hatchna/INDX/README.md

This is my personal fork for the INDX configuration files and macros. These may or may not be compatible with your printer. YMMV.

Much credit for some of these customizations goes to charliemayall and 3DPrintDemon who provided some of the macro adjustments and ideas that are implemented here.

https://github.com/charliemayall/INDX/

https://github.com/3DPrintDemon/DEMON_INDX

Other modifications are my own.

# INDX Wiki

> The community knowledge base for the Bondtech INDX, an induction-based automatic tool changer for open-platform XY-head 3D printers.

---

## Table of Contents

**Part 1: What is INDX?**

1. [What is INDX?](#what-is-indx)
2. [How It Works](#how-it-works)
3. [Kits & What's in the Box](#kits--whats-in-the-box)
4. [Supported Printers](#supported-printers)
5. [Technical Specifications](#technical-specifications)
   - [Part Cooling](#part-cooling)

**Part 2: Getting Started**

6. [Requirements & Preparation](#requirements--preparation)
7. [Installation](#installation)
   - [Hardware Installation](#hardware-installation)
   - [Firmware Configuration](#firmware-configuration)
     - [Klipper / Kalico](#klipper)
       - [INDX macro files](#indx-macro-files)
       - [Required Klipper sections](#required-klipper-sections)
       - [Load cell probe](#load-cell-probe)
       - [Automated dock X measurement](#automated-dock-x-measurement-built-in)
       - [Homing override](#homing-order-important)
         - [Seat check](#seat-check)
     - [RRF (RepRapFirmware)](#rrf-reprapfirmware)
   - [Initial Startup](#initial-startup)

**Part 3: Configuration**

8. [Configuration](#configuration)
   - [Dock Position Calibration](#dock-position-calibration)
     - [Finding dock_y](#finding-dock_y-y-fully-seated-position)
     - [Finding dock_x](#finding-dock_x-x-tool-centre)
   - [Tool Offsets](#tool-offsets)
     - [Method 1: Print and adjust](#method-1-print-and-adjust-free-no-extra-hardware)
     - [Method 2: Nudge](#method-2-nudge-automatic-requires-small-hardware)
     - [Method 3: Nozzle camera + CAL_ONE/TWO/THREE](#method-3-nozzle-camera-most-precise-xy-higher-cost)
     - [Z offset: CAL_Z](#z-offset-calibration)
   - [Temperature & Induction Settings](#temperature--induction-settings)
   - [Speed & Acceleration](#speed--acceleration)

**Part 4: Day-to-day Use**

9. [Using INDX](#using-indx)
   - [Loading Filament into Tools](#loading-filament-into-tools)
   - [Performing Tool Changes](#performing-tool-changes)
   - [Slicer Setup](#slicer-setup)

**Part 5: Designing for INDX**

10. [Designing for INDX](#designing-for-indx)
    - [Dock Design](#dock-design)
    - [Part Cooling (custom)](#part-cooling-1)
    - [CAD Files & Templates](#cad-files--templates)

**Part 6: Maintenance, Support & Community**

11. [Maintenance](#maintenance)
    - [Nozzle clog: cold pull procedure](#nozzle-clog-cold-pull-procedure)
12. [Troubleshooting](#troubleshooting)
13. [FAQ](#faq)
14. [Community & Contributing](#community--contributing)

---

**Part 1: What is INDX?**

---

## What is INDX?

INDX (INduction Dynamic eXtruder) is Bondtech's automatic tool-changer system for FDM 3D printers. It enables printing with multiple materials, colors, or nozzle sizes in a single print, with near-zero purge waste and tool changes in around 14 seconds. Run two tools or ten; scale your setup as far as your build space allows.

Unlike filament-switcher systems, INDX is a true tool changer: each tool carries its own filament directly. There is no shared filament path and no purge block required.

Unlike traditional mechanical tool changers, INDX uses wireless induction heating, so the passive tools contain **no wires, no heaters, no thermistors, and no electronics**. This makes each tool dramatically cheaper and mechanically simpler.

INDX is sold by Bondtech as a **Development Kit** for open CoreXY printers. Prusa Research has built an official first-party integration for the **CORE One** and **CORE One L**, sold directly through Prusa.

| | INDX Development Kit | Prusa CORE One / CORE One L |
|---|---|---|
| **Sold by** | Bondtech ([bondtech.se](https://www.bondtech.se)) | Prusa Research ([prusa3d.com](https://www.prusa3d.com)) |
| **For** | Most CoreXY printers with open firmware | Prusa CORE One / CORE One L |
| **Setup** | Self-managed (community-supported) | Plug-and-play |
| **Smart Head** | See [bondtech.se](https://www.bondtech.se) | See [prusa3d.com](https://www.prusa3d.com/applications/prusa-3d-printers-with-bondtech-indx_243519/) |
| **Passive Tools** | See [bondtech.se](https://www.bondtech.se) | See [prusa3d.com](https://www.prusa3d.com/applications/prusa-3d-printers-with-bondtech-indx_243519/) |

This wiki focuses on the **INDX Development Kit** and community integrations. For the Prusa integration, refer to [Prusa's documentation](https://www.prusa3d.com/applications/prusa-3d-printers-with-bondtech-indx_243519/).

---

## How It Works

INDX is built around two components: a single active **Smart Head** that stays on the gantry, and a set of interchangeable **Thin Passive Tools** parked in a dock.

### Smart Head

The single active unit that travels on the gantry. Contains all expensive and active components:

- **Induction coil (IN)**: wirelessly heats the nozzle of whichever passive tool is currently mounted on the Smart Head.
- **IR thermopile sensor**: reads nozzle temperature without physical contact. Also reports ambient temperature and nozzle surround temperature for monitoring.
- **Dynamic eXtruder (DX)**: self-adjusting dual-drive extruder with automatic tension mechanism.
- **Load cell**: used for sensing tool/nozzle touch.
- All wiring, electronics, and motion stays here; nothing transfers to the passive tools

### Thin Passive Tools

Interchangeable tools parked in a dock within reach of the gantry. Each tool contains a filament path and a specially designed nozzle, and nothing else. No wires, no heaters, no thermistors, no electronics. Heat is delivered wirelessly by the Smart Head's induction coil when the tool is picked up; the tool cools passively when deposited back in the dock.

Two variants are available, both built from steel:

- **CHT (Core Heating Technology)**: splits filament into three strands internally for faster melting and higher flow rates. The standard choice for most materials except abrasive materials. Available in common sizes.
- **Standard (non-CHT)**: straight-through melt zone with lower back-pressure, optimized for soft flexible filaments (TPU, TPE).

Tools are held in the Smart Head by a high-precision **Maxwell coupling** (a 3-point kinematic coupling that self-aligns the tool to the exact same position every time it is picked up), ensuring micron-level repeatability on every tool change. In practice this means you calibrate your tool offsets once, and they stay correct across thousands of tool changes.

### Tool Change Sequence

1. Smart Head moves to the dock and deposits the current tool
2. Smart Head picks up the next tool
3. Induction coil heats the new nozzle to printing temperature (~4-10 seconds)
4. Printing resumes

**Total tool change time: ~14 seconds**, depending on temperature delta, priming, and travel distance.

Because every material runs in its own dedicated nozzle, there is no cross-contamination between materials; purging is not required. The only material used after a tool change is a small **prime** at the start of printing: when a nozzle heats up, the filament in the melt zone re-melts and pressure needs to be rebuilt before extrusion is consistent. Priming pushes a small amount of filament through to establish that pressure, ensuring the first line of print is correctly extruded. Because each tool also cools passively when separated from the Smart Head, oozing is minimal.

---

## Kits & What's in the Box

### Development Kit

The INDX Development Kit comes as a **base kit** (the core hardware you need to get started) plus **tools** and **accessories** you choose to match your printer and setup.

#### What's in the box

Every Development Kit includes:

| Component | Description |
| --- | --- |
| **Bondtech INDX Smart Head** | The active unit: induction coil, contactless IR temperature sensor, DX extruder, and all electronics. One per printer. **Does not include a Thin Passive Tool**; tools are ordered separately. |
| **Bondtech INDX Link Board** | USB/CAN bridge between your host computer and the Smart Head. Includes 330 mm AWG18 power cables with horseshoe connectors for PSU screw terminals. A USB cable from the Link Board to your host is not included; see [Link Board](#link-board) for requirements. |
| **Crimp & connector kit** | Crimps and connectors for terminating accessories to the Bondtech INDX PCB: part cooling fan, LED, endstop, and USB devices. |

#### Tools

Thin Passive Tools are the interchangeable tool heads that do the actual printing. Choose quantity, nozzle type, and nozzle size when ordering. You need at least one tool to print, and one per material or color you want to run simultaneously.

| Option | Nozzle sizes | Best for |
| --- | --- | --- |
| **CHT (Core Heating Technology)** | 0.4 / 0.5 / 0.6 / 0.8 / 1.0mm | Most materials: PLA, PETG, ABS, ASA, TPU, TPE, PVA, BVOH, HIPS, PC, Nylon, PP, PBT, unfilled PC blends, and other non-abrasive filaments |
| **Standard (non-CHT)** | 0.25 / 0.4mm | Flexible filaments (TPU, TPE) and sensitive composites |

See [Thin Passive Tools](#thin-passive-tools) in the Technical Specifications for full details on each variant.

#### Accessories

Select the accessories that match your printer when ordering:

| Accessory | Options | Notes |
| --- | --- | ----- |
| **Bondtech INDX Link Cable** | Choose length | XT30 2+2 cable (24V, GND, CAN+, CAN−) with a shield connected to GND on the Link Board, from the Link Board to the Smart Head. Red/black wires carry power, yellow/white carry CAN H/L. Choose the length that fits your wiring run. See note below. |
| **Tool Dock** | Pre-made SLS hardware or STL/STEP files | Bondtech's ready-made docks are designed for MakerBeam XL 15×15. Or download the files and print your own; the standard 1515 body suits both profiles. |
| **X-Carriage adapter** | MGN12H option for 6mm belts, or download files | Required to mount the Smart Head to your carriage. Available for common CoreXY standards; check the shop or download from GitHub. |

> **What is CAN bus?** CAN bus is a communication standard that lets multiple devices share a single cable. You don't need to understand the protocol in depth; the Link Board handles it for you. In practice it means the Smart Head connects to the Link Board via just one 4-wire cable (carrying both power and data) instead of the bundle of wires a conventional toolhead needs. CAN is currently only supported on RRF; USB is used for Klipper/Kalico.
>
> **Choosing cable length:** Measure the wiring run from your Link Board mounting location to the Smart Head along the actual path the cable will travel (over the gantry, not straight-line). Add some slack. When in doubt, order longer. A cable that is too short cannot be extended, and excess length can be coiled and managed.

> **Integration note:** The Development Kit does not include a pre-configured printer profile or plug-and-play setup. You are responsible for integrating INDX with your printer's firmware and mechanics. The community provides configs and guides for common platforms; see [Supported Printers](#supported-printers) and [Community & Contributing](#community--contributing).

---

## Supported Printers

### First-party integrations

Prusa Research has built an official first-party integration for their CoreXY printers. These are sold and supported directly by Prusa, not through the INDX Development Kit.

| Printer | Status | Notes |
| --- | --- | ----- |
| Prusa CORE One | Available | Sold by Prusa Research. Plug-and-play. Supports up to 8 tools. See [prusa3d.com](https://www.prusa3d.com/applications/prusa-3d-printers-with-bondtech-indx_243519/) for details. |
| Prusa CORE One L | Coming later | First-party Prusa integration, availability timeline TBD. Supports up to 8 tools. |

### Officially recognized integrations

Beyond the first-party Prusa integration, a few community-built integrations are solid enough that Bondtech points people at them by name. Each comes with ready-to-print parts and the installation files needed to mount INDX on that machine.

They are not Bondtech products. They are hosted externally and maintained by their designers, so questions about the parts themselves belong with them rather than in this repository. Recognized here means we rate the work, not that we support it.

| Printer | Designer | Files |
| --- | --- | ----- |
| Sovol SV08 OG & SV08 Max | 3DPrintDemon | [Printables](https://www.printables.com/model/1771164-official-indx-sovol-sv08-og-sv08-max-integrations) |
| Voron Trident R2 | Steve — Voron team, designer of the Trident | [Printables](https://www.printables.com/model/1761163-trident-r2-bondtech-indx-mods) |

### Unverified community builds

INDX runs on a wide range of CoreXY printers, far more than Bondtech could ever test and support directly. What makes that possible is community members who've done the integration work on their own printer and shared what they learned. The printers below are known to work; what varies is whether anyone has published parts for them yet.

> ⚠️ **Nothing in this table has been checked by Bondtech.** We have not printed these parts, measured them, or run them on a machine here. Listing a build is not an endorsement and says nothing about whether the geometry is right. Read them the way you would read any stranger's remix: check a dock against [Dock Design](#dock-design) before printing it, since dock geometry that misses those constraints gives unreliable tool changes rather than an obvious failure. Questions about these parts belong with whoever made them, not with Bondtech.

| Printer | Build | Source |
| --- | ----- | --- |
| Voron 2.4 | Full conversion parts set: X-carriage, tool holder, XY joint, front idlers, Z bearing block with Y endstop, Z chain mount | [karasgit/INDX-for-Voron-2.4](https://github.com/karasgit/INDX-for-Voron-2.4), with a [walkthrough video](https://www.youtube.com/watch?v=topIOL-b3Gw) by Emplikac 000 |
| RatRig V-Core | None published yet | — |
| Custom CoreXY | None, and none expected: mounting is specific to your machine | Any CoreXY with open firmware works; see [Requirements](#requirements--preparation) |

The [Bondtech Discord](https://discord.gg/XDX9jDXN6e) has channels for specific printers, which is the best place to find someone running the same platform and ask how far along they got.

**Your printer isn't listed?** If you've got INDX running on it, that integration belongs here. Submit a pull request on [github.com/BondtechAB/INDX](https://github.com/BondtechAB/INDX) and you'll save the next person hours of work. See [Contributing a printer integration](#contributing-a-printer-integration) for what to include.

---

## Technical Specifications

*Specifications are preliminary and subject to change.*

### Smart Head

| Specification | Value |
| --- | ----- |
| Maximum operating voltage | 24V |
| Maximum nozzle temperature | 300°C |
| Maximum ambient operating temperature | 60°C |
| Flow rate | 40mm³/s *(measured at 220°C with 25°C ambient; lower rates achievable depending on nozzle size)* |
| Nozzle heat-up time | ~4-8 seconds |
| Tool change time | ~14 seconds *(highly dependent on temperature, priming, and travel distance)* |
| Power consumption | ~60W |
| Tool change mechanism | Maxwell coupling (3-point kinematic) |
| Heater type | Induction coil |
| Temperature sensor | Wireless & contactless IR thermopile |
| Nozzle sensor | Load cell (bi-directional) |
| Extrusion system | Direct Drive |
| Filament pre-tension | Self-adjusting (DX extruder, dual-drive with automatic tensioning) |
| Extruder chassis material | Aluminium |
| Cowling material | SLS-printed PA12 |
| Minimum tool center-to-center distance | 34mm bare; **41mm** with Bondtech part cooling solutions |
| Weight | 345g *(including one tool)* |
| Dimensions | See [reference geometry](#cad-files--templates) |

### Part Cooling

INDX uses a modular part cooling system. Cooling solutions snap onto the outside of the Smart Head cowlings, making it easy to swap between setups without tools. Three options are supported:

| Option | Description |
| --- | --- |
| **Dual 40×10 fans** | Two radial blower fans mounted symmetrically for balanced airflow around the nozzle |
| **CPAP** | High-flow airflow from a remote CPAP blower unit, routed via a flexible tube to the Smart Head, keeping weight off the gantry |

The right choice depends on your materials and print speed requirements. The dual 40×10 connect to the part cooling fan output on the Bondtech INDX PCB. The CPAP blower is a remote unit mounted elsewhere on the printer and connects to your main board instead; only the airflow tube routes to the Smart Head.

Printable ducts for both options are available in [CAD Files & Templates](#cad-files--templates).

### Bondtech INDX PCB

The Bondtech INDX PCB is mounted inside the Smart Head and is the central electronics board for the system.

**Electronics**

| Specification | Value |
| --- | ----- |
| Stepper driver | TMC2240 |
| Stepper run current | 0.6A |
| Extruder rotation distance | 5.7mm |
| Built-in accelerometer | LIS2DW |
| Built-in rotary encoder | AS5047D (magnetic) |
| Built-in load cell | *(specifications to be confirmed)* |

**Connectors**

| Connector | Pins | Notes |
| --- | ---- | ----- |
| Motor | Coil A+, Coil A−, Coil B+, Coil B− | DX extruder stepper motor |
| Fan | TACHO, FAN+, GND | Supports tachometer feedback |
| LED | 5V (VBUS), NP OUT, GND | NeoPixel compatible |
| Endstop | 3V3, SIGNAL, GND | 3.3V logic level |
| USB | VBUS, DP+, DP−, GND, GND | Supports accessories such as camera or Beacon probe scanner. **The DP+/DP− silkscreen is swapped — see [USB data pins](#usb-data-pins-are-swapped)** |
| CAN termination jumper | — | Enable/disable CAN bus termination |
| CAN Reset jumper | — | Puts the board into DFU mode for firmware flashing; remove after flashing |
| Communication switch | CAN / USB | Selects between CAN-FD and USB communication modes; must match the switch position on the Link Board |

**Status LEDs**

| Label | Colour | Meaning |
| ----- | --- | --- |
| VIN | Blue | 24V power present |
| 3V3 | Green | 3.3V onboard regulator active |
| ACTIVITY | Green | CAN-FD bus activity (other than regular time-sync messages) |
| STATUS | Red | Flashes at ~1Hz in sync with the main board = CAN time sync OK; rapid continuous flashing = no CAN sync; startup error codes (see table below) |

On first boot or after a failed flash, the STATUS LED may flash a startup error code rather than the normal 1Hz pattern. The pattern is: slow blinks (group 1) pause, then fast blinks (group 2). If this happens, reflash the firmware.

**Startup error codes**

| Error | Slow blinks | Fast blinks | Description |
| ----- | --- | --- | --- |
| ErrorTempMin | 1 | 1 | Measured temperature too low |
| ErrorTempMax | 1 | 2 | Measured temperature too high |
| ErrorTempAmbientMin | 1 | 3 | Ambient temperature too low |
| ErrorTempAmbientMax | 1 | 4 | Ambient temperature too high |
| ErrorTempDiff | 1 | 5 | Requested temperature differs significantly from measured temperature |
| ErrorHeatMax | 2 | 1 | Heater on at max power for too long |
| ErrorHeatInput | 2 | 2 | Heater enable request active for too long |
| ErrorInternalTemp | 5 | 3 | IR sensor self-test failed at boot |
| ErrorInternalUart | 5 | 4 | Internal UART fault |
| ErrorInternalEnable | 5 | 5 | Internal enable fault |

**Front INDX LED states**

The Smart Head uses a NeoPixel-compatible LED array on the front face to communicate its current state during normal operation. These are the same LEDs that display startup error codes.

| State | Colour | Pattern |
| ----- | --- | --- |
| Heating | Amber (RGB 255, 191, 0) | Breathing at 0.5 Hz (sine); brightness starts at 0 and increases as temperature approaches target |
| Cold / at ambient | Green | Solid |
| At target temperature | Amber | Solid |
| Cooling down from hot | Blue | Solid |
| DFU (firmware update) mode | Blue | Blinking |
| Load cell transient (filament gripped) | Purple | Single fast flash (~200 ms), then returns to previous state; effect is suppressed while the stepper motor is energised |

**FFC cable warning**

The Smart Head contains two PCBs (INDX VF PCB and INDX MCU PCB) connected by 20-way FFC (Flexible Flat Cable) connectors. If you ever need to disconnect and reconnect them during servicing:

- Insert the cable straight; inserting at an angle is easy to do and will short pins. Powering up with a shorted FFC will likely damage the board.
- The latch direction on the INDX MCU PCB FFCs is counter-intuitive: the latch is **unlocked when up**. After inserting the cable, push the latch **down toward the PCB** to lock it.

### Link Board

Bondtech INDX Link Board

The Link Board is a required component of every INDX Development Kit setup. It sits between your host computer and the Smart Head, acting as the USB/CAN bridge and providing several protection features that make the connection stable and safe.

**Why the Link Board is required**

The Link Board caps USB communication speed to **12 Mbps (Full Speed)**. While this is lower than the theoretical USB 2.0 maximum, it is intentional: Full Speed USB is dramatically more stable in electrically noisy printer environments than High Speed (480 Mbps). In practice this means fewer dropouts and disconnects, and a much more reliable connection to the Smart Head.

**Protection features**

| Feature | What it does |
| --- | --- |
| **USB isolator** | Electrically isolates the Smart Head from your host computer. Any electrical fault or noise on the printer side cannot travel back through the USB cable to your Raspberry Pi or PC. |
| **Reverse polarity protection** | Prevents damage if the 24V power input is connected with reversed polarity. |
| **4A fuse** | Protects the power input. If something goes wrong on the 24V side, the fuse blows before damage can propagate further. |

**Communication switch**

The Link Board has a switch to select between **USB** and **CAN** communication modes. This must match the switch position on the INDX MCU PCB inside the Smart Head — both boards must be set to the same mode, or the connection will not work. See [Switch configuration](#3-wiring) for reference images showing the correct switch positions on the Smart Head side.

**USB cable (not included)**

A USB cable from the Link Board to your host computer is not included and must be sourced separately. Requirements:

- **Data cable, not a charge-only cable.** Charge-only cables omit the data lines entirely and will not work. Verify the cable is rated for data transfer before using it.
- **Correct impedance.** The cable must meet USB signal integrity requirements. Cheap or poorly made cables can cause dropouts even at Full Speed. Use a cable from a reputable brand.
- **Total USB run ≤ 2 meters.** The combined length of your USB cable (host to Link Board) and your INDX Link cable (Link Board to Smart Head) must not exceed 2 meters. Plan your cable routing and Link cable length selection with this in mind.

**Specifications**

| Specification | Value |
| --- | ----- |
| Host connection | USB-C |
| Printer-side connection | Link cable to Bondtech INDX PCB |
| Input power | 24V + GND from PSU |
| Included power cables | AWG18, 330mm, horseshoe connectors for PSU screw terminals |
| USB speed | 12 Mbps (Full Speed) |
| Fuse rating | 4A |
| Max total USB run | 2 meters (USB cable + Link cable combined) |

### Thin Passive Tools

All Thin Passive Tools are built from steel, contain no electronics or wiring, and use induction heating via the Smart Head. Two variants are available:

**CHT (Core Heating Technology): Standard choice for most materials**

Uses Bondtech's patented CHT internal geometry, which splits filament into three thinner strands for faster melting and higher flow rates. Recommended for PLA, PETG, ABS, ASA, TPU, TPE, PVA, BVOH, HIPS, PC, Nylon, PP, PBT, unfilled PC blends, and other non-abrasive filaments.
Not recommended for soft flexible filaments.

| Specification | Value |
| --- | ----- |
| Available nozzle sizes | 0.4 / 0.5 / 0.6 / 0.8 / 1.0mm |
| Material | Steel |
| Compatible filament diameter | 1.75mm |
| Maximum nozzle temperature | 300°C |
| Electronics | None |
| Weight | 25g |

**Standard (non-CHT): For flexible and sensitive materials**

Uses a straight-through melt zone with minimal back-pressure, specifically optimized for soft flexible filaments (TPU, TPE) and sensitive composites. Built to the same steel standard.

| Specification | Value |
| --- | ----- |
| Available nozzle sizes | 0.25 / 0.4mm |
| Material | Steel |
| Compatible filament diameter | 1.75mm |
| Maximum nozzle temperature | 300°C |
| Electronics | None |
| Weight | 25g |

---

**Part 2: Getting Started**

---

## Requirements & Preparation

If you've built a Voron or a similar CoreXY printer from scratch, you have the skills needed to install INDX. The process involves editing Klipper config files, SSH access to your host computer, and careful mechanical alignment. Nothing beyond what a first-time Voron builder will have already done.

### Printer Requirements

For the Development Kit, your printer must meet these minimum requirements:

- **Motion system:** CoreXY, H-bot, Markforged, Cartesian XY-head, or similar. Supported: any motion system where the toolhead moves in XY and Z is handled by the bed or gantry — i.e. CoreXY (not cross-gantry), H-bot, Markforged, and independent-axis Cartesian (XY-head, e.g. Ender 5). Not supported: bed-slinger Cartesian (XZ-head), where the bed moves in Y, or Positron-style machines.
- **Firmware:** Kalico (recommended — native INDX support built in), Klipper, or RepRap Firmware (RRF)
- **Gantry clearance:** 50mm X, 44mm Y. Total toolhead height is ~152mm including strain relief. Additional clearance is required for umbilical and filament management.
- **Dock mounting area:** Each dock is ~70mm tall, 28.5mm wide (X), and 25mm deep (Y). Minimum tool center-to-center spacing is 34mm bare, or 41mm when using the Bondtech part cooling solutions.
- **Wiring:** 24V from the PSU to the Link Board (AWG18 horseshoe-connector cables included). Host computer to Link Board via USB-C or CAN. Link Board to Smart Head via INDX Link Cable (XT30 2+2, carries 24V, GND, CAN+/−, and shield).
- **Print volume impact:** Depends on printer geometry. Printers with sufficient Y overtravel may lose nothing. With a well-designed integration the worst case is 28.5mm of Y travel; avoid designs that exceed this.

### Electrical Requirements

INDX uses two boards: the **Bondtech INDX PCB** (inside the Smart Head) and the **INDX Link Board**.

**Bondtech INDX PCB**

The Bondtech INDX PCB is the central electronics board inside the Smart Head. It consists of two parts connected internally:

- **INDX VF PCB**: handles induction heating, contactless IR temperature sensing, and the heatsink fan
- **INDX MCU PCB**: handles all processing and communication: extruder motor control, accelerometer, load cell, CAN-FD communication, and the external connectors

All electronics are pre-installed inside the Smart Head; no internal wiring required. The Smart Head connects to the Link Board via a single INDX Link Cable (24V, GND, CAN H/DP+, CAN L/DN−, shield to GND) and exposes the following connectors:

- **Motor**: 4-pin, drives the DX extruder (TMC2240 driver). Pin 1 Coil A+, Pin 2 Coil A−, Pin 3 Coil B+, Pin 4 Coil B−
- **Endstop**: 3-pin, 3.3V logic level. Pin 1 3V3, Pin 2 SIGNAL, Pin 3 GND
- **Fan**: 3-pin, supports tachometer feedback. Pin 1 TACHO, Pin 2 FAN+ (PWM 24V), Pin 3 GND
- **LED**: 3-pin NeoPixel. Pin 1 5V (VBUS), Pin 2 NP OUT, Pin 3 GND
- **USB**: 5-pin, supports accessories such as a camera or Beacon probe scanner. Pin 1 VBUS (5V), Pin 2 DP+, Pin 3 DP−, Pin 4 GND, Pin 5 GND. **The DP+ and DP− labels are swapped relative to the actual signals — see [USB data pins](#usb-data-pins-are-swapped) before wiring anything to this connector**
- **Built-in accelerometer**: for resonance measurement and automatic input shaper calibration in Klipper
- **CAN termination jumper**: fitting the jumper enables the 120 Ω end-of-line termination resistor. Fit only on boards at the physical ends of the CAN bus.
- **CAN reset jumper**: Klipper: short the jumper to enter DFU mode for flashing. RRF: fit the jumper for CAN reset (also resets the CAN address). See the [Duet INDX Toolboard documentation](https://docs.duet3d.com/en/Duet3D_hardware/Duet_3_family/INDX_Toolboard).
- **Status LEDs**: 3V3, VIN, STATUS, ACTIVITY

Induction heating and contactless IR temperature sensing are handled internally by the INDX VF PCB; no additional wiring or configuration needed.

Bondtech INDX PCB pinout

##### USB data pins are swapped

> ⚠️ **The DP+ and DP− labels on the USB connector are wrong.** The pin marked **DP+ is electrically DP−**, and the pin marked **DP− is electrically DP+**. This applies to the silkscreen, the pinout image above, and the pin tables in this document. Wire by function, not by label.

So a USB accessory connects like this:

| INDX pin | Marked | Actually is | Connect to |
| --- | --- | --- | --- |
| 1 | VBUS | VBUS (5V) | 5V |
| 2 | DP+ | **DP−** | DATA − |
| 3 | DP− | **DP+** | DATA + |
| 4 | GND | GND | Ground |
| 5 | GND | GND | — |

For a Cartographer V4, whose own wiring guide lists black = Ground, green = DATA +, white = DATA −, that means green goes to the pin marked DP− and white goes to the pin marked DP+. Two users independently found that wiring by the printed labels fails to enumerate and that swapping the pair works.

If a USB accessory isn't detected at all, this is the first thing to check.

**Klipper pin → port mapping** (not exposed in RRF)

| Function | Port(s) |
| --- | --- |
| Motor | STEP `PB12` · DIR `PB23` · ENN `PB4` · CS `PA10` · SPI1 SCLK `PA5` / MOSI `PA4` / MISO `PA7` |
| Endstop | `PA9` |
| Part cooling fan | FAN `PA1` · TACHO `PA0` |
| Heatsink fan | FAN0 `PA21` · TACHO `PA20` |
| Neopixel | `PA8` |
| Eddy scanner | ldc_int `PB10` · ldc_clk `PB11` · temp_ldc `PB9` |

**Link Board**

The Link Board is required and bridges your host computer to the Smart Head. For full details on protection features, the communication switch, and USB cable requirements, see [Link Board](#link-board) in the Technical Specifications.

For wiring purposes:

- Requires **24V and GND** from your printer's power supply; connect using the included power cables (AWG18, 330 mm, pre-terminated with horseshoe connectors for screw terminal PSUs)
- Connects to the Smart Head via the INDX Link Cable
- Connects to your host computer via USB (cable not included — see [Link Board](#link-board) for requirements)
- The communication switch on the Link Board must match the switch on the INDX MCU PCB; both must be set to the same mode

**Power**

- The system runs on **24V**
- The Link Board is powered by a direct 24V/GND connection from your PSU
- Power is then passed through the Link cable (24V, GND, CAN+/D+, CAN−/D-) from the Link Board to the Smart Head; no additional PSU connection needed at the Smart Head

**Mainboard compatibility**

- Works with any printer running a Raspberry Pi, similar host computer or Duet board
- The Link Board connects to the host via CAN/USB; the host handles CAN/USB communication to the Bondtech INDX PCB

### Software Requirements

- **Kalico (recommended):** native INDX support is built in — nothing to install on the host, and the MCU firmware ships with Kalico. See [Firmware Configuration](#klipper).
- **Klipper (mainline):** add the [`indx_klipper`](https://github.com/BondtechAB/indx_klipper) module (installed with its `install.sh`), which brings the same INDX support to a stock Klipper install. See [Firmware Configuration](#klipper).
- RRF: RepRapFirmware **3.7.0-alpha (2026-02-10) or later**, required on both the main board and the Bondtech INDX PCB.
- Slicer: Any slicer with multi-filament or multi-color support

### Tools Required

| Tool | Use |
| ---- | --- |
| Hex keys | Smart Head, X-carriage adapter, and dock mounting |
| Crimping tool | Optional; only needed if connecting accessories (fan, LED, endstop, or USB devices) to the Bondtech INDX PCB |

### Skills Assumed

- Editing Klipper config files (`.cfg` syntax, adding sections, restarting Klipper)
- SSH access to your host computer (the [Connect via SSH](#connect-to-your-printer-via-ssh) section covers this if you need a refresher)
- Crimping JST and similar connectors

### What to Have Ready Before Starting

- A working printer, homed, printing, and confirmed stable before you begin
- Kalico (or Klipper / RRF) installed and running on your host computer
- SSH access to your host computer confirmed
- Spool holders and filament routing planned for the number of tools you intend to run

---

## Installation

> **Note:** These are general installation guidelines using the Bondtech-sold hardware as an example. Because INDX works across many different CoreXY printers, exact details (screw sizes, adapter geometry, carriage type, dock placement) will vary by printer. For printer-specific integration guides, check the [github.com/BondtechAB/INDX](https://github.com/BondtechAB/INDX) repository and the community resources in [Community & Contributing](#community--contributing).

### Hardware Installation

#### 1. Install the Smart Head

The Smart Head replaces your printer's existing toolhead entirely. It mounts to the X-axis carriage using a two-part system:

1. **X-carriage adapter**: bolts onto your carriage
2. **Smart Head**: attaches to the X-carriage adapter with 4 bolts

**X-carriage adapters** are available in two ways:

| Source | Material | Notes |
| --- | --- | --- |
| Bondtech (shop) | SLS-printed Nylon 12 GF | Common MGN12 carriage options available to purchase |
| GitHub / community | User-printed | Printable MGN12H adapter (6mm belts) in the repo; use the reference STEP to adapt one for other carriages |

If your carriage configuration isn't covered by Bondtech's sold options, the repository has a printable MGN12H adapter for 6mm belts in [CAD Files & Templates](#cad-files--templates). For anything else, the reference STEP in the same section carries the mounting geometry to design against, and the [officially recognized integrations](#officially-recognized-integrations) above cover some specific printers. Community-made X-carriage designs that meet quality standards are welcome in the repo via pull request.

> **Before you start:** Remove your existing hotend, part cooling fan, and any toolhead PCB or wiring mounted on the carriage. The Smart Head replaces all of this.

**Step 1: Mount the X-carriage adapter to the carriage**

Route and attach the belts behind the X-carriage, then attach the X-carriage adapter to your carriage block using the screws specified for your adapter. Tighten firmly but do not overtighten.

INDX MGN12H adapter mounting to rail, exploded view

INDX MGN12H adapter mounted on rail

**Step 2: Place the Smart Head onto the adapter**

Slide the Smart Head onto the X-carriage adapter so the mounting faces are flush.

Smart Head placed on X-carriage adapter

**Step 3: Secure the Smart Head**

Fasten the Smart Head to the adapter using 4 screws as specified for your adapter. Tighten firmly but do not overtighten.

Smart Head secured, rear view

Smart Head fully installed, front view

The Smart Head is now installed on the carriage.

**Attach part cooling**

Part cooling solutions snap onto the outside of the Smart Head cowlings. Attach your chosen cooling solution now before mounting the dock.

**Installing the fan shroud clip**

The clip is the interface between a fan shroud and the Front Cover, and there is a left and a right one: [`INDX_Part_Cooling_Interface_left.stl`](CAD/STL/INDX_Part_Cooling_Interface_left.stl) and [`INDX_Part_Cooling_Interface_right.stl`](CAD/STL/INDX_Part_Cooling_Interface_right.stl). Print both before starting, and repeat these steps for each side.

1. Loosen the screw that holds the INDX Front Cover.

   Loosen front cover screw

2. Use an M3×8 screw to secure the INDX Front Cover together with the fan shroud clip.

   Fan shroud clip installed

3. With the clip installed, attach the fan shroud to the Front Cover. The shroud has an upper tab that locates into a slot at the top of the Front Cover (highlighted in blue). Align the tab with the slot, then rotate the bottom of the shroud inward until it seats in position.

   Fan shroud mounted

#### 2. Mount the Dock

The dock can be positioned anywhere within the gantry's travel range, but the Smart Head must be able to face the docked tools directly to pick them up. The right location depends on your printer's layout.

**Frame requirement**

The dock must be mounted to a rigid bar or frame element; the dock hardware alone cannot be free-standing. Most CoreXY printers have an extrusion or crossbar that works for this. If your printer does not have a suitable mounting point, you will need to add one before proceeding.

The dock hardware Bondtech sells is designed for **MakerBeam XL 15×15**.

> 💡 **A note on fasteners.** MakerBeam XL has an indexing track running down the slot, so despite both profiles being 15×15 the two do not take a fastener quite the same way. The MakerBeam XL body still mounts fine on standard 1515 extrusion, so a ready-made dock or an already-printed MakerBeam XL body is not wasted if that is your frame. Standard T-nuts are the fiddly part: expect to shave a little material off one to clear the track. A printed M3 nut carrier for 1515 is the easier route if you have that body already.

If you are printing your own, the repository has two dock bodies. The **standard 1515** one suits both profiles, which makes it the easier all-round choice. See [CAD Files & Templates](#cad-files--templates). For any other frame, design your mounting to suit it.

> ⚠️ **Critical:** The dock has strict positioning requirements that must be met for reliable tool changes. Incorrect placement will cause failed pickups. See the critical requirements below before mounting.

**Dock options:**

| Source | Type | Mounting |
| --- | --- | --- |
| Bondtech (shop) | SLS-printed Nylon 12 GF | Designed for MakerBeam XL 15×15 |
| GitHub | Reference design + community designs | Print yourself, or adapt for your frame |

Community-contributed dock designs live in [`community/`](community/) in the repository. There is a [2020 extrusion dock](community/1_printer_agnostic/2020-dock/) there already if your frame is 2020 rather than 15×15, along with a [magnet jig](community/1_printer_agnostic/magnet-jig/) that makes dock assembly considerably less painful. If you design a dock for an unlisted printer or frame, consider submitting it. See [Dock Design](#dock-design) for geometry constraints and design requirements before you start.

**Critical dock positioning requirements**

**Height**

The dock must be positioned so that a parked tool sits **2mm higher** than it does when held in the Smart Head. This offset is what allows the Smart Head to pick up and deposit tools cleanly.

Dock height reference: 2mm offset between docked and picked-up tool position

**Alignment method**

Use the printable alignment jig ([`INDX_Dock_calibration_tool.stl`](CAD/STL/INDX_Dock_calibration_tool.stl)) placed over the nozzle tool in the toolhead to set the correct height. The printer does not need to be powered on for this step; you are setting the physical dock height manually.
_Pro tip: you can also use the alignment jig to get exact X alignment of the docks, by moving your printhead to the desired X value before doing the steps below._

1. Place the printed alignment jig over the tool magnets while the tool is in the smart head.

   Alignment jig fitted over the tool magnets on the Smart Head

2. Loosen the bar holding screws in order to let it be adjusted up and down, then slide the smart head toward the tool dock and make sure the alignment jig enters the magnet holes smoothly without the smart head nodding from mechanical strain.

   Alignment jig entering the tool holder magnet holes in the dock

3. Secure the dock bar at that height

#### 3. Wiring

Wiring up the Smart Head is unusually simple for a toolhead. On a conventional setup, you're running individual wires for the heater cartridge, thermistor, hotend fan, stepper motor, and any probes or sensors, each terminated, routed, and managed separately. With INDX, all of that is internal: the induction coil, IR temperature sensor, and heatsink fan are all handled inside the Smart Head with no external connections required. The only cable you run to the Smart Head is a single INDX Link Cable, four wires carrying 24V power and data.

The included **Link Board** acts as the bridge between your host computer and the Smart Head. Your host computer connects to the Link Board via USB (cable not included — see [Link Board](#link-board) for requirements), the Link Board connects to the Smart Head via the INDX Link Cable, and the Link Board receives 24V power from the PSU via the included AWG18 cables. That's the entire wiring run.

**Overview of connections:**

```
24V PSU ──────────────────────────────────────────────┐
                                                       │ 24V + GND
Raspberry Pi / host computer                           ▼
    │                                             Link Board
    └── USB ──────────────────────────────────────────►│
                                                       │
                                                       └── Link cable (24V, GND, CAN H/DP+, CAN L/DN−) ──► Bondtech INDX PCB (inside Smart Head)
                                                                                                           │
                                                                                                           ├── Motor (Coil A+, Coil A−, Coil B+, Coil B−)
                                                                                                           ├── Fan (TACHO, FAN+, GND)
                                                                                                           ├── LED (5V, NP OUT, GND)
                                                                                                           ├── Endstop (3V3, SIGNAL, GND)
                                                                                                           └── USB (VBUS, DP+, DP−, GND, GND)
```

**Switch configuration**

Before connecting the Link cable, set the communication mode switches on **both boards** to match: the switch on the INDX MCU PCB inside the Smart Head, and the switch on the Link Board. Both must be set to the same mode or the connection will not work.

Set both switches to **CAN** if you are using RRF. Set both to **USB** if you are using Klipper or Kalico.

INDX MCU PCB switch set to CAN mode
*Switch set to CAN mode*

INDX MCU PCB switch set to USB mode
*Switch set to USB mode*

#### 4. Flash the Bondtech INDX PCB

The Bondtech INDX PCB needs to be flashed with the correct firmware before the Smart Head can communicate with your printer. The flashing process differs depending on your firmware; follow the section for your setup.

##### Klipper / Kalico

Flashing is done over SSH from your computer into the Raspberry Pi (or other host computer) running Kalico or Klipper.

**What you need**

- **PuTTY**: a free SSH client for Windows. Download it from [its official site at chiark.greenend.org.uk](https://www.chiark.greenend.org.uk/~sgtatham/putty/latest.html), Simon Tatham's own page. `putty.org` is not affiliated with the project.
- Your printer's **IP address**: find this in your router's device list, or check the display on your host if it shows one. You can also use the hostname (e.g. `mainsailos.local` or `fluidd.local`) if your network supports it.

###### Connect to your printer via SSH

1. Open PuTTY
2. Enter your printer's IP address (or hostname) in the **Host Name** field
3. Make sure **Port** is set to `22` and **Connection type** is `SSH`
4. Click **Open**
5. Log in with your printer host credentials; the default username for most Klipper distributions is `pi` (Mainsail OS / FluiddPI) with the password you set during setup

You should now have a terminal prompt on your printer's host computer.

**Enter the bootloader**

Flashing happens while the Bondtech INDX PCB is in bootloader mode. If the board already has firmware, put it into the bootloader by fitting the **CAN RESET jumper** on the INDX MCU PCB while powering the board up. In bootloader mode the board enumerates on the host as a Microchip USB device (vendor `04d8`, product `e483`), identified as **"INDX Toolboard Bootloader"** by Bondtech AB. Confirm it is present with:

```bash
lsusb | grep 04d8:e483
```

**Kalico (recommended)**

Kalico ships with native INDX support built in — both the host module and the MCU firmware are part of the Kalico source tree, so there is nothing extra to install. Build and flash from your Kalico directory (usually `~/klipper`):

```bash
cd ~/klipper
KCONFIG_CONFIG=board_configs/bondtech_indx_usb.config make
KCONFIG_CONFIG=board_configs/bondtech_indx_usb.config make flash FLASH_DEVICE=04d8:e483
```

The `board_configs/bondtech_indx_usb.config` build config is included with Kalico. It preselects the SAME51 MCU, USB communication, and the INDX heater feature, so you don't need to run `make menuconfig`.

**Klipper (mainline)**

Mainline Klipper does not include INDX support. Add it with the `indx_klipper` module, then build and flash:

```bash
git clone https://github.com/BondtechAB/indx_klipper.git
cd indx_klipper
./install.sh /home/pi/klipper        # adjust the path to your Klipper install
make
make flash FLASH_DEVICE=04d8:e483
```

Once flashing is complete, remove the CAN RESET jumper (if you fitted one), power-cycle the Smart Head, and proceed to firmware configuration.

##### RRF (RepRapFirmware)

For RRF, flash and configure the Bondtech INDX PCB following the [Duet INDX Toolboard documentation](https://docs.duet3d.com/en/Duet3D_hardware/Duet_3_family/INDX_Toolboard).

#### 5. Load Passive Tools into the Dock

**Verify the Tool Dock Activator**

Before loading tools, check that the Tool Dock Activator is correctly installed. It is a small bracket mounted upright on the 15×15 mm aluminium extrusion using an M3×10 screw and an M3 nut. It must be perfectly vertical; this is the component that triggers the INDX latch mechanism during pickup.

Tool Dock Activator mounted on extrusion

Check that it is perpendicular to the extrusion:

Tool Dock Activator vertical alignment

**Load tools into the dock**

One passive tool fits in one dock position. Tools are retained by 3×8 mm bar magnets embedded in both the tool and the dock. The magnets naturally guide the tool into the correct orientation as you bring it close; follow the magnetic pull to seat it.

Passive tool loaded in dock

> **Note:** You will set the exact dock position coordinates (`dock_y` and `t*_x`) during the calibration steps later. For now, just seat the tools; the INDX macros handle the rest once configured.

---

### Firmware Configuration

#### Klipper

INDX's host-side support provides everything your printer needs to talk to the Smart Head: the `indx` temperature sensor, induction-heater control, extruder and accessory pin mapping, and the calibration commands. How you add it depends on your firmware:

- **Kalico (recommended):** support is **built in**. There is nothing to install on the host — the `[indx]` object and the `indx` sensor type are part of Kalico, and the MCU firmware ships with it too. Once you've flashed the Bondtech INDX PCB from the Kalico tree (see [Flash the Bondtech INDX PCB](#4-flash-the-bondtech-indx-pcb)), go straight to configuring your printer.
- **Klipper (mainline):** install the [`indx_klipper`](https://github.com/BondtechAB/indx_klipper) module, which adds the same host-side support to a stock Klipper install. Clone it and run its `install.sh` (see [Flash the Bondtech INDX PCB](#4-flash-the-bondtech-indx-pcb) for the commands).

The tool-change and calibration **macros** (`T0`/`T1`…, `PARK_TOOL`, the `CAL_*` helpers) are provided by the INDX macro package — see [INDX macro files](#indx-macro-files).

**Configure your printer**

After installing the plugin, add your INDX configuration to `printer.cfg`:

Add the following to your `printer.cfg`. The `serial` path under `[mcu indxmcu]` will be unique to your board; see the note below on how to find it.

```ini
[mcu indxmcu]
# Replace the serial path below with the one from your board — see "Finding your serial path" below
serial: /dev/serial/by-id/usb-Bondtech_INDX_<your-serial-here>

[indx]
mcu: indxmcu

# These are control parameters for the induction heater — leave them at these values
pid_kp: 1.0
pid_ti: 0.0
pid_td: 0.0
pid_b: 1.0

[extruder]
sensor_type: indx  # Custom sensor type provided by the INDX plugin — reads temperature via the IR sensor on the induction board
min_temp: 0
max_temp: 350
smooth_time: 0.3  # Reduce display and wait-condition lag during rapid induction heat-up

heater_pin: indx:heater
# Induction heating uses watermark (on/off bang-bang) control, not PID.
# This works well for induction because of its very fast response time. Do not change to pid.
control: watermark
nozzle_diameter: 0.4     # Change to match your passive tool nozzle size (0.4 / 0.6 / 0.8 / 1.0)
filament_diameter: 1.75

step_pin: indxmcu:motor_step
dir_pin: indxmcu:motor_dir  # If filament feeds backwards, change to: !indxmcu:motor_dir
enable_pin: !indxmcu:motor_enable
microsteps: 32
rotation_distance: 5.7  # Pre-calibrated for the DX extruder — do not change

[tmc2240 extruder]
cs_pin: indxmcu:motor_cs
spi_software_sclk_pin: indxmcu:motor_sclk
spi_software_mosi_pin: indxmcu:motor_mosi
spi_software_miso_pin: indxmcu:motor_miso
rref: 24000  # Reference resistor value for the TMC2240 on the INDX PCB — do not change
run_current: 0.6

[fan]
pin: indxmcu:part_cooling
tachometer_pin: indxmcu:part_cooling_tacho

[neopixel indx]
pin: indxmcu:led
chain_count: 16  # Fixed for the Smart Head LED array — do not change

[gcode_button endstop]
pin: ^indxmcu:endstop
press_gcode: {action_respond_info("press")}
release_gcode: {action_respond_info("release")}

[lis2dw]
# Built-in accelerometer on the INDX PCB — used for input shaper calibration
i2c_mcu: indxmcu
i2c_bus: sercom3

[angle indx]
# Magnetic encoder that reads extruder rotation — used for precise extrusion monitoring
sensor_type: as5047d
stepper: extruder
cs_pin: indxmcu:encoder_cs
spi_bus: sercom1
```

The INDX MCU reports nozzle temperature every 0.1 seconds. Klipper's default
one-second heater smoothing can nevertheless lag substantially behind the
measured temperature during the very fast induction heat-up, delaying the
displayed temperature and temperature-wait completion. Keep `smooth_time: 0.3`
in the extruder configuration to reduce that lag while retaining smoothing
across multiple reports.

> ⚠️ **Do not change `rotation_distance`**
>
> The `rotation_distance: 5.7` value is pre-calibrated for the DX extruder and is used by the INDX tool-change macros to calculate precise filament moves during tool changes. Changing it, even slightly, will cause incorrect filament positioning and failed tool changes. Do not treat it as a value to tune. If your extrusion multiplier needs adjusting, do it in the slicer, not here.

**Finding your serial path**

The `serial` value under `[mcu indxmcu]` is unique to your board. To find it, SSH into your printer (see [Connect to your printer via SSH](#connect-to-your-printer-via-ssh)) and run:

```bash
ls /dev/serial/by-id/
```

Copy the path that starts with `usb-Bondtech_INDX` and paste it into your config.

**Configuring multiple tools**

The `[extruder]` block above is always required and represents the Smart Head's single DX extruder. INDX passive tools are **not** separate Klipper extruders — there is only ever one `[extruder]`. Additional tools (T1, T2, …) are defined in `indx.cfg`: set `variable_tool_count` and add a `variable_t{n}_x` / `variable_t{n}_dock_y` pair per tool in the `[gcode_macro TOOL_POSITIONS]` section (see [INDX macro files](#indx-macro-files)). Per-tool XY/Z offsets come from [Tool Offsets](#tool-offsets) calibration, and per-tool nozzle sizes and temperatures are set in your slicer.

**Tools that do not print.** A dock position does not have to hold a hotend. If you are carrying a pen, a cutter, a camera or anything else with nothing to heat, list its tool number in `variable_no_heat_tools` in `indx.cfg`, for example `variable_no_heat_tools: [3]`. The pickup, latch and park moves already run cold, so the only thing that changes is that the induction coil is never switched on for that tool. Setting it here rather than in the slicer matters: your change filament G-code is a single template shared by every tool, so it will pass a temperature for the pen along with everything else, and this makes the printer ignore it. The tool still needs a dock position and still counts toward `variable_tool_count`.

##### INDX macro files

The INDX firmware plugin provides a set of `.cfg` files you include from `printer.cfg`. Each file has a specific role:

| File | Role |
| ---- | ---- |
| `indx.cfg` | User configuration: tool positions and related settings. **The only file you need to edit.** |
| `indx-tc-macros.cfg` | Tool change logic: `CHANGE_TOOL`, `PARK_TOOL`, boot detection. Do not edit. |
| `indx-cal.cfg` | Calibration macros: dock position, XY/Z offset calibration. |
| `homing.cfg` | `[homing_override]`: Y then X, load-cell seat check, then Z. Do not edit. |

Include them from your `printer.cfg`:

```ini
[include indx/indx.cfg]
[include indx/indx-tc-macros.cfg]
[include indx/indx-cal.cfg]
[include indx/homing.cfg]
```

Klipper allows only one `[homing_override]`. If your printer already has one (sensorless current, bed raiser, etc.), merge the INDX sequence into yours instead of including `homing.cfg` as-is.

##### Required Klipper sections

The INDX macros depend on a few stock Klipper modules. If any of these are missing from your `printer.cfg`, the macros will fail at runtime rather than at startup, which makes the cause hard to spot. Add all of them:

```ini
[save_variables]
filename: ~/printer_data/config/indx_vars.cfg

[respond]
```

`save_variables` stores the state INDX has to survive a restart: the active tool, latch state, per-tool XY/Z offsets, the toolchange counter, and the current speed mode. Without it every macro that reads `printer.save_variables.variables` errors out, and the printer forgets which tool is mounted across reboots. Point `filename` at any writable path in your config directory; the file is created for you.

`respond` provides the `RESPOND` command that every INDX macro uses for console output and prompts.

##### Load cell probe

The Smart Head's load cell is the printer's Z probe, so a `[load_cell_probe]` section is required too. The ADS131M02 that reads the load cell sits on the INDX toolboard, so its pins are addressed through the `indxmcu` MCU:

```ini
[load_cell_probe]
sensor_type: ads131m02
cs_pin: indxmcu:loadcell_cs
spi_bus: sercom1
data_ready_pin: indxmcu:loadcell_drdy
channels: 0
sample_rate: 500
z_offset: -0.15
force_safety_limit: 3200
trigger_force: 150
speed: 2
retry_speed: 1.0
lift_speed: 15
pullback_distance: 0.35
pullback_speed: 0.3
samples: 3
samples_result: median
sample_retract_dist: 0.35
samples_tolerance: 0.05
samples_tolerance_retries: 3
```

The pins are named aliases rather than raw MCU pins, so this config stays valid across INDX PCB revisions.

`trigger_force` is the contact force in grams that counts as a touch.

> ⚠️ **`z_offset` is a per-machine value, not a constant.** The nozzle is the probe, so there is no probe-to-nozzle distance to correct for, but the tool and Smart Head still deflect slightly under the trigger force before contact is registered. `z_offset` takes that out. The value above came from a working machine and is a reasonable starting point; treat it as something to tune for yours rather than a number to copy. Too little and your first layer sits high, too much and the nozzle digs in.

`pullback_distance` and `pullback_speed` control what happens immediately after contact: the toolhead retracts a short distance at a slow speed while the load cell keeps sampling, and the tap analysis uses that force curve to work out the exact moment the nozzle touched. Slower and shorter gives a cleaner curve; too slow and every probe costs noticeable time.

`samples: 3` with `samples_result: median` takes three probes and keeps the middle one, which throws out a single bad reading rather than averaging it in. That matters most for `G28 Z`, where one probe decides your Z origin. `CAL_Z` runs its own convergence and median sampling across many probes on top of this (see [Z Offset Calibration](#z-offset-calibration)), so the two are not redundant; the probe-level median cleans up each individual reading that the higher-level sampling then works from.

`speed: 2` and `retry_speed: 1.0` are slow on purpose. A faster approach overshoots the trigger point before the load cell reacts, which both marks the bed and reads high.

Two values are missing from the block above on purpose: `counts_per_gram` and `reference_tare_counts`. Those come out of [load cell calibration](#load-cell-calibration) and are written to the `SAVE_CONFIG` block at the bottom of your `printer.cfg` automatically. Don't set them by hand — run the calibration and let it fill them in.

> ⚠️ **This section is Kalico-specific.** Mainline Klipper also has a `[load_cell_probe]`, but it is a different implementation and does **not** accept `pullback_distance`, `pullback_speed`, `disable_pullback_move` or `drift_safety_limit`. On mainline Klipper, drop the two pullback lines; everything else above is common to both. Note also that mainline clamps `force_safety_limit` to a minimum of 100 where Kalico allows lower values, so a config written for one is not guaranteed to load on the other.

**Running a Beacon or Cartographer as well?**

The load cell registers itself as the printer's probe, so a scanning probe on the same machine has to be told not to. For Beacon, add both of these to your `[beacon]` section:

```ini
register_as_probe: false
prefixed_probe_commands: true
```

For Cartographer, add only the first line to `[cartographer]` — it will reject `prefixed_probe_commands`.

##### Eddy current scanner (optional)

The INDX toolboard has the LDC1612 sensor chip on board. With the INDX Eddy Current Scanner coil connected (a separate product), it scans bed meshes; Z homing stays on the load cell, and the scanner only supplies the shape of the bed, never its height.

It needs Kalico from 2026-10-08 or later: if you have not updated Kalico since then, update it first (Mainsail or Fluidd, Update Manager). Mainline Klipper does not support it yet.

```ini
[probe_eddy_current scanner]
sensor_type: ldc1612
i2c_mcu: indxmcu
i2c_bus: sercom3
intb_pin: indxmcu:ldc_int
# The toolboard clocks the LDC1612 from its 25 MHz crystal
frequency: 25000000
# Scanner position relative to the nozzle (Smart Head CAD)
x_offset: 0
y_offset: 34.472
z_offset: 1.0
# The load cell stays the default probe; the scanner is selected with PROBE=scanner
register_as_probe: False
# The INDX coil trips the LDC1612 amplitude-low error in normal use
amplitude_errors: high

# Scanner coil temperature, for monitoring
[temperature_sensor scanner_coil]
sensor_type: indx
indx_sensor: ldc_coil
```

Calibrate it once, with T0 on the head, the nozzles cold and the printer homed (`G28`):

1. `LDC_CALIBRATE_DRIVE_CURRENT CHIP=scanner`, then `SAVE_CONFIG`.
2. `G28` again, then `PROBE_EDDY_CURRENT_CALIBRATE CHIP=scanner`. Bring the nozzle down until it just touches the bed (the manual probe prompt), accept, and `SAVE_CONFIG`.

Redo both after moving or replacing the scanner or the Smart Head mount.

Scan a mesh with:

```
BED_MESH_CALIBRATE PROBE=scanner METHOD=rapid_scan
```

Without `PROBE=` the mesh is probed with the load cell, one touch per point. Without `METHOD=rapid_scan` the scanner stops at every point, which takes much longer. `ADAPTIVE=1` scans only the area of the print, and `SCAN_SPEED=` sets the scan speed (default the `[bed_mesh]` `speed`).

In `[bed_mesh]`:

- `horizontal_move_z` must be above the scanner `z_offset` (for example 2), or every scanner probe starts already triggered.
- Mesh coordinates are scanner positions, and the nozzle is 34.5 mm further toward the front. Pick `mesh_min` Y so the nozzle stays at or behind `clearance_y` (with `clearance_y: 0`, `mesh_min` Y 35 or more). The strip in front of that is extrapolated from the front row.
- Set `zero_reference_position` to the G28 Z probe point (`probe_x`, `probe_y` in `indx.cfg`, or the bed centre). The mesh is then zeroed where the load cell set Z0, so the scanner only supplies the bed shape and its overall height drift cancels out.
- The coil is about 17.6 mm across. A mesh spacing near that size already resolves what the scanner can see.

Good practice:

- **Mesh with the nozzles cold.** The induction heater disturbs the scanner, and a nozzle that has just primed warms the coil and shifts its reading. In your print start, mesh before heating the nozzles.
- **Level with the load cell, not the scanner.** Use the default probe for `QUAD_GANTRY_LEVEL` and `Z_TILT_ADJUST`; the scanner sits 34.5 mm behind the nozzle and reads gantry tilt slightly differently.
- If a wrapper macro (KAMP or your own `PRINT_START`) calls `BED_MESH_CALIBRATE`, make it pass `PROBE=scanner METHOD=rapid_scan`. A wrapper that drops them can be bypassed by calling `_BED_MESH_CALIBRATE`, the built-in command it renamed.
- To check the result, tap a few spots with the load cell (`PROBE`) and compare with the mesh.

Clearance: the scanner PCB sits 2.56 mm above the nozzle tip, but its mounting screw heads are only about 0.89 mm above it, about 51 mm behind the nozzle. They catch anything more than about 0.9 mm above the current layer: curled overhangs, warped corners, blobs.

| What you see | What to do |
|---|---|
| Klipper will not start: more than one probe registers itself | `register_as_probe: False` in `[probe_eddy_current scanner]` |
| "Sensor readout error" during a scan | `amplitude_errors: high` |
| "horizontal_move_z can't be less than probe's z_offset" | raise `horizontal_move_z` in `[bed_mesh]` |
| "Sample rate is not high enough for the requested speed" | lower `SCAN_SPEED=` to the speed the message names, or below |
| "METHOD=rapid_scan not supported ... using automatic" | update Kalico, or check that `PROBE=` names the scanner |
| The mesh is probed by touching the bed | `PROBE=scanner` did not reach `BED_MESH_CALIBRATE`: check your print start or wrapper |

##### Automated dock X measurement (built in)

Automated dock X measurement is **built into the INDX plugin** — there is no separate Python extra to install. The plugin registers `INDX_DOCK_MEASURE`, which energises the XY motors, homes Y then X from the dock, and derives the absolute dock position from the raw stepper counts (so it works for each tool in turn without a prior `G28`).

The `indx-cal.cfg` macros wrap this into the calibration commands you actually run:

| Command | Description |
| --- | --- |
| `CALIBRATE_DOCK_X TOOL=N` | Measures dock X for tool N via `INDX_DOCK_MEASURE` and reports the value to paste into `indx.cfg`; see [Dock Position Calibration](#dock-position-calibration) |
| `READ_DOCK_POSITION TOOL=N` | Reports the current (already-homed) X as dock X for tool N |

---

##### Homing order (important)

With a dock mounted on your printer, the default homing sequence can cause crashes. The Smart Head must move away from the dock before X is homed, and Z homing needs a seated tool (the load cell is the nozzle probe).

The INDX macro package includes a ready-to-use `[homing_override]` in `homing.cfg` that handles all of this. Its sequence, in full:

1. Raise to `probe_z_clearance` (set in `indx.cfg`). If Z is unknown, hop that height then un-home Z so the later probe is a real home.
2. Home Y. `G28 X` with Y unknown homes Y first.
3. Home X at a Y that clears the docks. Homing X crosses every dock position. If the head's Y (the Y endstop after a fresh Y home, or the current Y if Y was already homed) is on the dock side of `clearance_y`, it moves to `clearance_y` first; if it is already on the far side, for example a Y endstop opposite the docks, X homes where it stands. An unknown Y always moves. `dock_dir` in `indx.cfg` decides which side the docks are on.
4. Make T0 the tool on the head. `G28 Z` always homes on T0, because the per-tool Z offsets are stored as differences from T0. With T0 locked there is no dock trip; another tool is parked and T0 fetched; an empty head fetches T0, also when Z has never been homed (step 1 already lifted the gantry clear of the bed). Until the docks are measured (`docks_calibrated: False`), G28 refuses that trip: seat T0 by hand with `MANUAL_TOOL_SEAT TOOL=0` first. `home_check_seat` in `indx.cfg` decides how INDX knows what is on the head: `False` (default) trusts `active_tool`, `True` also requires the load cell to agree. See [Seat check](#seat-check) for what turning it on buys and costs.
5. Move to the probe XY (`probe_x` / `probe_y`, or bed centre), home Z, then lift back to `probe_z_clearance`. `G28 Z` ends at the trigger point a fraction of a millimetre off the bed, so the lift leaves the head at a height any following move can start from.

`CAL_Z` stores per-tool Z offsets relative to T0, which is why Z always homes on T0.

#### Seat check

Z homing probes with the nozzle, so it needs a tool on the head. The load cell can be asked to confirm one is there before every `G28 Z`, by setting `home_check_seat: True` in `indx.cfg`. It is off by default, and that default is deliberate.

The load cell is a dependable contact detector and an undependable scale. Probing only asks it *when* force changed, which it answers well. The seat check asks it *how many grams are on the head right now*, and that number moves with the tare. A head tared with a tool already in it reads near zero with that tool still seated, and the check then refuses a homing that would have been perfectly safe.

With the check off, `active_tool` answers instead. That is the same value every tool change already trusts, so the seat check is not the weak link if it is wrong. What you give up is the one place that could have caught it being wrong.

With the check on, the cell and `active_tool` must agree. Either can be wrong on its own, so a disagreement in either direction stops the machine and asks rather than picking a winner: a cell that reads empty while `active_tool` names a tool would otherwise send a loaded head into another dock. T0 is fetched only when both say the head is empty. Tune the threshold with `home_min_force_g` (default 800 g), and note that a missing or uncalibrated `[load_cell_probe]` becomes a homing error rather than just a probing one.

`INDX STATUS` prints the live reading on its `SEAT FORCE` line whichever way this is set, so you can see what the cell thinks without having it gate anything. If it reads near zero with a tool seated, the tare has drifted: run `CALIBRATE_LOAD_CELL` with an empty head.

If you use sensorless XY homing, wrap the `G28 Y` / `G28 X` steps in your usual TMC current reduce/restore (merge into the override if you already have one).

**Review your `PRINT_START` macro**

If you are migrating from a single-toolhead printer, your existing `PRINT_START` macro almost certainly heats the hotend before printing starts, something like `M104 S{first_layer_temperature}` or `M109 S{first_layer_temperature}`. With INDX, this will cause problems: there is no hotend to heat until a tool has been picked up by the Smart Head.

> ⚠️ Any hotend heating commands in your `PRINT_START` macro must come **after** the first tool pick-up. Sending a heat command before a tool is picked up will result in an error, and depending on your macro structure, may cause a crash or leave the printer in a bad state.

Review your `PRINT_START` macro and move all `M104`/`M109` (and any temperature wait commands) to after the first tool pick (`Tn` / `CHANGE_TOOL`). If you are writing a fresh macro, pick up a tool first, then heat.

INDX's own `M104` and `M109` (in `indx-tc-macros.cfg`) enforce this: with no tool on the head they don't heat and say so in the console, a tool listed in `no_heat_tools` is never heated, and `M104 T<n>` / `M109 T<n>` for a tool that is not on the head is ignored instead of stopping the print (slicers send these for parked tools). If your config defines its own `M104` or `M109`, only the last one loaded is used, so merge these rules into yours.

**Display alerts**

Warnings that are dangerous to ignore (`! ...`, for example a failed homing or `clearance_y` too close to a dock) and moments when you need to act (`> ...`, for example docks not calibrated yet) are also shown with `M117` on the printer display. The console keeps the full message. An INDX alert clears itself after the next successful `G28`, and never clears your own `M117` text.

#### Pickup and park checks

INDX checks every pickup and every park with the load cell. This is on by default (`seat_check_enabled: True` in `indx.cfg`) and is separate from the homing [seat check](#seat-check) above. Each check compares two readings taken standing still a few seconds apart, so the tare and the load cell's drift with temperature do not affect it.

- **Pickup.** The head reads the load cell at the trigger line with the head empty, picks up the tool, and reads it again. A seated tool adds its latch spring preload, so the two readings must differ by at least `seat_min_force_g` (default 680 g). If they don't and the difference is below `seat_empty_max_g` (default 230 g), the head is empty: the console says so, X and Y are homed again, and the tool is parked and picked up once more. In sport mode INDX first switches to normal tool change speed, says so on the console and the display, and stays in normal (also after a restart) until you run `MODE_SPORT` again. If the second try fails too, the heater is turned off and no tool is recorded. A difference between `seat_empty_max_g` and `seat_min_force_g` means the tool may be half seated on the head. INDX never assumes the head is empty, so there is no retry: the heater is turned off, the tool stays recorded as on the head, the latch is left as it is, and the display shows `T<n> may be on the head`. Until the head has been checked, `G28` (when it homes Z), `CHANGE_TOOL` and `PARK_TOOL` refuse to run, also after a restart. Check the head by hand, then run `MANUAL_TOOL_REMOVE` (take the tool off and put it in its dock) or `MANUAL_TOOL_SEAT TOOL=<n>` (it is fully on). Either one, or `MANUAL_TOOLHEAD_RESET`, clears the refusal. Either way, during a print the print pauses, with nothing moved or retracted: get the tool back in its dock with the head empty, run the `CHANGE_TOOL` command the console gives you, then `RESUME`. Outside a print, and during the T0 fetch of a `G28`, INDX stops with an error.
- **Park.** The head reads the load cell with the tool still seated, parks it, and reads it again after leaving the dock. The readings must differ by at least `park_min_change_g` (default 425 g). If they don't, the tool is probably still on the head: INDX stops with an error before driving anywhere else, turns the heater off, and keeps the tool recorded as on the head. Check the head. If the heater also reported a model divergence, a blob from a detached print may be stuck on the nozzle.

Successful pickups print the reading in the console, for example `T1 seated: load cell -1650 g against the empty head`, which is useful when tuning `seat_min_force_g`. A failed check also shows a short alert on the printer display.

Without a calibrated load cell the checks are skipped, with one line in the console after each restart. To turn them off, set `variable_seat_check_enabled: False` in `indx.cfg`. Tool changes then work as they did before the checks existed. If you keep your own `indx.cfg`, the checks are on with the defaults above until you add these settings.

#### RRF (RepRapFirmware)

Configure the Bondtech INDX PCB in RRF following the [Duet INDX Toolboard documentation](https://docs.duet3d.com/en/Duet3D_hardware/Duet_3_family/INDX_Toolboard).

The RRF tool-change and calibration macros are in [`macros/RRF/`](macros/RRF/) in this repository. They are the RRF counterpart to the Klipper `.cfg` files described above, covering tool changes (`tpreN.g`, `tpostN.g`, `tfreeN.g` for each tool, calling `INDX_TC_PRE.g`, `INDX_TC_POST.g`, `INDX_TC_FREE.g`, with `INDX_UNLOCK_DANCE.g` releasing a docked tool and `INDX_TC_REPORT.g` logging each check), the latch (`INDX_OPEN.g`, `INDX_CLOSE.g`, `INDX_CLOSE_CAL.g`, `INDX_LATCH_ENGAGE.g`, `INDX_LATCH_MOVE.g`), load-cell calibration, taring and readings (`INDX_LC_CALIBRATE.g`, `INDX_LC_CAL.g`, `INDX_LC_RETARE.g`, `INDX_TARE.g`, `INDX_LC_RAW.g`, `INDX_LC_SPEED_SWEEP.g`), the check that a tool is on before the nozzle probes (`INDX_TOOL_CHECK.g`), state persistence (`INDX_WRITE_STATE.g`), Z homing, bed levelling and meshing against the load cell (`homez.g`, `bed.g`, `mesh.g`), and pause, stop and power-loss resume (`pause.g`, `stop.g`, `resurrect-prologue.g`). `INDX_TC_TEST.g` is a test macro that cycles every tool and checks each drop-off and pickup; it goes in `0:/macros`.

Settings live in [`INDX_variables.g`](macros/RRF/INDX_variables.g), which is the RRF equivalent of `indx.cfg` and the file to edit. Call it from `config.g` with `M98 P"INDX_variables.g"` **after** the hardware configuration, including after the `M558`/`G31` that create the load-cell probe.

### Initial Startup

Before calibrating the dock or running any tool changes, verify that the Smart Head is communicating correctly and all connected components are working. Work through these checks in order before moving anything near the dock.

### 1. Verify MCU connection

Power on your printer and open Klipper (Mainsail or Fluidd). Check the MCU status in the interface; `indxmcu` should appear as connected.

If Klipper reports a timeout or cannot connect to `indxmcu`, the most common causes are:

- **Firmware not flashed**: the most likely cause on a first startup. If you haven't flashed the Bondtech INDX PCB yet, or the flash didn't complete successfully, go back to [Flash the Bondtech INDX PCB](#4-flash-the-bondtech-indx-pcb) before continuing
- **Incorrect `serial` path**: re-run `ls /dev/serial/by-id/` via SSH and confirm the path matches what's in `[mcu indxmcu]` in your config
- **Communication mode switch** not set correctly: confirm the switch on the INDX MCU PCB is set to CAN or USB to match your wiring. See [Switch configuration](#3-wiring) for reference images
- **INDX Link Cable** not fully seated at either end

Once `indxmcu` shows as connected, proceed.

### 2. Check extruder motor direction

With no filament loaded, issue a small extrude command from the Klipper console:

```gcode
G91           ; relative mode
G1 E10 F300   ; extrude 10mm
G90           ; back to absolute
```

> **Note:** If Klipper throws a "Cannot extrude — minimum extrude temperature" error, either heat the nozzle first (`M104 S200` and wait for it to reach temperature), or — on Kalico — allow cold extrusion at runtime with `M302 P1`. Run `M302 P0` to re-enable the protection once you've confirmed motor direction. No config change or restart is needed.

The extruder gear should turn in the direction that feeds filament through the tool. If it moves the wrong way, add `!` to the `dir_pin` in your `[extruder]` config and restart Klipper.

### 3. Check part cooling fan

If you have a part cooling fan connected to the Bondtech INDX PCB, trigger it from the console and confirm it spins:

```gcode
M106 S255   ; fan full speed
M107        ; fan off
```

Skip this step if you haven't connected a fan yet.

### 4. Verify accelerometer

The Bondtech INDX PCB has a built-in accelerometer; no external ADXL345 or similar sensor needed. Confirm it is responding:

```gcode
ACCELEROMETER_QUERY
```

You should see a stream of X/Y/Z acceleration values returned in the console. If you get an error, check the `[lis2dw]` section in your config for correct `i2c_mcu` and `i2c_bus` values.

### 4a. Run input shaper calibration (optional but recommended)

With the built-in accelerometer confirmed working, you can run Klipper's resonance testing to calibrate input shaper, with no external ADXL345 needed.

**Install the required Python dependencies**

These are not installed by default on most Klipper hosts. Run this once on your Pi:

```bash
sudo apt install python3-numpy python3-matplotlib libatlas-base-dev libopenblas-dev -y
~/klippy-env/bin/pip install numpy matplotlib --upgrade
```

Then restart Klipper:

```bash
sudo systemctl restart klipper
```

**Add the resonance tester config**

Make sure your config includes a `[resonance_tester]` section referencing the built-in accelerometer and a probe point near the centre of your bed:

```ini
[resonance_tester]
accel_chip: lis2dw
probe_points:
    <X_CENTER>, <Y_CENTER>, 20    # replace with your bed centre coordinates
```

> ⚠️ The built-in accelerometer on the INDX PCB is a **LIS2DW**, not an ADXL345. Use `accel_chip: lis2dw`, not `adxl345`.

**Run the tests**

Home the printer, then run one axis at a time from the Klipper console:

```gcode
TEST_RESONANCES AXIS=X
TEST_RESONANCES AXIS=Y
```

Klipper will move the toolhead through a frequency sweep and generate resonance data. Once both axes are done, run:

```gcode
SHAPER_CALIBRATE
```

This analyses the data and recommends input shaper settings. Apply the suggested values to your `[input_shaper]` section in your config, then save and restart Klipper.

> 💡 If `TEST_RESONANCES` returns an error about missing modules, the Python dependencies above were not installed correctly. Re-run the `apt install` and `pip install` commands and restart Klipper again.

### 5. First heat-up & heater calibration

The induction heater itself is controlled by a simple **on/off (watermark) loop**, which suits induction's very fast thermal response. Separately, the INDX board builds a **thermal model** of the nozzle and tool that it uses purely for **safety monitoring** — detecting a nozzle that isn't heating as expected, a tool pulled mid-heat, or a thermal runaway (these surface as the `ErrorTempDiff` / `ErrorHeatMax` conditions). The thermal model does not drive heating; it only supervises it. Before first use this model has to be calibrated. It is a one-time procedure per tool/cooling setup; the results are written to your config with `SAVE_CONFIG`.

> ⚠️ The nozzle gets hot during calibration. Pick up a tool first (`T0`) so a nozzle is present in the coil, and keep flammable material away from the Smart Head.

Run the commands in order from the Kalico/Klipper console:

| Command | What it does |
| --- | --- |
| `INDX_CALIBRATE` | Heats the nozzle through a controlled ramp and fits the thermal-model parameters (`max_power`, `thermal_capacity`, `to_ambient_r`) |
| `INDX_FAN_CALIBRATE` | Steps the part cooling fan through several speeds and models its cooling effect on the nozzle |
| `INDX_LOAD_FILAMENT` | Loads filament and measures its heat capacity so the model accounts for the energy the filament carries away (see below) |
| `SAVE_CONFIG` | Writes the calibrated values into your `[indx]` config section and restarts |

`INDX_CALIBRATE` and `INDX_FAN_CALIBRATE` characterise the nozzle/tool and the part cooling fan — run them once per tool type and cooling setup. Because these values feed the safety model rather than the control loop, don't hand-edit them afterwards; re-run the routine if the tool type or part cooling setup changes.

##### Calibrating a CPAP or other high-flow part cooling

CPAP blowers need more care than the dual 40×10 fans, and getting this wrong is the most common cause of a printer that runs fine until part cooling kicks in and then shuts down a minute later. That shutdown is the safety model working correctly: the fan is removing more heat than the model predicts, the divergence exceeds `max_model_error`, and the printer stops.

**Your fan must respond across the whole commanded range.** `INDX_FAN_CALIBRATE` fits a power law with a negative exponent:

```
part_cooling_fan_a × fan_speed ^ (−part_cooling_fan_k)
```

which means the fit is most sensitive at *low* fan speeds. If your fan config uses `off_below`, every commanded speed under that threshold sets the fan to zero, so the calibration records "5% commanded, no cooling measured" exactly where it matters most and the fitted curve is wrong across the entire range.

Use `min_power` rather than `off_below` for a blower. `min_power` rescales the commanded range onto the range the blower can actually turn in, so commanded speed keeps tracking real airflow all the way down:

```ini
[fan]
pin: ...
min_power: 0.14       # not off_below — set to your blower's real minimum
kick_start_time: 0.1
cycle_time: 0.0003
```

**Then calibrate in this order**, with the hose attached and the duct in its final configuration:

1. `INDX_CALIBRATE` with the part cooling fan **off**, to fit the base thermal model
2. `INDX_FAN_CALIBRATE BREAKS=50 MIN_SPEED=0.01 HOLD_TIME=20`, with the nozzle at print height (around 0.2 mm) over a clean build plate
3. `SAVE_CONFIG`

Both details in step 2 matter. Calibrating without the hose, or with the nozzle up in free air, measures airflow that doesn't match what the nozzle sees while printing — and the model is only as good as the conditions it was fitted in.

**Watch the fan through the sweep.** It should visibly change speed at every step. If it doesn't, the fan config is still truncating the low end and the fit will be wrong again no matter how many times you re-run it.

> ⚠️ **Don't raise `max_model_error` to stop the shutdowns.** A passive tool has no thermistor, so model divergence is the main thing standing between a misbehaving coil and a fire. Raising the limit hides the symptom and removes the protection. If the model keeps diverging, the fan calibration is wrong — fix that instead.

**Filament heat capacity.** Different filaments carry heat away from the nozzle at different rates, so the safety model also needs to know which filament is loaded. You set this when you load filament into a tool, not during the one-time calibration above:

- **Measure it** — `INDX_LOAD_FILAMENT` feeds and primes filament while measuring the actual heat capacity, then (with `APPLY=1`) writes it to your config. Most accurate; run `SAVE_CONFIG` to keep it.
- **Set it by type** — `INDX_SET_MODEL_PARAMS FILAMENT_DENSITY=… FILAMENT_HEAT_CAPACITY=…` applies known values for a material without measuring.

The `LOAD_FILAMENT` macro wraps both of these together with tool selection — see [Loading Filament into Tools](#loading-filament-into-tools).

**The model only uses the product.** Density and heat capacity are always multiplied together, never used separately, so how the value is split between the two doesn't matter — only that `density × heat_capacity` is right for the material. This is why a measured run reports `model_filament_density = 1.0000`: the measurement can only recover the product, so it pins density to 1 and folds everything into heat capacity. That isn't a failed measurement.

**Values are remembered per tool.** `LOAD_FILAMENT TOOL=n TYPE=…` records the filament against that tool, and every subsequent pickup of it restores those values before the tool heats. Without that, the model would keep whichever material was loaded last on any tool, which on a multi-material print is the wrong filament for most of the job. You can set it directly for a tool at any time:

```gcode
SET_TOOL_FILAMENT TOOL=1 DENSITY=1.21 HEAT_CAPACITY=1.80
```

Tools that have never been loaded through `LOAD_FILAMENT` or `SET_TOOL_FILAMENT` simply leave the model untouched on pickup.

> ⚠️ A measured run (`MEASURE=1`) applies its result globally rather than to the tool it measured, because the measurement is written by the firmware rather than the macro. After `SAVE_CONFIG` and a restart, record it against the tool with `SET_TOOL_FILAMENT TOOL=n DENSITY=1.0 HEAT_CAPACITY=<the measured value>` so it survives toolchanges.

---

**Part 3: Configuration**

---

## Configuration

### Load cell calibration

The Smart Head's load cell senses tool/nozzle touch and is the printer's **Z probe**, so it must be calibrated before the printer can home Z.

> ⚠️ **Do this before your first Z homing.** Z homing probes the bed with the load cell, so the load cell must be calibrated before a full `G28` — and therefore before dock and [Z-offset](#z-offset-calibration) calibration. It's a first-boot, by-hand step: **X and Y are homed first** (they don't use the load cell), but the tool is seated by hand because the dock can't be reached until Z is homed.

Start with **no tool on the Smart Head** and run:

```gcode
CALIBRATE_LOAD_CELL
```

This homes X and Y, opens the latch (and records soft-state Open), and tares the empty head. X and Y are not homed again if they already are, and an open latch is not opened again.

`CALIBRATE_LOAD_CELL` refuses to run when `active_tool` says a tool is on the head, or when an earlier calibration exists and the load cell reads a seated tool. Run `MANUAL_TOOL_REMOVE` and lift the tool off, or put it in its dock, then run it again. On a first calibration there is nothing to read against, so make sure the head is empty yourself.

Now **seat a passive tool on the Smart Head by hand** — the tool **must be empty** (no filament in the extruder gears) — then calibrate against the known locking force (default 1600 g). `CALIBRATE_LOAD_CELL_APPLY` locks, samples, then unlocks again so you can remove the tool by hand.

```gcode
CALIBRATE_LOAD_CELL_APPLY GRAMS=1600
SAVE_CONFIG
```

Prefer the console? Run `LOAD_CELL_CALIBRATE`, then `TARE` with no tool, seat an **empty** tool and lock the latch, then `CALIBRATE GRAMS=1600`, `ACCEPT`, unlock the latch, and `SAVE_CONFIG`.

Restart. Then put T0 on the head by hand and run `MANUAL_TOOL_SEAT TOOL=0` before you home with `G28`. Until the dock positions are calibrated (`docks_calibrated: False` in `indx.cfg`), G28 will not fetch T0 from its dock, because the dock positions in a new `indx.cfg` are placeholders. Z now probes with the load cell.

### Dock Position Calibration

Before any tool changes can happen, you need to find and save the exact dock position for each tool. Two coordinates are required per tool, both set in `indx.cfg`:

> 💡 **Dock calibration tool:** A printable jig ([`INDX_Dock_calibration_tool.stl`](CAD/STL/INDX_Dock_calibration_tool.stl)) is available to help align the dock during this process. Print it before starting.

| Variable | Meaning |
| --- | --- |
| `variable_t{n}_x` | X coordinate of the tool holder centre (mm) |
| `variable_t{n}_dock_y` | Y coordinate where the tool is fully seated (mm) |
| `variable_dock_dir` | Y sign into the dock: `-1` front (min Y), `+1` rear (max Y). Default `-1`. |

The trigger line (`dock_y - dock_dir * trigger_offset`) is derived automatically; you only set `dock_y`.

For a rear dock, set `variable_dock_dir: 1` and put `clearance_y` on the bed side of the tools.

`clearance_y` must be at least 26 mm from the most protruding dock, on the side away from the docks (a tool on the head needs 25 mm, plus 1 mm margin). With front docks that means the highest `t{n}_dock_y` + 26 or more; the default 0.0 fits the default docks at -26. G28, `CHANGE_TOOL` and `PARK_TOOL` refuse to run otherwise and name the dock. Check it again after re-measuring a dock.

> ⚠️ **Take this slow.** Moving the Smart Head into the dock area without verified coordinates is one of the most crash-prone steps in the entire INDX setup. A misaligned approach at speed can damage the Smart Head, the passive tools, or the dock itself.
>
> - **Always use the smallest jog increments available** (0.1 mm or less) when approaching a tool
> - **Never jog in Y toward the dock** until you are confident the X position is correct
> - **Keep your hand near the emergency stop** (or have it open in your browser) throughout this process
> - If anything looks wrong, stop immediately and re-evaluate before continuing

---

#### Finding dock_y (Y: fully seated position)

Put the tool on the Smart Head by hand and run `MANUAL_TOOL_SEAT TOOL=n` (tool changes are refused until `docks_calibrated` is True). With the Smart Head holding the tool, carefully jog in Y in small increments until the tool is fully seated in the dock. When it feels fully engaged, run:

```gcode
CAL_SET_DOCK_Y
```

The console will report the correct `dock_y` value for that tool, calculated from your current Y position and the configured `trigger_offset`. Paste the reported value into `indx.cfg`:

```ini
variable_t0_dock_y: -26.0   # from CAL_SET_DOCK_Y output
```

Repeat for each tool and restart Klipper to apply.

---

#### Finding dock_x (X: tool centre)

Three options; choose one:

**Option A: `CALIBRATE_DOCK_X` (automated, built in)**

Measures the absolute X position without needing a prior home, using the plugin's native `INDX_DOCK_MEASURE` (which derives the dock position from the raw stepper counts across the Y+X homing sequence).

1. `M84` (disable motors)
2. Manually slide the toolhead to the T0 dock
3. Run:
   ```gcode
   CALIBRATE_DOCK_X TOOL=0
   ```
   The macro homes Y then X and reports the measured `dock_x` for that tool. Paste it into `indx.cfg`:
   ```ini
   variable_t0_x: 0.000   # from CALIBRATE_DOCK_X output
   ```
4. For each additional tool: `M84`, slide to the dock, run `CALIBRATE_DOCK_X TOOL=N`. No `FIRMWARE_RESTART` needed between tools.
5. Once all tools are recorded, `RESTART` to apply, then `G28` to restore normal machine coordinates. If `docks_calibrated` is still False, seat T0 by hand (`MANUAL_TOOL_SEAT TOOL=0`) before this `G28`, or set `docks_calibrated: True` first if every dock is now measured.

**Option B: `READ_DOCK_POSITION` (if already homed)**

If the printer is already homed, jog the Smart Head to the tool's dock X position in Mainsail or Fluidd and run:

```gcode
READ_DOCK_POSITION TOOL=0
```

Reports the current X as `dock_x` for that tool. Paste the value into `indx.cfg` (`variable_t{n}_x`) and `RESTART` to apply.

**Option C: manual**

Home the printer, jog the Smart Head to the dock X for each tool, and note the X coordinate shown in the interface. Enter it as `variable_t{n}_x` in `indx.cfg`.

> 💡 **Home regularly.** Stepper motors can lose steps if a crash or hard stop occurs, meaning the position shown in your interface may no longer match the actual toolhead position. Re-home your printer (`G28`) before recording any coordinates, and again after any crash or unexpected movement. If you suspect steps have been lost, discard any coordinates taken since the last home and start that tool's calibration over.

#### First tool change test

Once you have calibrated the dock position for at least one tool, do a controlled first pick-up to confirm it works before setting up the full multi-tool configuration.

First set `variable_docks_calibrated: True` in `indx.cfg` and `RESTART`. Until then INDX refuses tool changes and parking, so a dock position that was never measured can't be driven into.

> ⚠️ **Take this slow.** Use the smallest jog increments and keep your hand near the emergency stop throughout. If anything looks wrong, stop immediately.

1. Home the printer (`G28`)
2. Pick up the tool:
   ```gcode
   T0
   ```
3. Confirm the Smart Head locks onto the tool and the nozzle begins heating
4. Once at temperature, confirm the DX extruder can feed filament (optional: extrude a short amount manually)
5. Park the tool back in the dock:
   ```gcode
   PARK_TOOL
   ```
6. Confirm the tool deposits cleanly and the Smart Head returns to a safe position

If the pick-up or deposit fails, do not retry at speed. Go back to the dock position calibration steps above and recheck the coordinates for that tool.

---

### Tool Offsets

Each passive tool has a slightly different position relative to the Smart Head pickup point. Tool offsets must be calibrated so prints align correctly when switching tools. There are several ways to do this, ranging from free manual methods to precise hardware-assisted ones.

To start over, `RESET_TOOL_OFFSETS` zeroes the X/Y/Z offset of every tool. It prints the old values first, so you can copy them back from the console if needed. The global Z offset is left alone (`RESET_GLOBAL_Z` handles that).

---

### Method 1: Print and adjust (free, no extra hardware)

The simplest approach: print a multi-tool test pattern, measure any misalignment visually or with calipers, and adjust offsets in your config manually. Repeat until aligned.

This is the lowest-cost method but also the least precise and most time-consuming. It's a good starting point if you have no other hardware available. A well-regarded starting point is the [Offset XY Dual Extruder / IDEX Calibration print](https://www.printables.com/model/129617-offset-xy-dual-extruder-idex-calibration); print it with two tools, measure any X/Y misalignment with calipers, update the offsets in your config, and reprint until they align.

Because the test print uses two tools at a time, always use T0 as your reference tool and calibrate each additional tool against it separately: first print T0 + T1, then T0 + T2, then T0 + T3, and so on. Do not try to calibrate T1 against T2 directly; everything should be referenced back to T0.

**Precision:** Low–medium | **Cost:** Free

---

### Method 2: Nudge (automatic, requires small hardware)

[Nudge](https://github.com/zruncho3d/nudge) is a low-cost contact probe that automates X/Y/Z nozzle alignment. The nozzle physically touches the probe from multiple directions; software calculates exact offsets for each tool automatically.

Nudge is highly repeatable, typically below 0.003mm standard deviation over 10 samples, and can be permanently mounted inside a heated chamber. It's a popular choice in the tool changer community.

**Precision:** High | **Cost:** Low (probe hardware + printed parts)

---

### Method 3: Nozzle camera (most precise XY, higher cost)

A nozzle-mounted or fixed camera system (e.g. [Axiscope](https://github.com/nic335/Axiscope)) lets you visually align tools with sub-micron precision. Offsets are derived from image analysis rather than physical contact.

The INDX macro package includes a built-in camera calibration workflow (`CAL_ONE` → `CAL_TWO` → `CAL_THREE`) that automates the offset calculation once a camera is set up.

**Workflow:**

1. Pick up T0 and jog the nozzle tip to the centre of your camera crosshair. Run:
   ```gcode
   CAL_ONE_SET_CAMERA_REF
   ```
   This saves the current position as the reference point.

2. For each additional tool, run:
   ```gcode
   CAL_TWO_PREP_TOOL_CAL TOOL=1
   ```
   The macro picks up the tool and moves it to the camera position. Re-centre the nozzle in the crosshair using the jog controls, then run:
   ```gcode
   CAL_THREE_SAVE_XY_OFFSET
   ```
   The offset is calculated and saved automatically. Repeat for every additional tool.

Offsets are saved as `t{n}_offset_x` / `t{n}_offset_y` and applied immediately on the next tool pick-up.

**Precision:** Very high | **Cost:** Medium–high (camera hardware)

---

### Z offset calibration

Regardless of which XY method you use, Z offsets are set automatically using the load cell.

#### Z auto-calibration: CAL_Z

`CAL_Z` probes every tool with the load cell and sets all Z offsets in one automated run. T0's probe result establishes the global Z offset.

```gcode
CAL_Z
```

By default, calibration is performed cold, preserving the existing behaviour. To
measure offsets with every nozzle at the same temperature, pass a nozzle target and
an optional soak time:

```gcode
CAL_Z NOZZLE_TEMP=150 SOAK=10
```

Each tool is heated only after pickup, held at the target for the requested soak,
then measured. The heater is switched off before that tool is parked. The bed heater
is not controlled by `CAL_Z`.

Prerequisites:
- Printer homed (homes automatically if not)
- **No filament available to the extruder gears in any tool** — if filament is loaded, latch engage moves during pickup can spike load-cell readings and cause calibration to fail.
- When using `NOZZLE_TEMP`, make sure the nozzle tips are clean. Any softened filament on a nozzle can affect the load-cell measurement.

Per tool, the macro:
1. Picks up the tool
2. Pre-probes 3× at a per-tool debris-clearing spot to clean the nozzle tip
3. Runs a convergence loop at a clean spot: probes repeatedly until the 4-sample rolling variance is below 0.005 mm, fuzzing to a new position if it stalls
4. Takes a median of 5 final samples as the result
5. Parks the tool

T0's median result sets the global Z reference. All other tools' offsets are saved as `t{n}_offset_z` relative to T0. Run `CAL_CHECK_OFFSETS` to inspect the results.

---

### Recommended approach

| Need | Recommended method |
| ---- | --- |
| Z offset only | `CAL_Z` |
| XY + Z, no extra hardware | Method 1 (print and adjust) or Method 2 (Nudge) for XY + `CAL_Z` for Z |
| Maximum XY precision | Method 3 (camera) for XY + `CAL_Z` for Z |

### Temperature & Induction Settings

Temperature is set in your slicer, the same way you would set it for any standard hotend: assign a target temperature to each filament or color in your project. INDX behaves like a normal hotend from the slicer's perspective.

The main difference from a traditional hotend is heat-up speed. A conventional heater block takes 30–60 seconds to reach printing temperature. With induction heating acting directly on the nozzle with very low thermal mass, INDX does it in around 4 seconds. That's what makes ~14-second tool changes possible.

**No induction-specific settings are required.** The induction board handles heating automatically. There are no power or frequency parameters to configure.

**Preheating is not supported and not possible.** Passive tools contain no electronics; there is nothing to preheat while a tool is parked in the dock. Do not configure standby or preheat temperatures for individual tools in your slicer; doing so may produce errors since the firmware has no way to act on them for a docked tool.

### Speed & Acceleration

Tool change motion speed and acceleration are controlled by three preset modes: **Stealth**, **Normal**, and **Sport**. Each mode sets a multiplier that is applied against the `max_velocity` and `max_accel` values defined in your `printer.cfg`. The macros read those limits at runtime, so the modes automatically scale to whatever printer they're running on, with no hardcoded numbers.

| Mode | G-code | Speed multiplier | Accel multiplier | XY stepper mode |
|---|---|---|---|---|
| **Stealth** | `MODE_STEALTH` | 20% | 20% | StealthChop (quiet) |
| **Normal** | `MODE_NORMAL` | 70% | 70% | SpreadCycle |
| **Sport** | `MODE_SPORT` | 100% | 100% | SpreadCycle |

**Stealth** runs the toolchange at 20% of your printer's configured limits. The XY steppers are switched to StealthChop, making the swap nearly silent. Useful for overnight printing or noise-sensitive environments. The trade-off is a longer toolchange duration and slightly higher stepper heat.

**Normal** is the default. It uses 70% of your printer's limits with SpreadCycle, a good balance of speed, noise, and reliability for most printers and materials.

**Sport** uses the full `max_velocity` and `max_accel` from your `printer.cfg`. This gives the fastest possible toolchange times for your specific printer. Make sure your configured limits are within what your printer can actually handle; if `max_velocity` or `max_accel` are set too high, Sport mode will expose that immediately. Input shaper should be tuned before running Sport; without it, high-acceleration toolchange moves can cause the steppers to lose steps.

Mode switching also sets StealthChop or SpreadCycle on every configured XY TMC driver (`tmc2208`, `tmc2209`, `tmc2130`, `tmc2240`, or `tmc5160`). On AWD setups, that includes `stepper_x1` and `stepper_y1` when present. Each driver is read from your `printer.cfg` individually, so mixed driver setups are handled correctly. If none of your XY steppers use a supported driver, the mode still changes speed and acceleration and INDX reports that the chopper mode was left untouched.

The active mode persists across reboots. To change it, run the macro from the console or add it to your start G-code:

```gcode
MODE_STEALTH   ; quiet/slow
MODE_NORMAL    ; default
MODE_SPORT     ; full speed
```

> **Note:** The speed limits are applied only during toolchange motion. As soon as the swap completes, the macros restore whatever velocity and acceleration limits the slicer set before the toolchange, and your print resumes at its normal print speeds.

---

**Part 4: Day-to-day Use**

---

## Using INDX

### Loading Filament into Tools

Filament can be loaded into a passive tool in three ways; try each and use what works best for your setup:

- **While the tool is in the dock**: convenient if the dock is easily accessible
- **While the tool is picked up by the Smart Head**: useful if the toolhead position is easier to reach
- **Before placing the tool in the dock**: load it on the bench, then dock it

There is no single correct method. Your printer geometry, spool placement, and personal preference will determine what works best.

**Guided loading with `LOAD_FILAMENT`**

The `LOAD_FILAMENT` macro handles the whole sequence for you: it picks up the tool, tells the safety thermal model which filament is loaded, heats to temperature, then feeds and primes.

```gcode
LOAD_FILAMENT TOOL=0 TYPE=PLA
```

- **`TOOL=<n>`** — which tool to load (it is picked up automatically).
- **`TYPE=<material>`** — applies a density + heat-capacity preset and a default load temperature. Built-in types: `PLA`, `PETG`, `ABS`, `ASA`, `PA`, `PC`, `TPU`. Edit the `filament_presets` table in `indx-cal.cfg` to add materials or tune values. Presets may also set an optional `speed` (mm/s) for the feed/prime step; `TPU` uses 2 mm/s so soft filament does not buckle during guided load.
- **`TEMP=<°C>`** *(optional)* — override the preset load temperature.
- **`MEASURE=1`** *(optional)* — measure this filament's actual heat capacity while loading instead of using the preset (most accurate). Run `SAVE_CONFIG` afterwards to keep it.

`LOAD_FILAMENT` needs a calibrated thermal model — run `INDX_CALIBRATE` first (see [First heat-up & heater calibration](#5-first-heat-up--heater-calibration)). The manual methods below work too; if you load by hand, set the filament's heat capacity separately so the safety model stays accurate.

**Filament path**

How filament is routed from the spool to the tool depends entirely on your printer. Common approaches include Bowden tubes from a spool holder to the dock, or direct-feeding from a nearby spool. There are no INDX-specific constraints on tube length for standard materials; route it in whatever way suits your printer.

**PTFE tube management**

With four or more tools, PTFE tube management becomes important. Loose, unrestrained tubes will move during printing and can knock into each other or into docked tools, potentially dislodging a tool from the dock mid-print, which can cause serious damage to the Smart Head, the tool, or the dock itself.

Two approaches work well:

- **Clip the tubes together**: bundle the PTFE tubes and clip them at intervals so they move as a single unit rather than independently
- **Mount the tubes rigidly along the top interior of the printer**: routing and securing the tubes along the frame keeps them stable and out of the motion path entirely. When doing this, make sure the tubes are long enough to reach all corners of the build area without pulling on the toolhead; a tube that is too short will create tension on the Smart Head as it moves, which can affect print quality or cause tool change failures

Either approach significantly reduces the risk of tubes interfering with docked tools. If you are running four or more tools, do not leave PTFE tubes unmanaged.

**Flexible filaments (TPU and similar)**

Keep the filament path as short as possible. Long Bowden paths cause flex filament to buckle rather than feed. Where possible, feed directly into the tool without a Bowden tube, or use a very short, straight tube. Avoid sharp bends in the path. `LOAD_FILAMENT TYPE=TPU` also feeds slower than other presets (2 mm/s); tune `speed` in `filament_presets` if needed.

### Performing Tool Changes

Tool changes happen automatically when triggered by your slicer's multi-material G-code. The Klipper plugin provides standard `T0`, `T1`, `T2` (etc.) macros for selecting any tool, the same commands your slicer will output.

You can also trigger a manual tool change directly from the Klipper console or a macro:

```gcode
T0  ; pick up tool 0
T1  ; pick up tool 1
T2  ; pick up tool 2
```

Mainsail and Fluidd show these macros as tool buttons and mark the tool INDX has on the head. If you have more tools than `T0` to `T3`, add `variable_active: False` to each extra `T<n>` macro in `indx.cfg`, like the four that ship with it. A `T<n>` macro without that line still changes tools but does not show as active.

> ⚠️ **Never remove a tool while the nozzle is heating.** If a tool is physically removed from the Smart Head while the induction coil is active, the firmware on the Bondtech INDX PCB will crash. You will need to run `FIRMWARE_RESTART` in the Klipper console before the printer can be used again.

**Priming before a print**

It is recommended to prime each nozzle before starting a print. Priming builds pressure in the nozzle and purges any filament that has been sitting idle and may have degraded or partially retracted. How you do this is up to you; common approaches include:

- A purge line in your slicer's print start G-code
- A prime routine in your `PRINT_START` macro
- A dedicated prime tower at the start of the print

The specifics depend on your slicer and macro setup. Check what other tool changer users in the community are doing for inspiration.

### Slicer Setup

Any slicer that supports **multiple filaments or colors** works with INDX; slicer compatibility is not INDX-specific. If your slicer can output multi-tool G-code (`T0`, `T1`, `T2`…), INDX can execute it.

Common slicers used with INDX include PrusaSlicer, OrcaSlicer, SuperSlicer, and Cura. Refer to your slicer's documentation for how to configure multiple extruders/tools.

**INDX-specific slicer settings to be aware of:**

- **Wipe tower:** A wipe tower is recommended for best results but not strictly required. Because INDX produces near-zero ooze by design, the wipe tower can be kept small compared to filament-switcher systems. You can experiment with disabling it for single-material-per-layer prints, but use it when printing materials prone to stringing.
- **Tool change G-code:** A small custom G-code snippet is required in your slicer's tool change script. The snippet and where to add it differs per slicer:

  **OrcaSlicer**

  Add under Printer Settings → Machine G-code → Change filament G-code:
  ```gcode
  CHANGE_TOOL TOOL={next_extruder} TEMP={new_filament_temp}
  M400
  ```

  `TEMP=` tells the toolchange what the incoming tool should heat to. Without it the macro can only fall back to the outgoing tool's temperature, which is correct when both tools print at the same temperature and wrong when they don't: the new tool gets brought to the old filament's temperature and only corrected afterwards. Passing it heats each tool to its own temperature once, with no overshoot and no second wait.

  `new_filament_temp` is a plain value OrcaSlicer computes for the incoming filament rather than an array you index yourself, and it is first-layer aware: the first layer temperature on layer one, the other-layers temperature after that. Earlier versions of this README used `nozzle_temperature[next_extruder]`. Either form works for an ordinary toolchange, but the scalar is harder to get wrong.

  > ⚠️ **If your toolchanges heat to the filament's maximum temperature**, the snippet is not the cause and changing it will not help. Check **Enable tower interface features** in Print Settings. When it is on, OrcaSlicer deliberately overrides the incoming filament's temperature on prime tower interface layers, where two materials meet, to that filament's **Interface layer print temperature**. That setting defaults to `-1`, and OrcaSlicer's own tooltip for it reads "If set to -1, use max recommended nozzle temperature". So every interface-layer toolchange heats to the filament's max, by design.
  >
  > Fix it at the source: either give **Interface layer print temperature** a real value on each filament, or turn **Enable tower interface features** back off. It is off by default, so if you have not touched it this does not apply to you. The override is applied after the placeholder is filled in, so no change to the G-code above can avoid it.

  **PrusaSlicer / SuperSlicer**

  1. Under Printer Settings → General → Capabilities, set **Number of extruders** to match your tool count
  2. Make sure **Single Extruder Multimaterial Printer** is **unchecked**; this mode is for filament switchers (MMU/AMS) and must be off for a tool changer
  3. Under Printer Settings → Custom G-code → Tool change G-code, add:
  ```gcode
  T{next_extruder}
  {if (wipe_tower)}
  G0 Y{wipe_tower_y+2} X{wipe_tower_x+2} F{travel_speed*60}
  G0 Z{layer_z} F{travel_speed*60}
  {endif}
  M104 S{temperature[next_extruder]}
  TEMPERATURE_WAIT SENSOR=extruder MINIMUM={temperature[next_extruder]-5} MAXIMUM={temperature[next_extruder]+5}
  ```

  This selects the next tool, moves to the wipe tower (if one is enabled) so the new (initially cold) tool heats and purges there, then sets the new tool's temperature and waits for the induction coil to bring it up to temperature before printing resumes.

  This snippet works as written and needs no changes. If your tools print at different temperatures you can optionally replace the `T{next_extruder}` line with the form below, which heats the new tool straight to its own temperature instead of reaching the old tool's first and correcting afterwards:

  ```gcode
  CHANGE_TOOL TOOL={next_extruder} TEMP={temperature[next_extruder]}
  ```

  Keep the `M104` and `TEMPERATURE_WAIT` lines either way; they cost nothing once the temperature is already correct.

  **SuperSlicer** uses the same template engine and variable names as PrusaSlicer, so this snippet works unchanged in both. (PrusaSlicer's older `[...]` placeholder form also works in both if you prefer it, e.g. `M104 S[temperature[next_extruder]]`.)

  **Cura**

  > ⚠️ This configuration has not been fully verified. If you run into issues, ask on the [Bondtech Discord](https://discord.gg/XDX9jDXN6e).

  Cura handles tool changes differently from the PrusaSlicer family: it emits the `T{n}` command automatically and runs **per-extruder** start/end G-code, so there is no single "tool change G-code" field to edit. Configure it as follows:

  1. In **Settings → Printer → Manage Printers → Machine Settings**, set **Number of Extruders** to match your tool count. Cura then outputs `T0`, `T1`, … automatically at each tool change.
  2. Enable **Prime Tower** (search "prime tower" in the print settings). This is Cura's equivalent of the wipe tower; Cura moves to it and purges the freshly heated tool automatically, so you don't script the move yourself.
  3. In **Machine Settings**, open each extruder's tab and add to its **Extruder Start G-code** (this runs every time that tool becomes active):
  ```gcode
  M104 S{material_print_temperature}
  TEMPERATURE_WAIT SENSOR=extruder MINIMUM={material_print_temperature}
  ```

  > **Notes for Cura:**
  > - Cura's start/end G-code does **not** support arithmetic in placeholders (e.g. `{material_print_temperature - 5}` will not work), so use the bare target. Because an INDX tool is always cold when picked up, waiting on `MINIMUM` alone is sufficient; the nozzle only ever needs to heat *up* to temperature.
  > - Do **not** set per-extruder **Standby Temperature** values; passive tools cannot be preheated in the dock (see [Temperature & Induction Settings](#temperature--induction-settings)).
- **Slicer profiles:** Pre-made printer profiles for INDX are being developed and will be made available before release. They are not ready for general use yet.

---

**Part 5: Designing for INDX**

---

## Designing for INDX

This section is for users who want to design custom mounts, docks, or printer integrations for INDX.

### Dock Design

The dock holds passive tools in precise, repeatable positions so the Smart Head can pick them up reliably. There are strict geometry requirements; a dock that doesn't meet them will cause failed or inconsistent tool changes.

The reference dock design is available on [github.com/BondtechAB/INDX](https://github.com/BondtechAB/INDX). Use it as the starting point for any custom design.

**Key design constraints**

Each dock is approximately **70mm tall, 28.5mm wide (X), and 25mm deep (Y)**. Minimum tool center-to-center spacing is **34mm** bare, or **41mm** when using the Bondtech part cooling solutions. The design must achieve a pickup repeatability of **within 0.2mm**.

**Material recommendations**

Bondtech's sold docks use SLS-printed Nylon 12 GF. For self-printed docks, use a material that is dimensionally stable at elevated temperatures; the dock sits near the print area and will experience heat cycles. ASA or ABS are common choices. Avoid PLA.

**Community designs**

Community dock designs for specific printers and frames are collected in [`community/`](community/). The [2020 extrusion dock](community/1_printer_agnostic/2020-dock/) there is a good worked example of adapting the reference geometry: it keeps the same hardware and the same dimensions on every other axis, and only the body changed. If you design a dock for an unlisted setup, submit it via pull request.

### Part Cooling

INDX's modular part cooling system is designed to be extended by the community. The cooling solution snaps onto the outside of the Smart Head cowlings, and the interface geometry is published, so you have everything you need to design against it.

What a shroud actually attaches to is the fan shroud clip, [`INDX_Part_Cooling_Interface_left.stl`](CAD/STL/INDX_Part_Cooling_Interface_left.stl) and [`INDX_Part_Cooling_Interface_right.stl`](CAD/STL/INDX_Part_Cooling_Interface_right.stl). The cowlings those clip to are [`INDX_Front_cover_left.stl`](CAD/STL/INDX_Front_cover_left.stl) and [`INDX_Front_cover_right.stl`](CAD/STL/INDX_Front_cover_right.stl). All of it is in the reference STEP model as well, which is the better starting point for CAD work. See [CAD Files & Templates](#cad-files--templates).

Bondtech's own ducts are in the repository too and are worth reading as worked examples of the same interface: the dual 40×10 blower ducts and the CPAP ducts, including its top manifold.

Two constraints to design within. Minimum tool centre-to-centre spacing goes from 34 mm bare to **41 mm** with the Bondtech cooling solutions fitted, so anything wider than those eats into dock spacing. And the tools cool passively while docked, so a shroud that blocks airflow around a parked tool works against the system rather than with it.

If you design a custom part cooling solution, we'd love to see it. Community-contributed cooling designs are welcome in [`community/`](community/); submit yours via pull request.

### CAD Files & Templates

All official CAD files are hosted on **Bondtech's GitHub**: [github.com/BondtechAB/INDX](https://github.com/BondtechAB/INDX)

**Reference geometry (STEP)**

The STEP file is the master reference model; it contains the geometry of every printable part listed below, so use it as the starting point for designing custom mounts, adapters, or cooling solutions.

| File | Format | Description |
| ---- | --- | --- |
| [`INDX_simplified_1.19.step`](CAD/INDX_simplified_1.19.step) | STEP | Simplified reference model of the full INDX assembly. Includes the open nozzle front, so you can modify it and print your own |
| [`INDX_Link_simplified_1.0.step`](CAD/INDX_Link_simplified_1.0.step) | STEP | Simplified reference model of the Link Board, for designing a mount or enclosure for it |

**Printable parts (STL)**

These are print-ready STLs of the individual parts. They are all derived from the reference STEP above.

**Which Tool Dock body to print.** The dock body comes in two variants because the two 15×15 profiles do not take the same fastener: MakerBeam XL has an indexing track running down the slot that a standard 1515 T-nut will not clear.

Print the **standard extrusion** body unless you have a reason not to. It suits both standard 1515 and MakerBeam XL, so it is the easier all-round choice and it keeps the dock usable if you ever move it to a different frame. The **MakerBeam XL** body is the original, and it is the geometry Bondtech's ready-made docks use; it mounts on standard 1515 as well, given a fastener that suits. Print one or the other, not both. The spring lid and magnet holder are the same either way.

See [Mount the Dock](#2-mount-the-dock) for what the dock mounts to.

| File | Part | Description |
| ---- | ---- | --- |
| [`INDX_MGN12H_X-carriage.stl`](CAD/STL/INDX_MGN12H_X-carriage.stl) | X-carriage adapter | Mounts the Smart Head to MGN12H linear rails (6mm belts) |
| [`INDX_Front_cover_left.stl`](CAD/STL/INDX_Front_cover_left.stl) | Smart Head cover | Front cover, left half |
| [`INDX_Front_cover_right.stl`](CAD/STL/INDX_Front_cover_right.stl) | Smart Head cover | Front cover, right half |
| [`INDX_PCB_Cover.stl`](CAD/STL/INDX_PCB_Cover.stl) | PCB cover | Protective cover for the Bondtech INDX PCB |
| [`INDX_Part_Cooling_Interface_left.stl`](CAD/STL/INDX_Part_Cooling_Interface_left.stl) | Part cooling mount | Fan shroud clip, left. Attaches a fan shroud to the left Front Cover; see [Install the Smart Head](#1-install-the-smart-head) |
| [`INDX_Part_Cooling_Interface_right.stl`](CAD/STL/INDX_Part_Cooling_Interface_right.stl) | Part cooling mount | Fan shroud clip, right. Attaches a fan shroud to the right Front Cover |
| [`INDX_4010_Duct_Left.stl`](CAD/STL/INDX_4010_Duct_Left.stl) | Part cooling (4010) | Dual 40×10 blower duct, left half |
| [`INDX_4010_Duct_Right.stl`](CAD/STL/INDX_4010_Duct_Right.stl) | Part cooling (4010) | Dual 40×10 blower duct, right half |
| [`INDX_CPAP_Duct_Left.stl`](CAD/STL/INDX_CPAP_Duct_Left.stl) | Part cooling (CPAP) | CPAP duct, left half |
| [`INDX_CPAP_Duct_Right.stl`](CAD/STL/INDX_CPAP_Duct_Right.stl) | Part cooling (CPAP) | CPAP duct, right half |
| [`INDX_CPAP_Duct_Top.stl`](CAD/STL/INDX_CPAP_Duct_Top.stl) | Part cooling (CPAP) | CPAP duct, top manifold |
| [`INDX_Beacon_Cartographer_Mount.stl`](CAD/STL/INDX_Beacon_Cartographer_Mount.stl) | Probe mount | Mount for a Beacon / Cartographer scanning probe |
| [`INDX Tool Dock 1515 Standard extrusion.stl`](CAD/STL/INDX%20Tool%20Dock%201515%20Standard%20extrusion.stl) | Tool Dock body | Dock main body, one per dock. Suits standard 1515 **and** MakerBeam XL; print this one unless you have a reason not to |
| [`INDX Tool Dock 1515 MakerbeamXL.stl`](CAD/STL/INDX%20Tool%20Dock%201515%20MakerbeamXL.stl) | Tool Dock body | Dock main body, one per dock. Matches Bondtech's ready-made docks. Mounts on standard 1515 too; see the fastener note in [Mount the Dock](#2-mount-the-dock) |
| [`INDX Tool Dock 1515 Spring lid.stl`](CAD/STL/INDX%20Tool%20Dock%201515%20Spring%20lid.stl) | Tool Dock part | Spring lid, common to both dock bodies |
| [`INDX Tool Dock 1515 Magnet holder.STL`](CAD/STL/INDX%20Tool%20Dock%201515%20Magnet%20holder.STL) | Tool Dock part | Magnet holder slider, common to both dock bodies |
| [`INDX_Dock_calibration_tool.stl`](CAD/STL/INDX_Dock_calibration_tool.stl) | Dock calibration tool | Printed jig for calibrating dock position during initial setup; see [Dock Position Calibration](#dock-position-calibration) |

The repository is licensed under **GPL-3.0**.

More files (additional X-carriage adapters, tool body templates) will be added as the project develops. Community contributions are welcome via pull request.

---

**Part 6: Maintenance, Support & Community**

---

## Maintenance

The Smart Head's mechanism is designed to run for a long time with minimal upkeep, but a periodic inspection keeps tool changes reliable and prevents wear from going unnoticed.

**How often:** Perform this inspection every **500,000 tool cycles**. More frequent checks can be beneficial. If you don't change tools often, inspect roughly every **1,000 print hours** instead.

Work through the following checks:

- **Check for play in the opening mechanism and drive gear assembly.** There should be no slop anywhere. Feel the nozzle lever assembly pin to confirm there is no play in the opening mechanism or in the drive gear assembly.
- **Check the activator moves freely.** With the extruder fully closed, the activator should be able to be pushed slightly up and down easily, without sticking or catching.
- **Check the magnet activator assembly.** It should move completely friction-free, with no resistance.
- **Inspect the coil for nozzle contact.** Check that misaligned (crooked) nozzles have not struck the coil. The coil area should be free of any marks left by a nozzle.
- **Inspect the gears.** Check that the drive gear assembly is not damaged and that the gears are not worn.
- **Grease the gear teeth.** Apply fresh grease to the drive gear teeth and the motor gear teeth.

### Nozzle clog: cold pull procedure

A cold pull clears carbonized plastic, debris, and partial or full clogs from the nozzle. It is the most effective way to restore a blocked or under-performing tool.

**What you need:** Standard PLA filament. Use a light color so you can inspect the extracted debris.

**Steps:**

1. **Park the tool and disconnect the PTFE tube.** Park the target tool. With the Smart Head receiver open, remove the tool from the dock and disconnect the PTFE tube from the top of the tool. Check that no loose filament or debris remains in the upper guide channel.

2. **Seat the tool in the Smart Head.** Manually insert the tool into the Smart Head, keeping the receiver open throughout the entire procedure.

3. **High-temperature flush.** Set the nozzle temperature to **250–280°C**. Once at temperature, feed PLA manually down into the tool and push until ~30mm extrudes from the nozzle tip. This fills the melt zone and integrates any old residue into the new PLA plug.

4. **Cool and pack.** Drop the temperature setpoint to **120°C**. While the tool cools, maintain steady downward pressure on the filament. This counteracts shrinkage and ensures the PLA packs tightly into the nozzle geometry.

5. **Pull.** When the temperature reaches 120°C, press the tool body firmly down into the Smart Head with one hand to hold it in place. With the other hand, pull the filament slowly and steadily upward. Increase force gradually until the plug releases from the nozzle walls and slides out. Pulling too fast will snap the filament before the plug clears.

6. **Smooth withdrawal.** Once the plug releases, maintain a steady, continuous upward motion until the entire PLA strand is fully extracted from the tool.

**Verify the result.** Inspect the tip of the extracted plug. On a CHT tool, a successful pull shows **three separate thin strands** at the tip — the negative impression of the CHT internal geometry. A blunt or broken tip means the plug didn't release cleanly; repeat the cycle.

Repeat the full cycle **2–3 times** to ensure all carbonized material and debris are fully extracted.

---

## Troubleshooting

### Tool not picking up reliably

If the Smart Head consistently fails to pick up a tool, or picks up unreliably, work through these causes in order:

**Dock position miscalibrated**

This is the most common cause. Even a small X or Y offset is enough to cause failed or inconsistent pickups. Go back to [Dock Position Calibration](#dock-position-calibration) and redo the alignment for the affected tool. Re-home the printer first (`G28`) to make sure the coordinates are accurate before recording anything.

**Lost steps from a previous crash**

If the Smart Head has crashed into the dock or a tool, the stepper motors may have lost steps. This means the position shown in your interface no longer matches the actual toolhead position; coordinates you saved before the crash may now be wrong. Re-home the printer and redo dock position calibration for any tools affected.

**Dock not mounted rigidly**

If the dock has shifted or flexes during operation, the tool positions will no longer match the calibrated coordinates. Check that the dock is firmly secured to its mounting point; no movement should be possible when you push on it. Retighten any fasteners and redo dock position calibration after.

### Nozzle not reaching temperature / overheating

The induction coil is fast and powerful; it can heat the nozzle to dangerously high temperatures quickly. If you are seeing the nozzle under-read (temperature reported lower than actual) or unexpectedly overheating, the most likely cause is that the passive tool is not fully seated or is misaligned in the Smart Head.

When the nozzle is not correctly positioned inside the coil, the IR sensor reads the temperature from a suboptimal angle, resulting in a lower reading than the actual nozzle temperature. The firmware then continues heating to compensate, causing the nozzle to overheat beyond the intended target.

> ⚠️ Do not allow paper, wiring, or other flammable material near the induction coil area. Keep firmware up to date; incorrect firmware versions may not correctly limit heating.

**If the nozzle is not reaching temperature:**
- Verify the passive tool is fully picked up and seated correctly in the Smart Head; it should click into the Maxwell coupling and show no visible misalignment
- Check that the tool has not been bent or damaged in a way that affects its position inside the coil
- Confirm the firmware is up to date

**If the nozzle is overheating:**
- Immediately cancel any print or heating command
- Inspect the tool for misalignment or damage
- Do not continue using the tool until the cause is identified

### Filament jam in passive tool

Filament jams in a passive tool are resolved the same way as any standard FDM nozzle jam:

1. Heat the nozzle to printing temperature for the material that is stuck
2. Attempt a manual retraction to pull the filament back out; if it doesn't move, heat slightly higher and try again
3. If the filament has broken inside the tool, carefully remove the tool from the dock and clear the jam from the top of the filament path using a thin wire or fresh filament to push the remnant out
4. Inspect the PTFE tube inside the tool for damage or deformation; replace it if it has been heat-damaged
5. Check the nozzle for a partial or full clog and clean or replace as needed

For persistent clogs or partial blockages that survive the steps above, use the [cold pull procedure](#nozzle-clog-cold-pull-procedure).

### DX extruder not opening or closing correctly after a crash

If the Smart Head has crashed into the dock, a tool, or part of the printer frame, the DX extruder mechanism may have been physically damaged. Symptoms include:

- The extruder no longer grips filament properly
- The extruder arm does not open or close as expected when a tool is picked up or deposited
- Inconsistent extrusion or grinding sounds during extrusion

**What to do**

Visually inspect the Smart Head for any obvious physical damage: bent parts, broken clips, or anything that looks out of position. Do not attempt to force the mechanism open or closed if it is stuck.

If hardware damage is confirmed or suspected, contact Bondtech support at [bondtech.se/contact](https://www.bondtech.se/contact/) before continuing to use the system. Running with a damaged DX extruder can cause print failures and may cause further damage.

### INDX has the wrong idea of which tool is loaded

After a power cut mid-toolchange, a crash, or a tool that was pulled off by hand, the saved state can disagree with reality: INDX believes a tool is locked when the head is empty, or believes it is empty when a tool is still in. Symptoms are a tool change that refuses to run, a `G28 Z` that errors on the load-cell seat check, or `TOOL_STATUS` showing a tool you know is not there.

Two macros exist to get out of it. Both are deliberately blunt, so read what they do before running either.

```gcode
MANUAL_TOOL_REMOVE
```

Opens the latch so you can take the tool off by hand, then records the head as open and empty. **The tool is released the moment the latch opens**, so support it with your hand first or it will drop. Use this when a tool is physically in the head and you want it out.

```gcode
MANUAL_TOOLHEAD_RESET
```

Records the head as open and empty without touching the latch. Use this when the head is *already* empty and only the saved state is wrong. It changes what INDX believes, not what the hardware is doing, so running it while a tool is still locked in leaves the two further apart than before.

The opposite case, a tool on the head that INDX does not know about (you put it there by hand, or the saved state says empty):

```gcode
MANUAL_TOOL_SEAT TOOL=n
```

Locks the latch onto the tool and records it as tool `n`. Hold the tool in place on the Smart Head while it locks. This is also how the first tool gets on before the docks are measured, and how T0 gets on before the first `G28`.

After any of these, pick a tool up normally with `Tn` or `CHANGE_TOOL` and the state will be correct again from there. If the latch itself will not move, stop and see [DX extruder not opening or closing correctly after a crash](#dx-extruder-not-opening-or-closing-correctly-after-a-crash) rather than forcing it.

### `indxmcu` not connecting

If Klipper reports a timeout or cannot find `indxmcu` on startup, work through these causes:

- **Firmware not flashed**: the most likely cause on a first startup. If you haven't flashed the Bondtech INDX PCB, or the flash didn't complete successfully, the board will not appear. Go back to [Flash the Bondtech INDX PCB](#4-flash-the-bondtech-indx-pcb) and redo the process.
- **Wrong `serial` path**: the path in `[mcu indxmcu]` must match exactly. SSH into your printer and run `ls /dev/serial/by-id/` to get the correct path, then update your config and restart Klipper.
- **Communication mode switch not set correctly**: check the switch on the INDX MCU PCB matches your communication mode (CAN or USB). See [Wiring](#3-wiring) for reference images.
- **INDX Link Cable not fully seated**: check both ends of the cable at the Link Board and the Bondtech INDX PCB.

**Recovery: CAN_RESET jumper**

If the board has non-functioning firmware and cannot be reached normally, you can force a firmware re-fetch using the CAN_RESET jumper on the Bondtech INDX PCB:

1. Power down the printer
2. Install the CAN_RESET jumper on the PCB
3. Power up; the bootloader will reset the CAN address to the default (121) and fetch and install new firmware, even if firmware is already present
4. Once flashing is complete, power down, remove the CAN_RESET jumper, and power up again

### Link Board not detected on Raspberry Pi 3

If you are running a **Raspberry Pi 3** and the Link Board is not being detected as a USB device, even though the cable is connected and the board is powered, you may be hitting a known kernel bug affecting USB device enumeration on the Pi 3.

**Symptom:** `ls /dev/serial/by-id/` returns nothing, or the Link Board disappears after a reboot, despite the board being powered.

**Fix:**

1. SSH into your Raspberry Pi and open the boot config file:

   ```bash
   sudo nano /boot/firmware/config.txt
   ```

2. Use the arrow keys to scroll to the very end of the file. Add the following on its own line (make sure the entire entry is on a single line with no line breaks):

   ```
   dtoverlay=dwc2
   ```

3. Save the file: press **Ctrl+O**, then press **Enter** to confirm.

4. Exit nano: press **Ctrl+X**.

5. Verify the line was added correctly before rebooting:

   ```bash
   grep "dtoverlay=dwc2" /boot/firmware/config.txt
   ```

   You should see `dtoverlay=dwc2` printed back. If nothing is returned, open the file again and repeat from step 2.

6. Reboot your Raspberry Pi:

   ```bash
   sudo reboot
   ```

After rebooting, run `ls /dev/serial/by-id/` to confirm the Link Board is now visible, then continue with Klipper configuration.

> See the upstream kernel issue for background: [raspberrypi/linux#6100](https://github.com/raspberrypi/linux/issues/6100)

### Smart Head crashes into dock on homing

If the Smart Head slams into the dock or the docked tools when you run `G28`, the most likely cause is that the homing order has not been configured. By default, Klipper homes X before Y; if the Smart Head is near the dock when homing starts, a full-speed X move can send it directly into the dock.

Include `homing.cfg` (or merge its `[homing_override]` into yours) so Y homes before X. See [Homing order](#homing-order-important). After any crash, re-home the printer before moving on; the stepper motors may have lost steps, making the position shown in your interface unreliable.

### Extruder feeding filament in the wrong direction

If filament moves backward (out of the nozzle) when you issue an extrude command, the motor direction is inverted. Add `!` to the `dir_pin` line in your `[extruder]` config and restart Klipper:

```ini
dir_pin: !indxmcu:motor_dir
```

Re-run the extrude check from [Initial Startup](#2-check-extruder-motor-direction) to confirm the direction is now correct.

### "Cannot extrude — minimum extrude temperature" error

Klipper prevents extrusion below a minimum temperature to protect against cold extrusion. This commonly appears during initial startup when you try to verify motor direction before the nozzle is hot.

Either heat the nozzle to printing temperature first (`M104 S200` and wait), or — on Kalico — allow cold extrusion at runtime with `M302 P1` (no config change or restart needed). Run `M302 P0` to re-enable the protection once you've confirmed motor direction.

> **Note:** Tool changes themselves are not affected by this — the latch moves during a tool change run through `INDX_EXTRUDER_MOVE`, which operates the extruder cold without touching `min_extrude_temp`. This only comes up for manual extrude/direction checks.

### Heatsink fan runs continuously on startup

The heatsink fan defaults to running continuously when the Bondtech INDX PCB has no firmware installed, or while firmware is being updated. If the fan runs non-stop and the printer cannot connect to `indxmcu`, flash the firmware; see [Flash the Bondtech INDX PCB](#4-flash-the-bondtech-indx-pcb).

### Accelerometer not responding

If `ACCELEROMETER_QUERY` returns an error, check that the `[lis2dw]` section in your config has the correct `i2c_mcu` and `i2c_bus` values:

```ini
[lis2dw]
i2c_mcu: indxmcu
i2c_bus: sercom3
```

If the values are correct and the accelerometer still doesn't respond, check that `indxmcu` itself is connected; an MCU connection issue will prevent all sensor reads.

### PTFE tube knocks a tool out of the dock mid-print

If a docked tool is being displaced during a print, loose PTFE tubes are the most likely cause. With four or more tools, unrestrained tubes move freely during toolhead motion and can knock into docked tools hard enough to dislodge them.

Bundle and clip the PTFE tubes together so they move as one unit, or route and secure them along the top interior of the printer frame. If a tool has been knocked out of the dock, cancel the print, re-seat the tool, and add tube management before continuing.

### Slicer not triggering correct tool changes

If tools are not being swapped during a print, or the slicer is generating incorrect tool change G-code, check the following:

**PrusaSlicer / SuperSlicer:** Make sure **Single Extruder Multimaterial Printer** is **unchecked** under Printer Settings → General → Capabilities. This mode is for filament switchers (MMU, AMS) and generates the wrong G-code for a tool changer. With it enabled, the slicer will not output standard `T0`, `T1`… commands.

**All slicers:** Confirm you have added the required tool change G-code snippet for your slicer. Without it, the slicer may pause or error at tool changes rather than triggering the INDX macros. See [Slicer Setup](#slicer-setup) for the correct snippet for your slicer.

---

## FAQ

**How many tools can I run simultaneously?**

For the Development Kit, there is no fixed limit; you can run as many tools as your printer has physical space for in the dock. The Prusa CORE One / CORE One L kit supports up to 8 tools, as that is the maximum that fits in the Prusa enclosure.

**Does each tool need its own filament spool?**

Yes. Each passive tool has its own direct filament feed. There is no shared filament path.

**Do I need a wipe tower?**

A wipe tower is recommended but not required. INDX produces near-zero ooze by design, so the wipe tower can be kept much smaller than with filament-switcher systems. Whether you need one depends on the materials you're printing with.

**Will it work with my [printer model]?**

If your printer is CoreXY with open firmware, it's likely compatible. Community-contributed configs and integration guides live on [github.com/BondtechAB/INDX](https://github.com/BondtechAB/INDX). If your printer isn't listed, you can contribute an integration.

**Can I mix nozzle sizes?**

Hardware-wise, yes. There is no restriction on mixing nozzle sizes across tools. Each Thin Passive Tool carries its own nozzle independently, so a setup with e.g. two 0.4mm, one 0.6mm, and one 0.8mm tool is fully valid. Whether your slicer supports assigning different nozzle diameters per extruder is a slicer question, not an INDX limitation.

Note that the **Prusa CORE One / CORE One L kit** ships with either 4 or 8 tools, all 0.4mm CHT; this is fixed and cannot be customized at order time. You can however add extra tools in other sizes to your order separately.

**What happens if a tool change fails mid-print?**

If a tool change fails, the printer errors out with a thermal error and the print is not recoverable.

**Is the induction heating safe? Any RF interference concerns?**

Yes. INDX has been tested and approved in accordance with Swedish law and the guidelines set by **Elsäkerhetsverket** (the Swedish National Electrical Safety Board), which is the authority responsible for electrical safety and electromagnetic compatibility (EMC) in Sweden. Elsäkerhetsverket enforces the EU Low Voltage Directive (LVD, 2014/35/EU) and the EMC Directive (2014/30/EU), which together require that electrical products are safe to use and neither cause nor are susceptible to electromagnetic interference.

The induction coil in the Smart Head operates at close range and low power, producing a highly localized magnetic field at the nozzle. It is not a transmitter in any meaningful sense; it does not emit RF energy across the room. EMC testing confirmed no interference with 3D printers, Wi-Fi networks, or other common equipment in the same space.

**Can I add more tools after initial setup?**

Yes. Additional Thin Passive Tools can be purchased and added at any time, from both Bondtech and Prusa.

For the **Development Kit**, the limit is physical dock space. There is no firmware cap; run as many tools as your printer can fit.

For the **Prusa CORE One / CORE One L kit**, both printers are physically limited to 8 tools maximum. You can purchase additional tools beyond what came in your kit, but you cannot exceed 8 installed tools on the printer.

**Does INDX work with Marlin?**

No. INDX requires Klipper, Kalico, or RepRap Firmware (RRF). Marlin is not supported.

**Can I set standby or preheat temperatures for parked tools?**

No. Passive tools contain no electronics; there is no way to heat a tool while it is sitting in the dock. Do not configure standby temperatures for individual tools in your slicer; the firmware has no way to act on them and it will produce errors.

**Is RRF (RepRapFirmware) supported?**

Yes. See the [Duet INDX Toolboard documentation](https://docs.duet3d.com/en/Duet3D_hardware/Duet_3_family/INDX_Toolboard) for RRF flashing and configuration, plus the [Firmware Configuration: RRF](#rrf-reprapfirmware) section. Ask on the [Bondtech Discord](https://discord.gg/XDX9jDXN6e) if you need help.

---

## Community & Contributing

The INDX ecosystem is built by the people running it. Bondtech maintains the core hardware and firmware, but the printer integrations, dock designs, part cooling solutions, and real-world usage guides come from community members who've done the work and shared it. If you've got INDX running, you're in a position to save the next person significant time.

- **Chat & community help:** [Bondtech Discord](https://discord.gg/XDX9jDXN6e), the best place for quick questions, sharing builds, and getting community support
- **Official support:** For issues with your hardware or order, submit a ticket at [bondtech.se/contact](https://www.bondtech.se/contact/)
- **CAD files & community configs:** [github.com/BondtechAB/INDX](https://github.com/BondtechAB/INDX)

### Contributing a printer integration

If you've integrated INDX with a printer that isn't in the repo yet, or significantly improved an existing integration, we want to hear from you. Merged PRs carry Bondtech's name alongside yours, so the bar is real: complete documentation, a clear setup guide, and files that others can actually use.

**What a good PR includes:**

- **Setup guide**: a written walkthrough of the full integration: mounting the Smart Head, routing cables, configuring the dock, and getting through initial calibration. It should be complete enough that someone starting from scratch can follow it without needing to ask for help.
- **Printer config**: a clean, working `printer.cfg` (or RRF equivalent) with INDX-specific sections clearly identified.
- **Dock design**: if you designed a custom dock, include the source files (STEP or similar) and any printable STLs. Printable files must be **designed to print without supports**, with overhangs addressed in the geometry, not worked around in the slicer.
- **X-carriage adapter**: if you designed or adapted one, include it with the same requirements.
- **Photos or video**: not required, but high-quality build photos or a video walkthrough of the installation process make the integration significantly more approachable. A good build guide video that shows the tricky parts is worth more than any amount of written description.

**What we look at before merging:**

Before a PR is merged, Bondtech will test the integration. What we're evaluating:

- **Print volume**: INDX always costs 28.5mm of Y-travel due to tool clearance. The integration must not lose more than that compared to a reference INDX build. Dock placement, cable routing, and any printed parts should be designed so that 28.5mm is the total loss, not a starting point. Exceeding it requires a compelling justification.
- **Tool count**: the design should support as many tools as the printer's build space allows. Leaving capacity on the table without a clear reason is a red flag.
- **Closeness to stock**: the fewer deviations from a standard build of that printer, the better. An integration that requires minimal modifications to the printer itself is easier to install, easier to maintain, and easier to recommend. Elegance here is rewarded.
- **User experience**: installation should be straightforward and the day-to-day experience of running the integration should be solid. Rough edges that could have been designed out should be designed out.

**How to submit:**

1. Fork [github.com/BondtechAB/INDX](https://github.com/BondtechAB/INDX)
2. Add your files under the appropriate printer folder (create one if it doesn't exist), following the structure of existing integrations
3. Open a pull request with a short summary of what you're contributing and what printer it covers

Not sure if your integration is ready? Share it on Discord first; the community can help you fill gaps before you submit.

---

*This wiki is community-maintained. Found an error or want to contribute? Open an issue or PR on [github.com/BondtechAB/INDX](https://github.com/BondtechAB/INDX) or ask on [Discord](https://discord.gg/XDX9jDXN6e).*
