hatchna/INDX/CAD/INDX_simplified_1.19.step

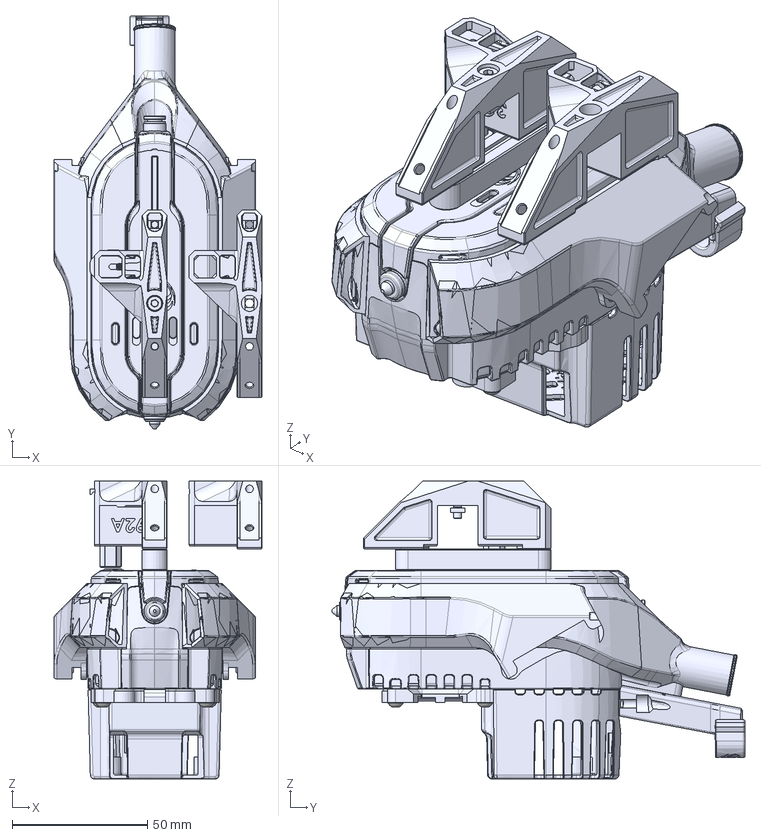
[picture p1: CAD file, 2026-11-01]
CAD/INDX_simplified_1.19.step
76.8 x 152.5 x 110.0 mm
INDX Strain relief clip
INDX Strain relief Mount 02PRT00389
Nozzle front (2)
Nozzle assembly (2)
01MCH00281 (1)
01MCH00280 (1)
CPK DIN 6325 härdad Cylindrisk Pinne_STIFT1x12m6 (1)
S-03-08-N (3) x 2
01PNM00279 (1)
light guide x 2
INDX CPAP adapter FDM
INDX 4010 adapter FDM
Heatset insert M3x4 (1) x 2
INDX PCB Cover 01PRT00344
INDX Tool Dock Universal 1515 Bar_Activator Magnet holder
S-03-08-N x 2
S-05-08-N
Lesjöfors 2296_Komprimerad
INDX Tool Dock Universal 1515 Bar_Spring lid
MC6S_M3X10OBEH
FKM Fyrkantsmutter
Dock calibration tool XY
Nozzle front
NOZZLE ASSEMBLY
01MCH00281
CPK DIN 6325 härdad Cylindrisk Pinne_STIFT1x12m6
01MCH00280
S-03-08-N_1 x 2
01PNM00279
