hatchna/INDX/community/1_printer_agnostic/2020-dock/[a]_spring_lid_1x.stl

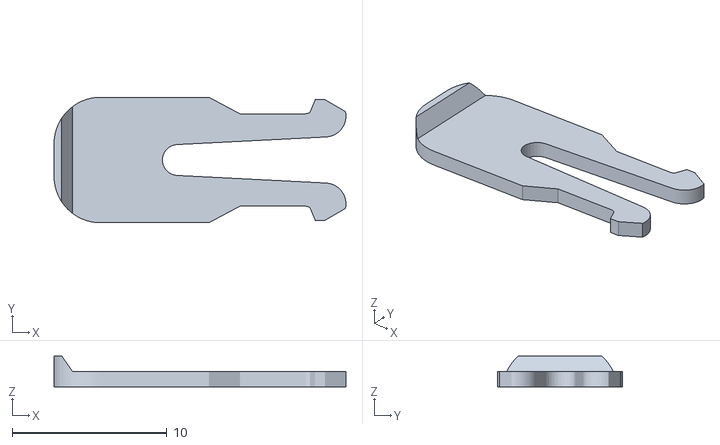
[picture p3: CAD file, 2026-11-01]
community/1_printer_agnostic/2020-dock/[a]_spring_lid_1x.stl
18.9 x 8.10 x 2.00
