hatchna/INDX/CAD/STL/INDX Tool Dock 1515 MakerbeamXL.stl

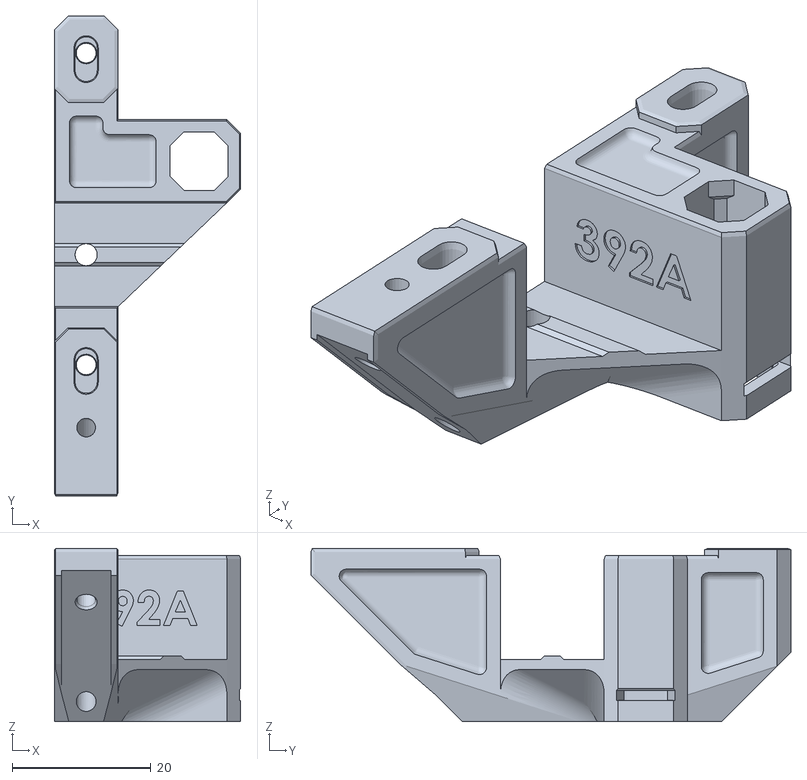
[picture p4: CAD file, 2026-11-01]
CAD/STL/INDX Tool Dock 1515 MakerbeamXL.stl
26.9 x 69.3 x 25.0
