hatchna/INDX/community/1_printer_agnostic/2020-dock/[a]_magnet_holder_1x.stl

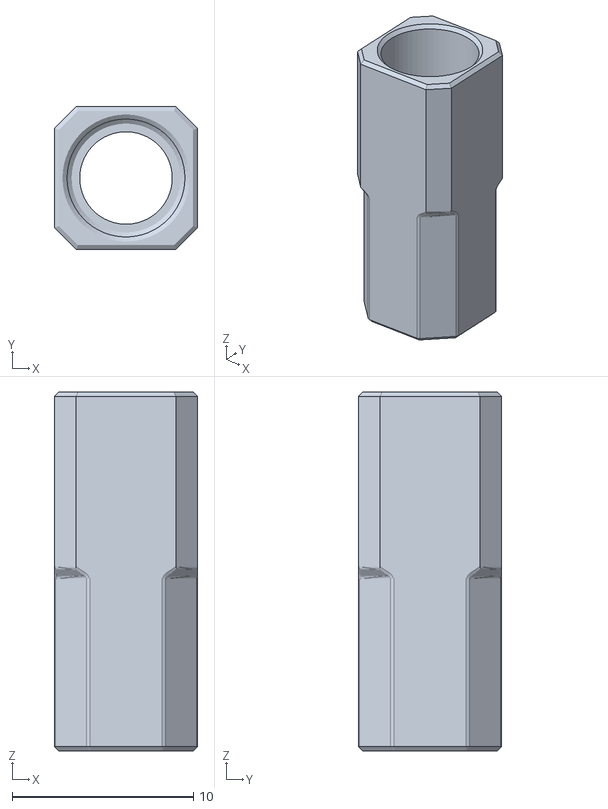
[picture p5: CAD file, 2026-11-01]
community/1_printer_agnostic/2020-dock/[a]_magnet_holder_1x.stl
7.90 x 7.90 x 19.8
