hatchna/INDX/(list of files, cad)

Other CAD files:
CAD/STL/INDX Tool Dock 1515 Spring lid.stl
