hatchna/INDX/macros/indx.cfg

#####################################################################
#  INDX USER CONFIGURATION
#####################################################################
#
#  CREDIT / ATTRIBUTION:
#  Base User Configuration: Bondtech INDX (https://github.com/BondtechAB/INDX)
#
#  Kinematic & Z-Hop Notes: Adapted from 3DPrintDemon & Charlie Mayall
#  (https://github.com/3DPrintDemon/DEMON_INDX, https://github.com/charliemayall/INDX)
#
#  Modifications by Nathan Hatch (hatchna):
#  - Configured coordinates and dimensions for 6-tool system (T0-T5)
#  - Implemented Spoolman multi-filament tracking (SET_ACTIVE_SPOOL,
#    CLEAR_ACTIVE_SPOOL, per-tool spool_id in T0-T5, RESTORE_SELECTED_SPOOLS)
#
#  This is the ONLY file you need to edit to adapt INDX to your
#  machine. All other INDX config files derive their values from
#  the variables defined here.
#
#  HOW TO CONFIGURE TOOLS:
#    Set tool_count to the number of tools installed.
#    Then fill in one pair of variables per tool (tN_x, tN_dock_y).
#       x      — X coordinate centred on the tool holder (mm)
#       dock_y — Y coordinate where the tool is fully seated (mm)
#                (deeper into the dock along dock_dir)
#
#    Tool number = variable suffix.  t0 = T0, t1 = T1, etc.
#    Add or remove pairs and update tool_count — the system adapts automatically.
#
#  WHAT IS AUTO-DERIVED:
#    - Trigger Y per tool (dock_y - dock_dir * trigger_offset)
#
#  WHAT NOT TO TOUCH:
#    - E-axis moves and dance geometry are fixed hardware constants
#      defined in indx-tc-macros.cfg. These are determined by the
#      INDX mechanism and must not be changed.
#
#####################################################################

[gcode_macro TOOL_POSITIONS]
description: INDX tool positions (user-configurable)

# ── How many tools are installed ─────────────────────────────────────────────
variable_tool_count: 6

# ── Z-hop during toolchange ──────────────────────────────────────────────────
#  z_hop = distance (mm) to raise Z before the toolhead travels to the dock.
#          Z clears first and lands before any XY movement starts, and on the
#          way back Z only drops once XY has reached the clearance line. Those
#          are separate moves on purpose: running Z and XY together raises or
#          lowers the nozzle gradually across the travel, which drags it over
#          the print at both ends of the change.
#          Set to 0.0 to disable.
variable_z_hop: 5.0

# ── Z offset auto-calibration probe position ─────────────────────────────────
#  Used by CAL_Z_AUTO_ALL to probe each tool and calibrate Z offsets.
#
#  probe_x / probe_y  — centre of the probing area (machine coords, mm).
#                       Set to the centre of your bed. The macro will probe
#                       here for debris clearing, then +5 mm in X for the
#                       actual measurement.
#  probe_fuzz         — legacy fuzz radius, kept for compatibility (mm).
#  probe_z_clearance  — Z height (gcode space) the toolhead travels to before
#                       descending to probe. Must clear any bed features.
variable_probe_x:          -1.0   # set to bed centre X, or -1 to auto-detect
variable_probe_y:          -1.0   # set to bed centre Y, or -1 to auto-detect
variable_probe_fuzz:         2.0
variable_probe_z_clearance: 10.0

# ── Homing move speeds ───────────────────────────────────────────────
#  These cover only the moves the homing override makes itself: the step
#  aside to clearance_y before X is homed, the Z hop, the travel to the
#  probe point, and the lift afterwards.
#
#  The homing passes themselves are plain G28 X / G28 Y / G28 Z, so Klipper
#  applies whatever homing_speed, second_homing_speed, homing_retract_dist
#  and homing_positive_dir are set on your steppers. Nothing here overrides
#  those, and they do not need repeating.
#
#  home_travel_feedrate = mm/min for the XY moves listed above.
#  home_z_feedrate      = mm/min for the Z hop and the post-probe lift.
#                         Lower this for a slow leadscrew.
variable_home_travel_feedrate: 3000
variable_home_z_feedrate:       900

# ── Homing seat check ────────────────────────────────────────────────────────
#  home_check_seat = ask the load cell whether a tool is seated before G28 Z.
#                    Opt-in, and off by default.
#
#                    The load cell is a reliable contact detector, which is what
#                    probing needs, and an unreliable scale, which is what this
#                    check needs. Its absolute reading in grams moves with the
#                    tare, and a head tared with a tool already in it reads near
#                    zero with that tool still seated. Turning this on means a
#                    bad reading can refuse a homing that would have been fine.
#                    Leaving it off means INDX trusts active_tool instead, which
#                    is what every other tool-change operation already trusts.
#
#                    Either way the load cell is still the Z probe. This setting
#                    only decides whether its absolute reading gates homing.
#
#                    Write True or False, capitalised: Klipper parses these as
#                    Python literals and a lower-case true is a startup error.
variable_home_check_seat: False

#  home_min_force_g = grams the load cell must show before G28 Z.
#                     Only used when home_check_seat is True.
#                     Empty head sits well below this.
#                     Raise if an empty head is accepted as seated;
#                     lower only if a seated tool is refused.
variable_home_min_force_g: 800.0

# ── Pickup and park checks ───────────────────────────────────────────────────
#  seat_check_enabled = check every pickup and every park with the load cell.
#                       On by default. Each check compares two readings taken
#                       standing still seconds apart, so the tare and the
#                       load cell's drift do not matter, unlike home_check_seat.
#                       With no calibrated load cell the checks are skipped
#                       with one console line. Set False to turn them off.
#                       Write True or False, capitalised.
#
#                       Pickup: the reading after the pickup must differ from
#                       the empty head before it by seat_min_force_g. If not,
#                       X/Y is re-homed and the tool picked up once more. If
#                       that fails too, a print pauses and anything else stops,
#                       with the heater off and no tool recorded. A reading
#                       between seat_empty_max_g and seat_min_force_g means
#                       something may be half seated on the head: no retry,
#                       the tool stays recorded, and it pauses or stops. G28 Z,
#                       CHANGE_TOOL and PARK_TOOL then refuse, also after a
#                       restart, until the head is checked by hand and
#                       MANUAL_TOOL_REMOVE or MANUAL_TOOL_SEAT TOOL=<n> is run.
#
#                       Park: the reading after the drop-off must differ from
#                       the seated one by park_min_change_g. If not, the tool
#                       is still on the head: INDX stops with the heater off
#                       and keeps the tool recorded as on the head.
variable_seat_check_enabled: True

#  seat_min_force_g  = grams a seated tool must show against the empty head.
#                      Seated tools show 1100 to 1900 g on the test machine,
#                      and 727 to 915 g on this Trident (T2 and T4 lowest).
#  seat_empty_max_g  = below this a failed pickup counts as an empty head.
#                      From here up to seat_min_force_g it counts as a tool
#                      that may be half seated, and INDX keeps it recorded.
#  park_min_change_g = grams the reading must change by when a tool is parked.
variable_seat_min_force_g: 600.0
variable_seat_empty_max_g: 230.0
variable_park_min_change_g: 425.0

# ── Dock approach direction ──────────────────────────────────────────────────
#  dock_dir = Y sign into the dock: -1 front (min Y), +1 rear (max Y).
#             Flips trigger line, unlock depths, peel, and the homing
#             X-clearance check relative to dock_y.
variable_dock_dir: -1

# ── Trigger offset ───────────────────────────────────────────────────────────
#  trigger_offset = distance (mm) from dock_y to the trigger line.
#                   trigger_y is auto-derived as: dock_y - dock_dir * trigger_offset
#                   Increase if the latch engages before the tool is fully seated;
#                   decrease if the toolhead overshoots the dock.
variable_trigger_offset: 5.0

# ── Safe lateral travel position ─────────────────────────────────────────────
#  clearance_y = Y coordinate where the toolhead clears ALL docked tools.
#                The toolhead moves here before any X travel between tools.
#                Set this to the Y position where no tool bodies are in the way.
#                It must be at least 26 mm from the most protruding dock
#                (a tool needs 25 mm, plus 1 mm margin), on the side away
#                from the docks (front docks: the highest tN_dock_y + 26 or
#                more). Homing and tool changes refuse to run otherwise.
variable_clearance_y: 23.0       # docks at -11: needs >= -11 + 26 = 15

# ── Dock calibration ──────────────────────────────────────────────────────────
#  docks_calibrated = False until the dock positions below are measured on
#                     your printer. While False, INDX refuses everything that
#                     drives into a dock: tool changes, parking, and a G28
#                     that would have to fetch T0 (the positions below are
#                     placeholders, and driving into them can crash the head).
#                     To home before the docks are measured, put T0 on the
#                     head by hand and run MANUAL_TOOL_SEAT TOOL=0, then G28.
#                     After measuring every dock, set True and RESTART.
variable_docks_calibrated: True   # dock positions below are measured

# ── Per-tool positions ────────────────────────────────────────────────────────
#  x      = X coordinate of the tool holder centre (mm)
#  dock_y = Y coordinate where the tool is fully seated (mm)
#           Move further along dock_dir to seat the tool deeper.
#
#  To add a tool:    add a new pair of lines and increment tool_count above.
#  To remove a tool: delete its pair of lines and decrement tool_count above.
#
variable_t0_x:       0.203
variable_t0_dock_y: -11
#
variable_t1_x:      45.0
variable_t1_dock_y: -11
#
variable_t2_x:      90.394
variable_t2_dock_y: -11
#
variable_t3_x:     208.806
variable_t3_dock_y: -11
#
variable_t4_x:     254.397
variable_t4_dock_y: -11
#
variable_t5_x:     299.428
variable_t5_dock_y: -11

# ── Tools that must never be heated ──────────────────────────────────────────
#  no_heat_tools = list of tool numbers that carry no hotend: a pen, a cutter,
#                  a camera, anything that is not a printing tool. CHANGE_TOOL
#                  picks these up and parks them like any other tool but never
#                  turns the coil on for them, whatever temperature the slicer
#                  asks for. Leave empty if every tool prints.
#                  Example for a pen in dock 3:  variable_no_heat_tools: [3]
variable_no_heat_tools: []

# ── Assembled at startup from the variables above — do not edit ──────────────
variable_tools: []

gcode:

#####################################################################
#  TOOL SHORTCUT MACROS (T0–T5) & SPOOLMAN INTEGRATION
#####################################################################
#
#  CREDIT / ATTRIBUTION:
#  - Tool shortcut routing (T0-Tn -> CHANGE_TOOL): Bondtech INDX
#  - Spoolman active spool management & persistence: Authored by Nathan Hatch (hatchna)
#
#  Slicers send T0, T1, etc. to select tools. Each macro below
#  routes to CHANGE_TOOL, which validates the index against the
#  tools list above and errors cleanly if the tool doesn't exist.
#
#  variable_active is what Mainsail and Fluidd read to show the tool
#  buttons and mark the tool on the head. INDX keeps it up to date.
#
#  If you add more tools, add more entries following the same pattern,
#  including the variable_active and variable_spool_id lines.
#
#####################################################################

# Spoolman multi-tool support
[gcode_macro SET_ACTIVE_SPOOL]
gcode:
    {% if params.ID is defined %}
        {action_call_remote_method("spoolman_set_active_spool", spool_id=params.ID|int)}
    {% else %}
        {action_respond_info("Parameter 'ID' is required")}
    {% endif %}

[gcode_macro CLEAR_ACTIVE_SPOOL]
gcode:
    {action_call_remote_method("spoolman_set_active_spool", spool_id=None)}

# Tool macros with per-tool spool tracking
[gcode_macro T0]
variable_active: False
variable_spool_id: None
gcode:
    {% if printer["gcode_macro T0"].spool_id is defined and
          printer["gcode_macro T0"].spool_id not in [None, "None", ""] %}
        SET_ACTIVE_SPOOL ID={printer["gcode_macro T0"].spool_id}
    {% else %}
        CLEAR_ACTIVE_SPOOL
    {% endif %}
    CHANGE_TOOL TOOL=0

[gcode_macro T1]
variable_active: False
variable_spool_id: None
gcode:
    {% if printer["gcode_macro T1"].spool_id is defined and
          printer["gcode_macro T1"].spool_id not in [None, "None", ""] %}
        SET_ACTIVE_SPOOL ID={printer["gcode_macro T1"].spool_id}
    {% else %}
        CLEAR_ACTIVE_SPOOL
    {% endif %}
    CHANGE_TOOL TOOL=1

[gcode_macro T2]
variable_active: False
variable_spool_id: None
gcode:
    {% if printer["gcode_macro T2"].spool_id is defined and
          printer["gcode_macro T2"].spool_id not in [None, "None", ""] %}
        SET_ACTIVE_SPOOL ID={printer["gcode_macro T2"].spool_id}
    {% else %}
        CLEAR_ACTIVE_SPOOL
    {% endif %}
    CHANGE_TOOL TOOL=2

[gcode_macro T3]
variable_active: False
variable_spool_id: None
gcode:
    {% if printer["gcode_macro T3"].spool_id is defined and
          printer["gcode_macro T3"].spool_id not in [None, "None", ""] %}
        SET_ACTIVE_SPOOL ID={printer["gcode_macro T3"].spool_id}
    {% else %}
        CLEAR_ACTIVE_SPOOL
    {% endif %}
    CHANGE_TOOL TOOL=3

[gcode_macro T4]
variable_active: False
variable_spool_id: None
gcode:
    {% if printer["gcode_macro T4"].spool_id is defined and
          printer["gcode_macro T4"].spool_id not in [None, "None", ""] %}
        SET_ACTIVE_SPOOL ID={printer["gcode_macro T4"].spool_id}
    {% else %}
        CLEAR_ACTIVE_SPOOL
    {% endif %}
    CHANGE_TOOL TOOL=4

[gcode_macro T5]
variable_active: False
variable_spool_id: None
gcode:
    {% if printer["gcode_macro T5"].spool_id is defined and
          printer["gcode_macro T5"].spool_id not in [None, "None", ""] %}
        SET_ACTIVE_SPOOL ID={printer["gcode_macro T5"].spool_id}
    {% else %}
        CLEAR_ACTIVE_SPOOL
    {% endif %}
    CHANGE_TOOL TOOL=5

[delayed_gcode RESTORE_SELECTED_SPOOLS]
initial_duration: 0.1
gcode:
  {% set svv = printer.save_variables.variables %}
  {% for object in printer %}
    {% if object.startswith('gcode_macro ') and printer[object].spool_id is defined %}
      {% set macro = object.replace('gcode_macro ', '') %}
      {% set var = (macro + '__SPOOL_ID')|lower %}
      {% if svv[var] is defined %}
        SET_GCODE_VARIABLE MACRO={macro} VARIABLE=spool_id VALUE={svv[var]}
      {% endif %}
    {% endif %}
  {% endfor %}
