hatchna/INDX/macros/indx-tc-macros.cfg

#####################################################################
#  INDX TOOLCHANGE MACROS & HARDWARE CONSTANTS
#####################################################################
#
#  CREDIT / ATTRIBUTION:
#  Base Toolchange Architecture: Bondtech INDX (https://github.com/BondtechAB/INDX)
#
#  Borrowed / Adapted from 3DPrintDemon (https://github.com/3DPrintDemon/DEMON_INDX):
#  - Stepper driver detection & TMC current management (_RESTORE_EXTRUDER_CURRENT, _SET_MODE)
#  - Return to the print XY before dropping Z after a pickup (_RESTORE_GRABBER, _LINEAR_EXIT)
#  - Heat during the dock exit and extrude to confirm the lock (_PICKUP_GRAB, _PICKUP_LOCKER)
#
#  Borrowed / Adapted from Charlie Mayall (https://github.com/charliemayall/INDX):
#  - homing_busy coordination in _TOOLCHANGE_VARS to prevent recursive G28 calls
#  - Z-hop coordination across tool changes
#
#  Modifications by Nathan Hatch (hatchna):
#  - Multi-tool (6 tools) kinematic coordinate tracking and Spoolman integration
#
#  These values are fixed by the INDX mechanism geometry and gear
#  mesh. DO NOT MODIFY unless you are changing the physical hardware.
#
#  Per-tool positions are derived as:
#     trigger_y   = tool.dock_y - TOOL_POSITIONS.dock_dir * trigger_offset
#     clearance_y = TOOL_POSITIONS.clearance_y                   (set in indx.cfg)
#
#####################################################################

[gcode_macro _INDX_CONSTANTS]
description: Fixed INDX hardware constants — do not modify

# --- Dock geometry ---
# Distance for the gentle peel-off after parking/pickup (relative move)
variable_peel_distance: 10.0

# --- Unlock dance: Y depths toward the dock from trigger_y ---
# These define the waypoints of the wiggle sequence.
# Expressed as positive distances along dock_dir from trigger_y.
variable_squeeze_depth: 0.5
variable_wiggle_in_depth: 1.0
variable_wiggle_out_depth: 2.0

# --- Unlock dance: E-axis moves (gear mesh — do not change) ---
variable_squeeze_e: -0.27
variable_wiggle_in_e: 0.27
variable_wiggle_out_e: -1.7
variable_full_open_e: -11.0
variable_full_lock_e: 11.0

# --- Feed rates (mm/min) ---
variable_squeeze_feedrate: 2000
variable_wiggle_feedrate: 2500
variable_dock_feedrate: 3000
variable_latch_feedrate: 1500
variable_peel_feedrate: 3000
variable_engage_feedrate: 2500

# --- Extruder current (amps) ---
variable_squeeze_current: 0.2
variable_run_current: 0.6

# --- E-axis rotation distance for TC moves ---
# All E moves in the macros use this value regardless of what is set in printer.cfg.
# printer.cfg rotation_distance is restored after every macro that issues E moves.
variable_tc_rotation_distance: 5.7

gcode:

#####################################################################
#  1. GLOBAL VARIABLES & STATUS DASHBOARD
#####################################################################

[gcode_macro _TOOLCHANGE_VARS]
variable_mode: "normal"
variable_accel_mult: 0.7
variable_speed_mult: 0.7
variable_toolhead_state: 0 # 0=Locked, 2=Open
variable_rotation_dist_overridden: 0
# Set by [homing_override] so CHANGE_TOOL/PARK_TOOL do not re-enter G28 mid-home.
variable_homing_busy: 0
# XY where the tool change was issued, set by _RESTORE_GRABBER. _LINEAR_EXIT
# returns here before dropping Z, so the nozzle never descends over the part
# away from where it left it.
variable_restore_x: 0.0
variable_restore_y: 0.0
gcode:

[delayed_gcode INIT_STATE]
initial_duration: 5.0
# A delayed_gcode template renders when its timer fires, then waits for any
# command already running. A G28/PARK_TOOL sent in the first seconds after a
# restart would finish first, and the restore below would then write back the
# active_tool and latch state from before that command (a parked tool claimed
# as still on the head, heated by the next print). The restore is its own
# macro, so it renders when it actually runs and reads the state as it is.
gcode:
    _INDX_INIT_STATE_APPLY

[gcode_macro _INDX_INIT_STATE_APPLY]
description: Inner - restore the saved latch state, speed mode and active tool after a restart (called by INIT_STATE)
gcode:
    _INDX_BUILD_TOOLS

    {% set svv = printer.save_variables.variables %}
    # Restore saved latch state so INDX displays the correct Open/Locked label after a
    # firmware restart. The INDX latch is mechanically self-retaining, so the saved value
    # accurately reflects the physical position across restarts.
    # Defaults to 0 (Locked) on first boot before any toolchange has been recorded.
    SET_GCODE_VARIABLE MACRO=_TOOLCHANGE_VARS VARIABLE=toolhead_state VALUE={svv.toolhead_state|default(0)|int}

    MODE_{svv.tc_mode|default("NORMAL")|upper}
    # Show the saved tool on the Mainsail/Fluidd tool buttons
    _INDX_SET_ACTIVE_TOOL TOOL={svv.active_tool|default(-1)|int}
    TOOL_STATUS

[gcode_macro _INDX_BUILD_TOOLS]
description: Inner - build TOOL_POSITIONS.tools from the numbered tN_x / tN_dock_y variables
# INIT_STATE runs it 5 s after a restart. G28, CHANGE_TOOL and PARK_TOOL run
# it first when the list is still empty, so a command in those first seconds
# does not fail half way (a G28 used to die in the T0 fetch with Z still
# marked homed at the hop height, PR #58). The macros that index the list
# render after this one has run.
gcode:
    {% set tp = printer["gcode_macro TOOL_POSITIONS"] %}
    {% set ns = namespace(json="") %}
    {% for i in range(tp.tool_count|int) %}
        {% set x  = tp["t" ~ i ~ "_x"]|float %}
        {% set dy = tp["t" ~ i ~ "_dock_y"]|float %}
        {% set entry = '{"x": %.3f, "dock_y": %.3f}' % (x, dy) %}
        {% if loop.first %}
            {% set ns.json = "[" ~ entry %}
        {% else %}
            {% set ns.json = ns.json ~ ", " ~ entry %}
        {% endif %}
    {% endfor %}
    SET_GCODE_VARIABLE MACRO=TOOL_POSITIONS VARIABLE=tools VALUE='{ns.json}]'

[gcode_macro _INDX_CHECK_CLEARANCE]
description: Inner - refuse to home or change tools if clearance_y is closer than min_dock_clearance to the most protruding dock
# A tool on the head needs 25 mm from the most protruding dock, on the side
# away from the docks; min_dock_clearance adds 1 mm margin. Every dock exit,
# the travel between docks and the X home run along clearance_y, so a line
# that is too close (for example after a dock re-measure) drives a tool on
# the head into the docked tools. Reads tN_dock_y directly, so it also works
# before INIT_STATE has built the tools list.
variable_min_dock_clearance: 26.0
gcode:
    {% set tp = printer["gcode_macro TOOL_POSITIONS"] %}
    {% set ns = namespace(gap=999.0, tool=-1) %}
    {% for i in range(tp.tool_count|int) %}
        {% set gap = (tp["t" ~ i ~ "_dock_y"]|float - tp.clearance_y|float) * tp.dock_dir|float %}
        {% if gap < ns.gap %}
            {% set ns.gap = gap %}
            {% set ns.tool = i %}
        {% endif %}
    {% endfor %}
    {% if ns.gap < min_dock_clearance|float - 0.001 %}
        _INDX_LCD LEVEL=warn MSG="clearance_y too close to T{ns.tool} dock"
        _INDX_RAISE MSG="{'INDX: clearance_y %.3f is only %.2f mm from the T%d dock (dock_y %.3f); it must be at least %.1f mm. Fix clearance_y in indx.cfg before any homing or tool change.' % (tp.clearance_y|float, ns.gap, ns.tool, tp['t' ~ ns.tool ~ '_dock_y']|float, min_dock_clearance|float)}"
    {% endif %}

[gcode_macro _INDX_LCD]
description: Show an INDX alert on the printer display (M117). LEVEL=warn: dangerous to ignore; LEVEL=action: you need to do something. Everything else stays in the console only
# The display line is short (about 40 characters); the console keeps the
# full explanation. An alert clears itself after the next successful G28
# (_INDX_LCD_CLEAR), and only if INDX put it there, so the slicer's own M117
# messages are left alone.
variable_shown: 0
gcode:
    {% set lvl = params.LEVEL|default("action")|lower %}
    M117 {"! " if lvl == "warn" else "> "}{params.MSG|default("INDX: see console")}
    SET_GCODE_VARIABLE MACRO=_INDX_LCD VARIABLE=shown VALUE=1

[gcode_macro _INDX_LCD_CLEAR]
description: Inner - clear the display line if it shows an INDX alert
gcode:
    {% if printer["gcode_macro _INDX_LCD"].shown|int %}
        M117
        SET_GCODE_VARIABLE MACRO=_INDX_LCD VARIABLE=shown VALUE=0
    {% endif %}

[gcode_macro _INDX_RAISE]
description: Inner - raise an error from its own macro, so the commands before it (heater off, messages) still run; inside G28 it first undoes the provisional Z home
# A raise inside G28 (for example a failed T0 pickup in the homing T0 fetch)
# must leave the machine as _INDX_HOME_Z_FAIL would: homing_busy cleared, and
# Z not homed if it was only marked homed at the hop height (z_faked).
# Otherwise Z reports homed at a made-up origin (PR #58 / #71).
# The raise itself is a separate macro: a template raises while it renders,
# before any of its own commands run.
gcode:
    {% if printer["gcode_macro _TOOLCHANGE_VARS"].homing_busy|default(0)|int %}
        SET_GCODE_VARIABLE MACRO=_TOOLCHANGE_VARS VARIABLE=homing_busy VALUE=0
        {% if printer["gcode_macro _INDX_HOME_Z"].z_faked|default(0)|int %}
            SET_KINEMATIC_POSITION SET_HOMED= CLEAR_HOMED=Z
            SET_GCODE_VARIABLE MACRO=_INDX_HOME_Z VARIABLE=z_faked VALUE=0
            RESPOND TYPE=error MSG="INDX: homing stopped, Z is not homed"
        {% endif %}
    {% endif %}
    _INDX_RAISE_NOW MSG="{params.MSG|default('INDX error')}"

[gcode_macro _INDX_RAISE_NOW]
description: Inner - raise the error (called by _INDX_RAISE)
gcode:
    { action_raise_error(params.MSG|default("INDX error")) }

[gcode_macro M104]
description: Set the hotend temperature; a T for a tool that is not on the head is ignored, and a tool in no_heat_tools or an empty head is never heated
# Slicers set every tool's temperature with M104 T<n> (PrusaSlicer at the
# second layer when it differs from the first, and with ooze prevention).
# INDX has one heater, on the head, and Klipper rejects T<n> for an extruder
# it does not have, which stops the print. The temperature of a parked tool
# comes from CHANGE_TOOL TEMP= when it is picked up.
# If your own config also defines M104 or M109, only the last one loaded is
# used: merge these rules into yours.
rename_existing: M99104
gcode:
    {% set act = printer.save_variables.variables.active_tool|default(-1)|int %}
    {% set no_heat = act in printer["gcode_macro TOOL_POSITIONS"].no_heat_tools|default([]) %}
    {% if params.T is defined and params.T|int != act %}
        # not on the head: nothing to heat
    {% elif act < 0 and params.S|default(0)|float > 0 %}
        RESPOND MSG="M104 S{params.S}: no tool on the head, not heating (INDX heats each tool at pickup)"
    {% elif no_heat and params.S|default(0)|float > 0 %}
        # A tool with no hotend (no_heat_tools) is never heated
        RESPOND MSG="M104 S{params.S}: T{act} has no hotend (no_heat_tools), not heating"
        M99104 S0
    {% else %}
        M99104 S{params.S|default(0)}
    {% endif %}

[gcode_macro M109]
description: Set the hotend temperature and wait to within 5 C; skipped with no tool on the head or for a tool in no_heat_tools (nothing to heat, and the wait would never end)
rename_existing: M99109
gcode:
    {% set s = params.S|default(0)|float %}
    {% set act = printer.save_variables.variables.active_tool|default(-1)|int %}
    {% if params.T is defined and params.T|int != act %}
        # not on the head: nothing to heat
    {% elif act < 0 and s > 0 %}
        RESPOND MSG="M109 S{s}: no tool on the head, not heating (INDX heats each tool at pickup)"
    {% elif s > 0 and act in printer["gcode_macro TOOL_POSITIONS"].no_heat_tools|default([]) %}
        # A tool with no hotend (no_heat_tools) is never heated, and there is nothing to wait for
        RESPOND MSG="M109 S{s}: T{act} has no hotend (no_heat_tools), not heating"
        M104 S0
    {% else %}
        M104 S{s}
        {% if s > 0 %}
            TEMPERATURE_WAIT SENSOR=extruder MINIMUM={s - 5} MAXIMUM={s + 5}
        {% endif %}
    {% endif %}

[gcode_macro TOOL_STATUS]
gcode:
    {% set svv = printer.save_variables.variables %}
    {% set tp = printer["gcode_macro TOOL_POSITIONS"] %}
    {% set st = printer["gcode_macro _TOOLCHANGE_VARS"].toolhead_state|int %}
    {% set mode = printer["gcode_macro _TOOLCHANGE_VARS"].mode|upper %}
    {% set state_label = "🔒 LOCKED" if st == 0 else "🔓 OPEN" %}
    # LOCK STATE and ACTIVE TOOL are saved state: they say what the last macro
    # to run claimed, not what is physically on the head. The load cell is the
    # only thing that knows. Show it here so the two can be compared, since
    # homing refuses on the cell reading and not on either variable above.
    {% set min_g = printer["gcode_macro TOOL_POSITIONS"].home_min_force_g|default(800.0)|float %}
    {% set lc = printer.load_cell_probe if "load_cell_probe" in printer else none %}
    {% set fg = lc.force_g|default(none) if lc is not none else none %}
    # Counted from the empty-head calibration (reference_tare_counts), not the
    # last tare: a probe or tap tares with the tool on the head
    {% set cfgl = printer.configfile.settings.load_cell_probe|default({}) %}
    {% set ref = cfgl.reference_tare_counts|default(none) %}
    {% if fg is not none and ref is not none and lc.tare_counts is defined and lc.counts_per_gram|default(0)|float > 0 %}
        {% if ref is not number %}{% set ref = ref|sum %}{% endif %}
        {% set inv = -1.0 if cfgl.sensor_orientation|default("normal") == "inverted" else 1.0 %}
        {% set fg = fg|float + inv * (lc.tare_counts|float - ref|float) / lc.counts_per_gram|float %}
    {% endif %}
    {% if lc is none %}
        {% set seat_label = "no [load_cell_probe]" %}
    {% elif not lc.is_calibrated|default(false) or fg is none %}
        {% set seat_label = "not calibrated" %}
    {% elif not printer["gcode_macro TOOL_POSITIONS"].home_check_seat|default(false) %}
        # The reading is worth showing either way, but without the seat check it
        # gates nothing, and calling it "empty" next to a working G28 reads as a
        # fault rather than a number.
        {% set seat_label = "%.0f g (seat check off)" % (fg|float) %}
    {% else %}
        {% set seat_label = "%.0f g (%s)" % (fg|float,
            "tool seated" if fg|float|abs >= min_g else "reads empty") %}
    {% endif %}
    RESPOND TYPE=COMMAND MSG="----------------------------------------"
    RESPOND TYPE=COMMAND MSG="  ⚙️ SPEED MODE:  {mode}"
    RESPOND TYPE=COMMAND MSG="  🔐 LOCK STATE:  {state_label}"
    RESPOND TYPE=COMMAND MSG="  ⚖️ SEAT FORCE:  {seat_label}"
    RESPOND TYPE=COMMAND MSG="  🔧 TOOLS:       {tp.tools|length} configured"
    RESPOND TYPE=COMMAND MSG="  📦 ACTIVE TOOL: {('T' ~ svv.active_tool if svv.active_tool|default(-1)|int >= 0 else 'NONE')}"
    RESPOND TYPE=COMMAND MSG="  🔄 TC COUNT:    {svv.toolchange_count|default(0)|int}"
    RESPOND TYPE=COMMAND MSG="----------------------------------------"
    RESPOND TYPE=COMMAND MSG="  🛠️ INDX STATUS"
    RESPOND TYPE=COMMAND MSG="----------------------------------------"

[gcode_macro INDX]
gcode: TOOL_STATUS

#####################################################################
#  2. SPEED & POWER MODES
#####################################################################

[gcode_macro _RESTORE_EXTRUDER_CURRENT]
description: Inner — restore extruder TMC current to the value configured in printer.cfg (called after toolchange and on mode switch)
gcode:
    {% set cfg = printer.configfile.settings %}
    {% set tmc_sections = ["tmc2240 extruder", "tmc2209 extruder", "tmc2130 extruder", "tmc5160 extruder"] %}
    {% set ns = namespace(current=none, found=false) %}
    {% for s in tmc_sections %}
        {% if s in cfg and not ns.found %}
            {% set ns.current = cfg[s].run_current %}
            {% set ns.found = true %}
        {% endif %}
    {% endfor %}
    {% if ns.found %}
        SET_TMC_CURRENT STEPPER=extruder CURRENT={ns.current}
    {% endif %}


[gcode_macro _TC_SET_ROTATION_DIST]
description: Inner — set extruder rotation_distance to the fixed TC value before any TC E moves
gcode:
    {% set c = printer["gcode_macro _INDX_CONSTANTS"] %}
    {% set target = c.tc_rotation_distance|float %}
    {% set configured = printer.configfile.settings.extruder.rotation_distance|float %}
    {% if (configured - target)|abs > 0.0001 %}
        SET_EXTRUDER_ROTATION_DISTANCE EXTRUDER=extruder DISTANCE={target}
        SET_GCODE_VARIABLE MACRO=_TOOLCHANGE_VARS VARIABLE=rotation_dist_overridden VALUE=1
    {% endif %}

[gcode_macro _TC_RESTORE_ROTATION_DIST]
description: Inner — restore extruder rotation_distance to the value configured in printer.cfg
gcode:
    {% if printer["gcode_macro _TOOLCHANGE_VARS"].rotation_dist_overridden %}
        SET_EXTRUDER_ROTATION_DISTANCE EXTRUDER=extruder DISTANCE={printer.configfile.settings.extruder.rotation_distance}
        SET_GCODE_VARIABLE MACRO=_TOOLCHANGE_VARS VARIABLE=rotation_dist_overridden VALUE=0
    {% endif %}

[gcode_macro _TC_LATCH_MOVE]
description: Inner — cold-capable latch move via INDX_EXTRUDER_MOVE. E=distance mm, F=feedrate mm/min, I=current amps (default run_current). Bypasses min_extrude_temp so tool changes run without heating the tool.
gcode:
    {% set e = params.E|float %}
    {% set f = params.F|default(1500)|float %}
    {% set i = params.I|default(printer["gcode_macro _INDX_CONSTANTS"].run_current)|float %}
    # INDX_EXTRUDER_MOVE drives the extruder stepper directly with the
    # min_extrude_temp check bypassed, and sets/restores TMC current around the
    # move. SPEED is in mm/s; the INDX constants use mm/min feedrates.
    INDX_EXTRUDER_MOVE DISTANCE={e} SPEED={f / 60.0} CURRENT={i}

[gcode_macro _SET_MODE]
gcode:
    # 1. Save local multipliers for toolchange _TC_G0 moves ONLY
    SET_GCODE_VARIABLE MACRO=_TOOLCHANGE_VARS VARIABLE=mode VALUE='"{params.M}"'
    SET_GCODE_VARIABLE MACRO=_TOOLCHANGE_VARS VARIABLE=accel_mult VALUE={params.A|float}
    SET_GCODE_VARIABLE MACRO=_TOOLCHANGE_VARS VARIABLE=speed_mult VALUE={params.S|float}

    # 2. Write Acoustic Modes to TMC Stepper Hardware (Global & Persistent)
    # 0 = StealthChop (Quiet/Hot), 1 = SpreadCycle (Loud/Powerful)
    # The field is driver specific: 2208/2209 use en_spreadcycle, while 2130/2240/5160
    # use en_pwm_mode with the inverted meaning (1 = StealthChop). Detected per stepper
    # so mixed driver and AWD (stepper_x1/y1) machines are all covered.
    {% set c = params.C|int %}
    {% set cfg = printer.configfile.settings %}
    {% set drivers = {"tmc2209": "en_spreadcycle", "tmc2208": "en_spreadcycle",
                      "tmc2240": "en_pwm_mode", "tmc2130": "en_pwm_mode",
                      "tmc5160": "en_pwm_mode"} %}
    {% set ns = namespace(found=false) %}
    {% for stepper in ["stepper_x", "stepper_x1", "stepper_y", "stepper_y1"] %}
        {% for prefix, field in drivers.items() %}
            {% if (prefix ~ " " ~ stepper) in cfg %}
                {% set ns.found = true %}
    SET_TMC_FIELD STEPPER={stepper} FIELD={field} VALUE={c if field == "en_spreadcycle" else 1 - c}
            {% endif %}
        {% endfor %}
    {% endfor %}
    {% if not ns.found %}
    RESPOND MSG="INDX: no supported XY TMC driver found, speed mode set without changing StealthChop/SpreadCycle"
    {% endif %}
    # Restore extruder current to printer.cfg value (ensures mode switch doesn't leave wrong current)
    _RESTORE_EXTRUDER_CURRENT

    # 3. Save to disk so the INIT_STATE macro restores it on reboot
    SAVE_VARIABLE VARIABLE=tc_mode VALUE='"{params.M}"'

[gcode_macro MODE_STEALTH]
gcode: _SET_MODE M=stealth A=0.2 S=0.2 C=0

[gcode_macro MODE_NORMAL]
gcode: _SET_MODE M=normal A=0.7 S=0.7 C=1

[gcode_macro MODE_SPORT]
gcode: _SET_MODE M=sport A=1.0 S=1.0 C=1

#####################################################################
#  3. DYNAMIC MOTION HELPERS
#####################################################################

[gcode_macro _TC_G0]
gcode:
    {% set v = printer["gcode_macro _TOOLCHANGE_VARS"] %}
    {% set final_f = (printer.configfile.settings.printer.max_velocity * 60 * v.speed_mult) %}
    G0 {% if 'X' in params %}X{params.X} {% endif %}{% if 'Y' in params %}Y{params.Y} {% endif %}{% if 'Z' in params %}Z{params.Z} {% endif %}F{params.F|default(final_f)|int}

[gcode_macro _LINEAR_EXIT]
gcode:
    {% set tp = printer["gcode_macro TOOL_POSITIONS"] %}
    {% set c = printer["gcode_macro _INDX_CONSTANTS"] %}
    {% set restore_z = params.RESTORE_Z|default(0)|float %}

    {% set clearance_y = tp.clearance_y %}

    # 1. Gentle peel off the docking pins (relative move)
    G91
    # Write this as 0 - (x). A bare minus straight after the opening brace is read
    # as Jinja whitespace control, which silently swallows the negation.
    G1 Y{0 - (tp.dock_dir * c.peel_distance)} F{c.peel_feedrate}

    # 2. High-speed sprint to the clearance line (absolute move), then drop Z.
    #    These are deliberately separate moves. Combining them descends Z while
    #    XY is still travelling back toward the print area, which drags the
    #    nozzle across the part.
    G90
    _TC_G0 Y={"%.3f"|format(clearance_y)}
    {% if restore_z > 0 %}
        M400
        # While printing, travel back to where the change was issued at the
        # raised height first, then drop Z there. With "tool change on wipe
        # tower" the nozzle then waits and heats over the tower.
        {% if printer.print_stats.state in ["printing", "paused"] %}
            {% set v = printer["gcode_macro _TOOLCHANGE_VARS"] %}
            _TC_G0 X={v.restore_x} Y={v.restore_y}
            M400
        {% endif %}
        _TC_G0 Z={restore_z}
    {% endif %}

#####################################################################
#  4. THE DECOUPLED DOCKING DANCE
#####################################################################

[gcode_macro _SYNC_UNLOCK_DANCE]
description: Wiggle unlock sequence. Requires DOCK_Y parameter.
gcode:
    {% set c = printer["gcode_macro _INDX_CONSTANTS"] %}
    {% set tp = printer["gcode_macro TOOL_POSITIONS"] %}
    {% set dock_y = params.DOCK_Y|float %}
    {% set trigger_y = dock_y - tp.dock_dir * tp.trigger_offset %}

    # Latch (E) moves run through INDX_EXTRUDER_MOVE so they work cold, with no
    # need to heat the tool. INDX_EXTRUDER_MOVE is E-only and waits for motion
    # before/after, so each latch nudge is done first, then the paired Y
    # approach move.
    _TC_SET_ROTATION_DIST
    G90

    # 1. Squeeze release (soft current)
    _TC_LATCH_MOVE E={c.squeeze_e} F={c.squeeze_feedrate} I={c.squeeze_current}
    G1 Y{"%.3f"|format(trigger_y + tp.dock_dir * c.squeeze_depth)} F{c.squeeze_feedrate}

    # 2. Wiggle In → Wiggle Out → Dock (latch nudge first, then Y approach)
    _TC_LATCH_MOVE E={c.wiggle_in_e} F={c.squeeze_feedrate} I={c.run_current}
    G1 Y{"%.3f"|format(trigger_y + tp.dock_dir * c.wiggle_in_depth)} F{c.squeeze_feedrate}
    _TC_LATCH_MOVE E={c.wiggle_out_e} F={c.wiggle_feedrate} I={c.run_current}
    G1 Y{"%.3f"|format(trigger_y + tp.dock_dir * c.wiggle_out_depth)} F{c.wiggle_feedrate}
    G1 Y{"%.3f"|format(dock_y)} F{c.dock_feedrate}

    # 3. Final stationary open
    M400
    _TC_LATCH_MOVE E={c.full_open_e} F={c.latch_feedrate} I={c.run_current}
    _TC_RESTORE_ROTATION_DIST

#####################################################################
#  5. THE ORCHESTRATION MACROS
#####################################################################

[gcode_macro _INDX_CHECK_DOCKS]
description: Inner - refuse to drive into a dock before the dock positions are calibrated (TOOL_POSITIONS docks_calibrated)
# A missing setting counts as calibrated, so existing installs that keep
# their own indx.cfg are not affected.
gcode:
    {% if not printer["gcode_macro TOOL_POSITIONS"].docks_calibrated|default(True) %}
        {% if params.FOR|default("") == "home" %}
            {% set msg = "INDX: the dock positions are not calibrated yet (docks_calibrated: False in indx.cfg), so G28 will not fetch T0 from its dock. Put T0 on the head by hand and run MANUAL_TOOL_SEAT TOOL=0, then G28. Once every dock is measured, set docks_calibrated: True and RESTART." %}
        {% else %}
            {% set msg = "INDX: the dock positions are not calibrated yet (docks_calibrated: False in indx.cfg), so tool changes and parking are refused. Measure every dock first, then set docks_calibrated: True and RESTART." %}
        {% endif %}
        _INDX_LCD LEVEL=action MSG="Docks not calibrated yet"
        _INDX_RAISE MSG="{msg}"
    {% endif %}

[gcode_macro _INDX_CHECK_SUSPECT]
description: Inner - refuse to move while a failed pickup may have left a tool half seated on the head (saved variable seat_suspect)
# _PICKUP_SEAT_FAIL sets seat_suspect to the tool number when the load cell
# read more than an empty head but less than a seated tool. Until someone has
# looked at the head, any move could drive a loose tool into a dock or probe
# Z with it, so G28 Z, CHANGE_TOOL and PARK_TOOL refuse. It is a saved
# variable, so it survives a restart. MANUAL_TOOL_REMOVE, MANUAL_TOOL_SEAT
# and MANUAL_TOOLHEAD_RESET clear it.
gcode:
    {% set t = printer.save_variables.variables.seat_suspect|default(-1)|int %}
    {% if t >= 0 %}
        _INDX_LCD LEVEL=warn MSG="T{t} may be on the head"
        _INDX_RAISE MSG="T{t} may be half seated on the head. Check the head by hand, then run MANUAL_TOOL_REMOVE (take it off) or MANUAL_TOOL_SEAT TOOL={t} (it is fully on)."
    {% endif %}

[gcode_macro CHANGE_TOOL]
gcode:
    {% if 'TOOL' not in params %}
        {action_raise_error("CHANGE_TOOL requires TOOL=<n> (or use T0/T1/...).")}
    {% endif %}
    _INDX_CHECK_DOCKS
    _INDX_CHECK_CLEARANCE
    _INDX_CHECK_SUSPECT
    {% set t = params.TOOL|int %}
        {% set tp = printer["gcode_macro TOOL_POSITIONS"] %}

        # If INIT_STATE hasn't fired yet, build the tools list now
        {% if tp.tools|length == 0 %}
            _INDX_BUILD_TOOLS
        {% endif %}

        # Bounds check
        {% if t < 0 or t >= tp.tool_count|int %}
            {action_raise_error("T%d is not configured. %d tools available (T0–T%d)."
                % (t, tp.tool_count|int, tp.tool_count|int - 1))}
        {% endif %}

    # Home before the swap is planned, not inside it. Homing fetches T0 so it
    # can probe Z, which changes active_tool - and this template has already
    # rendered by then, so anything it decided from the old value is wrong.
    # _CHANGE_TOOL_APPLY renders when it is reached, after any homing has
    # finished, so it sees the tool that is actually on the head.
    {% set busy = printer["gcode_macro _TOOLCHANGE_VARS"].homing_busy|default(0)|int %}
    {% if not busy and "xyz" not in printer.toolhead.homed_axes %}
        G28
    {% endif %}
    _CHANGE_TOOL_APPLY TOOL={t} TEMP={params.TEMP|default(-1)} SKIP_Z_CORRECTION={params.SKIP_Z_CORRECTION|default(0)|int}

[gcode_macro _CHANGE_TOOL_APPLY]
description: Inner - perform the swap. Split from CHANGE_TOOL so active_tool is read after any homing has run, not before.
gcode:
    {% set t = params.TOOL|int %}
    {% set tp = printer["gcode_macro TOOL_POSITIONS"] %}
    {% set act = printer.save_variables.variables.active_tool|default(-1)|int %}
    {% if act != t %}
        # 1. Save live slicer motion limits
        {% set live_vel = printer.toolhead.max_velocity %}
        {% set live_acc = printer.toolhead.max_accel %}

        # 2. Force Klipper to use raw printer.cfg maximums (scaled by TC mode)
        {% set max_v = printer.configfile.settings.printer.max_velocity %}
        {% set max_a = printer.configfile.settings.printer.max_accel %}
        {% set v = printer["gcode_macro _TOOLCHANGE_VARS"] %}
        SET_VELOCITY_LIMIT VELOCITY={max_v * v.speed_mult} ACCEL={max_a * v.accel_mult}

        # 3. Decide what the incoming tool should heat to. The heater stays
        #    on here: Klipper reads ahead, so print moves queued before this
        #    macro may still be extruding. The park turns it off once those
        #    moves have finished (PR #39).
        #    TEMP= is the incoming tool's own target and is what you want when
        #    the two tools run different materials. Without it all we have is
        #    the outgoing tool's target, which is right when both tools print
        #    at the same temperature and wrong when they don't.
        #    A slicer placeholder that resolves to nothing arrives as 0, which
        #    would silently print the rest of the job with the heater off, so
        #    treat anything at or below zero as "not supplied" and fall back.
        #    Tools listed in no_heat_tools carry no hotend, so they are never
        #    heated whatever the slicer asks for. Deciding that here rather
        #    than from a bare TEMP=0 keeps it out of the slicer's hands: the
        #    change filament G-code is one template for every tool and will
        #    happily pass a temperature for the pen as well.
        {% set no_heat = t in tp.no_heat_tools|default([]) %}
        {% set temp_param = params.TEMP|default(-1)|float %}
        {% set target_temp = 0.0 if no_heat
            else (temp_param if temp_param > 0 else printer.extruder.target|float) %}
        {% if act < 0 %}
            # Nothing on the head to park, so nothing is extruding
            M104 S0
        {% endif %}
        
        # 4. Z-Sync before moving
        {% set svv = printer.save_variables.variables %}
        {% if act >= 0 %}
            {% set live_total_z = printer.gcode_move.homing_origin.z|float %}
            {% set tool_z = svv["t" ~ act ~ "_offset_z"]|default(0.0)|float %}
            SAVE_VARIABLE VARIABLE=global_z_offset VALUE='{"%.3f"|format(live_total_z - tool_z)}'
        {% endif %}

        # 5. Z-hop is blocking by design: Z clears before any XY travel in
        #    PARK_TOOL, and drops only after the Y-clearance sprint in
        #    _LINEAR_EXIT. Running them together costs a little less time but
        #    drags the nozzle across the print at both ends of the change.
        {% set zhop = tp.z_hop|float %}
        {% set restore_z = "%.3f"|format(printer.gcode_move.gcode_position.z) %}
        _RESTORE_GRABBER

        # 6. Physical tool swap
        {% if act != -1 %}
            PARK_TOOL ZHOP={zhop}
        {% endif %}

        # Pass ZHOP only when there was no park (act==-1), since PARK_TOOL has
        # already cleared Z otherwise. RESTORE_Z drives the drop back down.
        M400
        _PICKUP_TOOL TOOL={t} TARGET={target_temp} ZHOP={0.0 if act != -1 else zhop} RESTORE_Z={restore_z} SKIP_Z_CORRECTION={params.SKIP_Z_CORRECTION|default(0)|int}

        # 8. Restore extruder current to printer.cfg value — toolchange moves use
        #    c.run_current internally; this ensures normal printing current is correct.
        _RESTORE_EXTRUDER_CURRENT

        # 9. Restore live slicer motion limits so the print resumes correctly
        SET_VELOCITY_LIMIT VELOCITY={live_vel} ACCEL={live_acc}
    {% endif %}

[gcode_macro PARK_TOOL]
description: Park the tool currently on the head back in its dock.
# Homing happens here rather than inside the park, for the same reason
# CHANGE_TOOL was split: homing fetches T0 to probe Z, so active_tool can
# change while this template has already rendered. _PARK_TOOL_APPLY renders
# when it is reached and reads the tool that is actually on the head.
#
# It is also what keeps _INDX_HOME_FETCH_T0 working: that calls the APPLY
# macro directly, so a park triggered by homing does not put PARK_TOOL on
# the stack twice.
gcode:
    _INDX_CHECK_DOCKS
    _INDX_CHECK_CLEARANCE
    _INDX_CHECK_SUSPECT
    {% if printer["gcode_macro TOOL_POSITIONS"].tools|length == 0 %}
        _INDX_BUILD_TOOLS
    {% endif %}
    {% set act = printer.save_variables.variables.active_tool|default(-1)|int %}
    {% if act != -1 %}
        {% set busy = printer["gcode_macro _TOOLCHANGE_VARS"].homing_busy|default(0)|int %}
        {% if not busy and "xyz" not in printer.toolhead.homed_axes %}
            G28
        {% endif %}
        _PARK_TOOL_APPLY ZHOP={params.ZHOP|default(0.0)|float}
    {% endif %}

[gcode_macro _PARK_TOOL_APPLY]
description: Inner - the park itself. Split from PARK_TOOL so active_tool is read after any homing has run.
# With seat_check_enabled the load cell is read with the tool still on the
# head and again after the exit: if it has not changed by park_min_change_g,
# the tool did not come off and the park stops (_INDX_PARK_CHECK). CHECK=0
# skips that, for the pickup retry, which parks a tool that may not be there.
gcode:
    {% set st = printer["gcode_macro _TOOLCHANGE_VARS"].toolhead_state|int %}
    {% set act = printer.save_variables.variables.active_tool|default(-1)|int %}
    {% set tp = printer["gcode_macro TOOL_POSITIONS"] %}
    {% set c = printer["gcode_macro _INDX_CONSTANTS"] %}
    {% set zhop = params.ZHOP|default(0.0)|float %}
    {% set check = params.CHECK|default(1)|int and tp.seat_check_enabled|default(True) %}
    {% if act != -1 %}
        # Resolve this tool's dock geometry
        {% set tool = tp.tools[act] %}
        {% set dock_y = tool.dock_y %}
        {% set trigger_y = dock_y - tp.dock_dir * tp.trigger_offset %}

        {% set clearance_y = tp.clearance_y %}

        # Outside a print (and outside G28's T0 fetch), raise a low toolhead
        # to Z20 before travelling to the dock.
        {% set busy = printer["gcode_macro _TOOLCHANGE_VARS"].homing_busy|default(0)|int %}
        {% if not busy and printer.print_stats.state not in ["printing", "paused"]
              and "z" in printer.toolhead.homed_axes and printer.toolhead.position.z < 20.0 %}
            G90
            G0 Z20 F3000
        {% endif %}

        # Z-hop first, as its own move. Combining it with the XY travel raises Z
        # gradually across that travel, so the nozzle is still at print height
        # when XY starts moving and drags across the part.
        {% set hop_z = printer.gcode_move.gcode_position.z + zhop %}
        G90
        SET_GCODE_OFFSET X=0.0 Y=0.0
        {% if zhop > 0 %}
            _TC_G0 Z={"%.3f"|format(hop_z)}
        {% endif %}
        # SAFETY: heater off before any dock approach. M400 first: it waits
        # for the print moves still queued (and the hop), so the heat is not
        # cut while the nozzle is still extruding. The nozzle is raised and
        # standing still at this point (PR #39).
        M400
        M104 S0
        _TC_G0 X={tool.x} Y={"%.3f"|format(clearance_y)}

        # High-speed sprint to trigger line
        _TC_G0 Y={"%.3f"|format(trigger_y)}
        {% if check %}
            # Load cell with the tool still seated, for the park check below
            M400
            G4 P250
            _INDX_LC_STORE VAR=seated
        {% endif %}
        
        {% if st == 0 %}
            _SYNC_UNLOCK_DANCE DOCK_Y={dock_y}
            SET_GCODE_VARIABLE MACRO=_TOOLCHANGE_VARS VARIABLE=toolhead_state VALUE=2
            SAVE_VARIABLE VARIABLE=toolhead_state VALUE=2
        {% else %}
            G1 Y{"%.3f"|format(dock_y)} F{c.dock_feedrate}
        {% endif %}

        M400
        _LINEAR_EXIT
        {% if check %}
            # Did the tool really leave the head? If not, this raises with the
            # tool kept as active_tool, before the head drives anywhere else.
            # The reading is a 0.5 s running average, so stand still for
            # longer than that first, or it still holds samples from before
            # the release. G4 only queues the dwell: the M400 after it is
            # what waits.
            G4 P600
            M400
            _INDX_LC_STORE VAR=now
            _INDX_PARK_CHECK TOOL={act}
        {% endif %}
        _INDX_SET_ACTIVE_TOOL TOOL=-1
    {% endif %}

[gcode_macro _PICKUP_TOOL]
description: Inner - pick up TOOL, check with the load cell that it is seated (one re-home and retry), then offsets, record and heat
# Every step is its own macro so each renders when it runs and sees what the
# step before it found. A failed seat check re-homes X/Y and tries once more.
# After that a print pauses and anything else stops (_PICKUP_SEAT_FAIL).
# With seat_check_enabled False, or no calibrated load cell, the check passes
# and this is the same pickup as before.
gcode:
    {% set rz = (" RESTORE_Z=" ~ params.RESTORE_Z) if params.RESTORE_Z|default("")|string|length else "" %}
    _PICKUP_GRAB TOOL={params.TOOL} ZHOP={params.ZHOP|default(0.0)} TARGET={params.TARGET|default(0)}{rz}
    _INDX_SEAT_CHECK TOOL={params.TOOL}
    _PICKUP_SEAT_RETRY TOOL={params.TOOL}{rz}
    _PICKUP_SEAT_FAIL TOOL={params.TOOL} TARGET={params.TARGET|default(0)} SKIP_Z_CORRECTION={params.SKIP_Z_CORRECTION|default(0)}
    _PICKUP_FINISH TOOL={params.TOOL} TARGET={params.TARGET|default(0)} SKIP_Z_CORRECTION={params.SKIP_Z_CORRECTION|default(0)}

[gcode_macro _PICKUP_GRAB]
description: Inner - the pickup moves (to the dock, open, engage, lock, exit). Only called by _PICKUP_TOOL and its retry, which check the seat and record the tool.
gcode:
    {% set t = params.TOOL|int %}
    {% set st = printer["gcode_macro _TOOLCHANGE_VARS"].toolhead_state|int %}
    {% set tp = printer["gcode_macro TOOL_POSITIONS"] %}
    {% set c = printer["gcode_macro _INDX_CONSTANTS"] %}
    {% set zhop = params.ZHOP|default(0.0)|float %}
    {% set restore_z = params.RESTORE_Z|default("")|string %}
    {% set check = tp.seat_check_enabled|default(True) %}

    # Resolve this tool's dock geometry
    {% set tool = tp.tools[t] %}
    {% set dock_y = tool.dock_y %}
    {% set trigger_y = dock_y - tp.dock_dir * tp.trigger_offset %}

    {% set clearance_y = tp.clearance_y %}

    # When act==-1 (no park), the hop happens here instead. Same rule as PARK_TOOL:
    # Z clears first as its own move, then XY travels.
    {% set hop_z = printer.gcode_move.gcode_position.z + zhop %}
    G90
    SET_GCODE_OFFSET X=0.0 Y=0.0
    {% if zhop > 0 %}
        _TC_G0 Z={"%.3f"|format(hop_z)}
        M400
    {% endif %}
    _TC_G0 X={tool.x} Y={"%.3f"|format(clearance_y)}

    # Sprint to trigger line
    _TC_G0 Y={"%.3f"|format(trigger_y)}
    {% if check %}
        # Empty-head load cell reading, seconds before the pickup. The seat
        # check measures against it, so load cell drift (about 40 g per degree
        # C) drops out.
        M400
        G4 P250
        _INDX_LC_STORE VAR=empty
    {% endif %}

    # Latch moves run through INDX_EXTRUDER_MOVE so pickup works on a cold tool
    # without heating it. INDX_EXTRUDER_MOVE moves are inherently relative.
    _TC_SET_ROTATION_DIST
    G90

    {% if st != 2 %}
        # Open latch (currently locked)
        _TC_LATCH_MOVE E={c.full_open_e} F={c.latch_feedrate} I={c.run_current}
        SET_GCODE_VARIABLE MACRO=_TOOLCHANGE_VARS VARIABLE=toolhead_state VALUE=2
        SAVE_VARIABLE VARIABLE=toolhead_state VALUE=2
    {% endif %}

    # Engagement slide to dock
    G1 Y{"%.3f"|format(dock_y)} F{c.engage_feedrate}

    # Lock the tool
    _TC_LATCH_MOVE E={c.full_lock_e} F={c.latch_feedrate} I={c.run_current}
    _TC_RESTORE_ROTATION_DIST

    SET_GCODE_VARIABLE MACRO=_TOOLCHANGE_VARS VARIABLE=toolhead_state VALUE=0
    SAVE_VARIABLE VARIABLE=toolhead_state VALUE=0

    # While printing, start heating as soon as the tool is locked, so it warms
    # during the exit. M99104 is the original M104: the new M104 only heats the
    # tool recorded as on the head, which happens after the seat check. A
    # failed seat check turns the heater off again.
    {% if params.TARGET|default(0)|float > 0 and printer.print_stats.state in ["printing", "paused"] %}
        M99104 S{params.TARGET|float}
    {% endif %}

    # Z hop-down is folded into _LINEAR_EXIT's Y-clearance sprint (non-blocking)
    _LINEAR_EXIT RESTORE_Z={restore_z}
    M400
    {% if check %}
        # Let the load cell settle, then read it for the seat check
        G4 P300
        M400
        _INDX_LC_STORE VAR=now
    {% endif %}

[gcode_macro _PICKUP_SEAT_RETRY]
description: Inner - seat check failed: re-home X/Y, park the tool in case it is on the head, pick it up again
# sport_dropped: this retry switched sport to normal; _PICKUP_FINISH shows
# the display alert after its own clear, so a good retry doesn't wipe it
variable_sport_dropped: 0
# A misread seat check must not drop a tool that is really on the head, so
# the retry parks it first: a tool on the head goes back into its dock, and
# with an empty head the park is the dock visit that resets the latch.
# An ambiguous reading (something may be on the head) gets no retry: the
# retry re-homes X/Y and parks without a check, with a tool hanging off the
# head. _PICKUP_SEAT_FAIL stops and asks instead.
gcode:
    {% set sc = printer["gcode_macro _INDX_SEAT_CHECK"] %}
    {% if not sc.ok|int and not sc.ambiguous|int %}
        {% set t = params.TOOL|int %}
        {% set tp = printer["gcode_macro TOOL_POSITIONS"] %}
        RESPOND TYPE=error MSG="T{t} did not seat (load cell {printer['gcode_macro _INDX_SEAT_CHECK'].force_g|round(0)|int} g against the empty head). Re-homing X/Y and trying once more."
        M104 S0
        # A pickup that needed a retry in sport mode drops to normal speed for
        # the retry and from then on, until the user picks sport again.
        {% if printer["gcode_macro _TOOLCHANGE_VARS"].mode|lower == "sport" %}
            MODE_NORMAL
            _TC_APPLY_MODE_LIMITS
            RESPOND TYPE=error MSG="INDX: switched from sport to normal tool change speed because T{t} needed a pickup retry. It stays normal, also after a restart, until you run MODE_SPORT again."
            _INDX_LCD LEVEL=action MSG="Sport mode off: MODE_SPORT to restore"
            SET_GCODE_VARIABLE MACRO=_PICKUP_SEAT_RETRY VARIABLE=sport_dropped VALUE=1
        {% endif %}
        # Over a print the X/Y home sweeps across it: lift z_hop first
        {% if "z" in printer.toolhead.homed_axes %}
            {% set z = [printer.toolhead.position.z|float + tp.z_hop|float, printer.toolhead.axis_maximum.z|float - 1]|min %}
            G90
            G1 Z{"%.3f"|format(z)} F900
        {% endif %}
        _INDX_REHOME_XY
        _INDX_SET_ACTIVE_TOOL TOOL={t}
        _PARK_TOOL_APPLY CHECK=0
        _PICKUP_GRAB TOOL={t}{(" RESTORE_Z=" ~ params.RESTORE_Z) if params.RESTORE_Z|default("")|string|length else ""}
        _INDX_SEAT_CHECK TOOL={t}
    {% endif %}

[gcode_macro _TC_APPLY_MODE_LIMITS]
description: Inner - set the tool change velocity and acceleration limits from the current speed mode (after a mode change in the middle of a tool change)
# _CHANGE_TOOL_APPLY sets these limits once, when the change starts, and puts
# the slicer's back when it ends. Its own macro, so it reads the mode after
# the switch.
gcode:
    {% set v = printer["gcode_macro _TOOLCHANGE_VARS"] %}
    SET_VELOCITY_LIMIT VELOCITY={printer.configfile.settings.printer.max_velocity * v.speed_mult} ACCEL={printer.configfile.settings.printer.max_accel * v.accel_mult}

[gcode_macro _INDX_REHOME_XY]
description: Inner - home X and Y again, from inside G28 too
# Inside the homing override G28 is Klipper's own homing, so the INDX steps
# around it (Y before X, X at the clearance line) are done here.
gcode:
    {% set tp = printer["gcode_macro TOOL_POSITIONS"] %}
    {% if printer["gcode_macro _TOOLCHANGE_VARS"].homing_busy|default(0)|int %}
        G28 Y
        G90
        G0 Y{"%.3f"|format(tp.clearance_y|float)} F{tp.home_travel_feedrate|default(3000)|int}
        G28 X
    {% else %}
        G28 X Y
    {% endif %}

[gcode_macro _PICKUP_SEAT_FAIL]
description: Inner - the pickup did not seat: pause a print, stop anything else, heater off. Clearly empty head: no tool recorded. Anything in between: the tool stays recorded
# Never assume the head is empty. A reading below seat_empty_max_g is an
# empty head and no tool is recorded. A reading between that and
# seat_min_force_g means something may be on the head, a half seated tool:
# the tool stays recorded and seat_suspect is saved, so G28 Z, CHANGE_TOOL
# and PARK_TOOL refuse until the head has been checked by hand
# (_INDX_CHECK_SUSPECT). The latch is left as it is.
# The print pauses with the base PAUSE, so nothing moves and nothing is
# retracted. The new tool's offsets are set first (MOVE=0), so the position
# the pause saves is in the coordinates the print continues in once the tool
# change has been redone by hand. Inside G28 (the T0 fetch of a print start)
# it stops instead: _INDX_RAISE also undoes the provisional Z home.
gcode:
    {% set sc = printer["gcode_macro _INDX_SEAT_CHECK"] %}
    {% if not sc.ok|int %}
        {% set t = params.TOOL|int %}
        {% set tp = printer["gcode_macro TOOL_POSITIONS"] %}
        {% set f = sc.force_g|round(0)|int %}
        {% set min_g = tp.seat_min_force_g|default(680.0)|float %}
        {% set ambiguous = sc.ambiguous|int %}
        {% if ambiguous %}
            {% set why = "T%d may be half seated on the head: the load cell reads %d g against the empty head, more than an empty head (under %d g) but less than a seated tool (%d g). T%d is kept as the tool on the head. Check it by hand" % (t, f, tp.seat_empty_max_g|default(230.0)|float, min_g, t) %}
            {% set lcd = "T%d may be on the head" % t %}
        {% else %}
            {% set why = "T%d did not seat after a re-home and a second try (load cell %d g against the empty head, a seated tool shows at least %d g). Check the T%d dock and the head" % (t, f, min_g, t) %}
            {% set lcd = "T%d pickup failed: check dock" % t %}
        {% endif %}
        M104 S0
        _INDX_SET_ACTIVE_TOOL TOOL={t if ambiguous else -1}
        {% set busy = printer["gcode_macro _TOOLCHANGE_VARS"].homing_busy|default(0)|int %}
        {% if printer.print_stats.state == "printing" and not busy %}
            {% set svv = printer.save_variables.variables %}
            {% set tool_z = svv["t" ~ t ~ "_offset_z"]|default(0.0)|float %}
            {% set global_z = svv.global_z_offset|default(0.0)|float %}
            {% set skip_z = params.SKIP_Z_CORRECTION|default(0)|int %}
            {% set apply_z = global_z if skip_z else (tool_z + global_z) %}
            SET_GCODE_OFFSET X={svv["t"~t~"_offset_x"]|default(0.0)} Y={svv["t"~t~"_offset_y"]|default(0.0)} Z='{"%.3f"|format(apply_z)}' MOVE=0
            {% set cmd = "CHANGE_TOOL TOOL=%d TEMP=%s%s" % (t, params.TARGET|default(0), " SKIP_Z_CORRECTION=1" if skip_z else "") %}
            _INDX_LCD LEVEL={'warn' if ambiguous else 'action'} MSG="{lcd}"
            {% if ambiguous %}
                RESPOND TYPE=error MSG="{why}, then MANUAL_TOOL_REMOVE (opens the latch: take the tool off and put it in its dock) or MANUAL_TOOL_SEAT TOOL={t} (it is fully on). Tool changes and G28 are refused until then. Print paused with the heater off. With the head empty, run {cmd}, then RESUME."
            {% else %}
                RESPOND TYPE=error MSG="{why}. Print paused with the heater off. Put T{t} back in its dock and leave the head empty (MANUAL_TOOL_REMOVE opens the latch), then run {cmd} and RESUME."
            {% endif %}
            {% if ambiguous %}
                # Last, so nothing in the retry or fail path runs into it
                SAVE_VARIABLE VARIABLE=seat_suspect VALUE={t}
            {% endif %}
            {% set pm = printer.configfile.settings["gcode_macro pause"] %}
            {pm.rename_existing if pm is defined and pm.rename_existing is defined else "PAUSE"}
        {% else %}
            _INDX_LCD LEVEL={'warn' if ambiguous else 'action'} MSG="{lcd}"
            {% if ambiguous %}
                RESPOND TYPE=error MSG="{why}, then MANUAL_TOOL_REMOVE (opens the latch: take the tool off and put it in its dock) or MANUAL_TOOL_SEAT TOOL={t} (it is fully on). Tool changes and G28 are refused until then. Stopped with the heater off."
            {% else %}
                RESPOND TYPE=error MSG="{why}. Stopped with the heater off. If T{t} is on the head, run MANUAL_TOOL_SEAT TOOL={t} to claim it, or MANUAL_TOOL_REMOVE and put it back in its dock, then try again."
            {% endif %}
            {% if ambiguous %}
                # Last, so nothing in the retry or fail path runs into it
                SAVE_VARIABLE VARIABLE=seat_suspect VALUE={t}
            {% endif %}
            _INDX_RAISE MSG="T{t} pickup failed: {'may be on the head' if ambiguous else 'not seated'}, see above"
        {% endif %}
    {% endif %}

[gcode_macro _PICKUP_FINISH]
description: Inner - seated: apply offsets and filament, record the tool, heat
gcode:
    {% if printer["gcode_macro _INDX_SEAT_CHECK"].ok|int %}
    {% set t = params.TOOL|int %}

    # Apply new tool offsets.
    # Z = tool_z + global_z so the toolhead lands at the correct first-layer height.
    # The babystep widget reflects this combined value; ADJUST_GLOBAL_Z/SYNC_GLOBAL_Z
    # strip the tool_z component to expose the pure global adjustment.
    {% set svv = printer.save_variables.variables %}
    {% set tool_z = svv["t" ~ t ~ "_offset_z"]|default(0.0)|float %}
    {% set global_z = svv.global_z_offset|default(0.0)|float %}
    {% set skip_z = params.SKIP_Z_CORRECTION|default(0)|int %}
    {% set apply_z = global_z if skip_z else (tool_z + global_z) %}
    SET_GCODE_OFFSET X={svv["t"~t~"_offset_x"]|default(0.0)} Y={svv["t"~t~"_offset_y"]|default(0.0)} Z='{"%.3f"|format(apply_z)}' MOVE=1

    # Restore the filament this tool was last loaded with, so the safety model
    # matches what is actually about to be extruded. Without this the model keeps
    # whatever material was loaded last on any tool, which on a multi-material
    # print is the wrong filament for most of the job.
    _APPLY_TOOL_FILAMENT TOOL={t}

    # Spoolman integration: switch active spool to this tool's assigned spool
    {% set macro_name = "gcode_macro T" ~ t %}
    {% if macro_name in printer and printer[macro_name].spool_id is defined and
          printer[macro_name].spool_id not in [None, "None", ""] %}
        SET_ACTIVE_SPOOL ID={printer[macro_name].spool_id}
    {% elif 'gcode_macro CLEAR_ACTIVE_SPOOL' in printer %}
        CLEAR_ACTIVE_SPOOL
    {% endif %}

    # Record the tool now that the pickup is physically complete. Before the
    # heating below: M104/M109 only heat the tool recorded as on the head.
    _RECORD_TOOLCHANGE TOOL={t}
    _INDX_LCD_CLEAR
    {% if printer["gcode_macro _PICKUP_SEAT_RETRY"].sport_dropped|int %}
        _INDX_LCD LEVEL=action MSG="Sport mode off: MODE_SPORT to restore"
        SET_GCODE_VARIABLE MACRO=_PICKUP_SEAT_RETRY VARIABLE=sport_dropped VALUE=0
    {% endif %}

    # Start heating only after tool is fully locked, exited dock, and offsets applied.
    # M109 rather than M104: the tool was parked cold and the heater was off for the
    # whole swap, so returning here without waiting lets the print resume and extrude
    # into a cold nozzle. TARGET is only set when the extruder had one, so cold
    # calibration pickups skip this entirely.
    # A target at or below min_extrude_temp + 10 is raised to that, so
    # _PICKUP_LOCKER can extrude.
    {% set met = printer.configfile.settings.extruder.min_extrude_temp|float %}
    {% set target_temp = params.TARGET|default(0)|float %}
    {% if target_temp > 0 %}
        M109 S{[target_temp, met + 10]|max}
    {% endif %}

    _PICKUP_LOCKER
    {% endif %}

#####################################################################
#  PICKUP HELPERS
#####################################################################
#
#  CREDIT / ATTRIBUTION:
#  Author / Source: 3DPrintDemon (https://github.com/3DPrintDemon/DEMON_INDX)
#  Description: Helper macros for lock confirmation and position
#               tracking (_PICKUP_LOCKER, _RESTORE_GRABBER).
#
#####################################################################

[gcode_macro _PICKUP_LOCKER]
description: Inner - outside a print, extrude 1 mm on a hot nozzle to confirm the tool is locked
gcode:
    {% set v = printer["gcode_macro _TOOLCHANGE_VARS"] %}
    {% set final_f = (printer.configfile.settings.printer.max_velocity * 60 * v.speed_mult) %}
    {% set met = printer.configfile.settings.extruder.min_extrude_temp|float %}

    {% if printer.print_stats.state != "printing" %}
        {% if printer.extruder.temperature >= met %}
            M83
            G1 E1 F{final_f}
            G92 E0
            RESPOND TYPE=COMMAND MSG="TOOL LOCKED!"
        {% endif %}
    {% endif %}

[gcode_macro _RESTORE_GRABBER]
description: Inner - remember the XY where the tool change was issued (see _LINEAR_EXIT)
gcode:
    SET_GCODE_VARIABLE MACRO=_TOOLCHANGE_VARS VARIABLE=restore_x VALUE={"%.3f"|format(printer.gcode_move.gcode_position.x)}
    SET_GCODE_VARIABLE MACRO=_TOOLCHANGE_VARS VARIABLE=restore_y VALUE={"%.3f"|format(printer.gcode_move.gcode_position.y)}

[gcode_macro _INDX_LC_STORE]
description: Inner - store the load cell reading as VAR=empty (head empty, before a pickup), seated (before a park) or now (the reading a check compares)
# The reading counts from the empty-head calibration in printer.cfg
# (reference_tare_counts), not from the last tare. The checks only compare
# two readings taken standing still seconds apart, so the load cell's thermal
# drift (about 40 g per degree C, hundreds of grams over a day) drops out.
# No calibrated load cell: the reading is marked invalid and the checks are
# skipped, with one console line per restart.
variable_empty_g: 0.0
variable_empty_valid: 0
variable_seated_g: 0.0
variable_seated_valid: 0
variable_now_g: 0.0
variable_now_valid: 0
variable_skip_said: 0
gcode:
    {% set var = params.VAR|lower %}
    {% set lc = printer.load_cell_probe if "load_cell_probe" in printer else {} %}
    {% set cfgl = printer.configfile.settings.load_cell_probe|default({}) %}
    {% set ref = cfgl.reference_tare_counts|default(none) %}
    {% if ref is not none and lc.is_calibrated|default(false)
          and lc.counts_per_gram|default(0)|float > 0
          and lc.tare_counts is defined and lc.force_g|default(none) is not none %}
        {% if ref is not number %}{% set ref = ref|sum %}{% endif %}
        {% set inv = -1.0 if cfgl.sensor_orientation|default("normal") == "inverted" else 1.0 %}
        {% set g = lc.force_g|float + inv * (lc.tare_counts|float - ref|float) / lc.counts_per_gram|float %}
        SET_GCODE_VARIABLE MACRO=_INDX_LC_STORE VARIABLE={var}_g VALUE={g}
        SET_GCODE_VARIABLE MACRO=_INDX_LC_STORE VARIABLE={var}_valid VALUE=1
    {% else %}
        SET_GCODE_VARIABLE MACRO=_INDX_LC_STORE VARIABLE={var}_valid VALUE=0
        {% if not printer["gcode_macro _INDX_LC_STORE"].skip_said|int %}
            SET_GCODE_VARIABLE MACRO=_INDX_LC_STORE VARIABLE=skip_said VALUE=1
            RESPOND TYPE=error MSG="INDX: pickup and park checks skipped, the load cell is not calibrated. Run CALIBRATE_LOAD_CELL (see Load cell calibration in the README), or set seat_check_enabled: False in indx.cfg."
        {% endif %}
    {% endif %}

[gcode_macro _INDX_SEAT_CHECK]
description: Inner - end of a pickup: does the load cell see a tool on the head? Stores ok and force_g
# Compares the reading after the pickup with the empty-head reading taken at
# the trigger line just before it. A seated tool adds its latch spring
# preload (1100 to 1900 g on the test machine), an empty head stays near
# zero. Without this a missed pickup leaves active_tool set on an empty head.
# Threshold: seat_min_force_g in indx.cfg. Checks off or no load cell: ok.
# A failed reading at or above seat_empty_max_g is ambiguous: something may
# be on the head (a half seated tool), so it is not treated as empty.
variable_ok: 1
variable_force_g: 0.0
variable_ambiguous: 0
gcode:
    {% set e = printer["gcode_macro _INDX_LC_STORE"] %}
    {% set tp = printer["gcode_macro TOOL_POSITIONS"] %}
    {% set ns = namespace(ok=1, force=0.0, ambiguous=0) %}
    {% if tp.seat_check_enabled|default(True) and e.empty_valid|int and e.now_valid|int %}
        {% set ns.force = e.now_g|float - e.empty_g|float %}
        {% set ns.ok = 1 if ns.force|abs >= tp.seat_min_force_g|default(680.0)|float else 0 %}
        {% set ns.ambiguous = 1 if not ns.ok and ns.force|abs >= tp.seat_empty_max_g|default(230.0)|float else 0 %}
        {% if ns.ok %}
            RESPOND MSG="T{params.TOOL} seated: load cell {ns.force|round(0)|int} g against the empty head"
        {% endif %}
    {% endif %}
    SET_GCODE_VARIABLE MACRO=_INDX_LC_STORE VARIABLE=empty_valid VALUE=0
    SET_GCODE_VARIABLE MACRO=_INDX_LC_STORE VARIABLE=now_valid VALUE=0
    SET_GCODE_VARIABLE MACRO=_INDX_SEAT_CHECK VARIABLE=ok VALUE={ns.ok}
    SET_GCODE_VARIABLE MACRO=_INDX_SEAT_CHECK VARIABLE=force_g VALUE={ns.force}
    SET_GCODE_VARIABLE MACRO=_INDX_SEAT_CHECK VARIABLE=ambiguous VALUE={ns.ambiguous}

[gcode_macro _INDX_PARK_CHECK]
description: Inner - after a park: did the load cell change by about the tool's preload? If not the tool may still be on the head: stop, heater off, tool kept as active
# Seated tools read 1100 to 1900 g away from an empty head on the test
# machine, so a park that really released the tool changes the reading by
# that much. Both readings are taken standing still, seconds apart.
# Threshold: park_min_change_g in indx.cfg. Checks off or no load cell: no check.
gcode:
    {% set t = params.TOOL|int %}
    {% set e = printer["gcode_macro _INDX_LC_STORE"] %}
    {% set tp = printer["gcode_macro TOOL_POSITIONS"] %}
    SET_GCODE_VARIABLE MACRO=_INDX_LC_STORE VARIABLE=seated_valid VALUE=0
    SET_GCODE_VARIABLE MACRO=_INDX_LC_STORE VARIABLE=now_valid VALUE=0
    {% if tp.seat_check_enabled|default(True) and e.seated_valid|int and e.now_valid|int %}
        {% set change = e.now_g|float - e.seated_g|float %}
        {% if change|abs < tp.park_min_change_g|default(425.0)|float %}
            M104 S0
            _INDX_LCD LEVEL=warn MSG="T{t} may still be on the head"
            RESPOND TYPE=error MSG="T{t} may still be on the head: the load cell changed only {change|round(0)|int} g at the park (a released tool changes it by its preload, about 1100 to 1900 g). Stopped with the heater off and T{t} kept as the tool on the head. Check the head. If the heater also reported a model divergence, a blob from a detached print may be stuck on the nozzle."
            _INDX_RAISE MSG="T{t} may still be on the head after the park, see above"
        {% else %}
            RESPOND MSG="T{t} parked: load cell changed {change|round(0)|int} g"
        {% endif %}
    {% endif %}

#####################################################################
#  6. HELPER MACROS
#####################################################################

[gcode_macro _RECORD_TOOLCHANGE]
description: Inner — saves active_tool and increments the toolchange counter after every successful pickup
gcode:
    {% set t = params.TOOL|int %}
    _INDX_SET_ACTIVE_TOOL TOOL={t}
    {% set tc_count = printer.save_variables.variables.toolchange_count|default(0)|int %}
    SAVE_VARIABLE VARIABLE=toolchange_count VALUE={tc_count + 1}

[gcode_macro _INDX_SET_ACTIVE_TOOL]
description: Inner - save active_tool (TOOL=<n>, or -1 for an empty head) and mark that tool active on the T<n> macros for Mainsail and Fluidd
# Every write of active_tool goes through here, so the tool buttons always
# show what INDX has saved. A T<n> macro is only touched when it exists and
# declares variable_active: SET_GCODE_VARIABLE raises on a variable the macro
# does not declare, which would stop a tool change half way.
gcode:
    {% set t = params.TOOL|int %}
    {% set tp = printer["gcode_macro TOOL_POSITIONS"] %}
    SAVE_VARIABLE VARIABLE=active_tool VALUE={t}
    {% for i in range(tp.tool_count|int) %}
        {% set name = "gcode_macro T" ~ i %}
        {% if name in printer and printer[name].active is defined %}
            SET_GCODE_VARIABLE MACRO=T{i} VARIABLE=active VALUE={"True" if i == t else "False"}
        {% endif %}
    {% endfor %}

[gcode_macro TC_RESET_COUNT]
description: Reset the persistent toolchange counter to zero
gcode:
    SAVE_VARIABLE VARIABLE=toolchange_count VALUE=0
    RESPOND MSG="Toolchange counter reset to 0"

[gcode_macro TC_CYCLE_ALL]
description: Pick up and park every configured tool in order (T0→T1→…→Tn), then leave no tool loaded. Used to verify all docks engage and release cleanly.
gcode:
    {% set tp = printer["gcode_macro TOOL_POSITIONS"] %}
    {% set n = tp.tools|length %}
    RESPOND MSG="TC_CYCLE_ALL: cycling {n} tools..."
    {% for i in range(n) %}
        RESPOND MSG="  → picking up T{i}"
        CHANGE_TOOL TOOL={i}
        RESPOND MSG="  ← parking T{i}"
        PARK_TOOL
    {% endfor %}
    RESPOND MSG="TC_CYCLE_ALL complete — no tool loaded"

# Calibration macros are in indx-cal.cfg
