hatchna/INDX/macros/indx-cal.cfg

#####################################################################
#  INDX CALIBRATION MACROS
#####################################################################
#
#  CREDIT / ATTRIBUTION:
#  Base Calibration System: Bondtech INDX (https://github.com/BondtechAB/INDX)
#
#  Borrowed / Adapted from 3DPrintDemon (https://github.com/3DPrintDemon/DEMON_INDX):
#  - Step-by-step camera offset calibration workflow:
#    CAL_ONE_SET_CAMERA_REF, CAL_TWO_PREP_TOOL_CAL, CAL_THREE_SAVE_XY_OFFSET
#  - Tool filament parameter recording: SET_TOOL_FILAMENT, _APPLY_TOOL_FILAMENT
#  - Calibration parking and probe adjustments (_CAL_PARK_ACTIVE, Z_OFFSET_APPLY_PROBE)
#
#  Borrowed / Adapted from Charlie Mayall (https://github.com/charliemayall/INDX):
#  - TPU guided slow load feedrate in LOAD_FILAMENT
#
#  Modifications by Nathan Hatch (hatchna):
#  - Persistent filament and temp tracking (tX_filament, tX_temp) in LOAD_FILAMENT
#  - Spoolman active spool detection and synchronization in LOAD_FILAMENT
#  - Added custom UNLOAD_FILAMENT macro with nozzle tip shaping & Spoolman clearing
#
#  ─────────────────────────────────────────────────────────────────
#  This file contains all calibration workflows for the INDX system.
#  User-configurable values (probe position, tool count, etc.) live
#  in indx.cfg — nothing in this file needs editing.
#
#  CALIBRATION WORKFLOWS
#  ─────────────────────────────────────────────────────────────────
#  1. Dock position          CAL_SET_DOCK_Y
#                              Jog to the dock, run to get the value,
#                              paste into indx.cfg.
#                            CALIBRATE_DOCK_X TOOL=N
#                              Automated: disable motors, slide to dock,
#                              homes Y+X via INDX_DOCK_MEASURE and reports
#                              the absolute dock X to paste into indx.cfg.
#                            READ_DOCK_POSITION TOOL=N
#                              Already homed? Jog to the dock and read the
#                              current X directly.
#
#  2. XY tool offsets        CAL_ONE_SET_CAMERA_REF
#     (camera method)        CAL_TWO_PREP_TOOL_CAL TOOL=N
#                            CAL_THREE_SAVE_XY_OFFSET
#
#  3. Z auto-calibration     CAL_Z
#     (convergent + median)    Convergence window + median sampling.
#
#  4. Inspect / utilities    CAL_CHECK_OFFSETS
#                            RESET_GLOBAL_Z
#
#  5. Filament / heat cap.   LOAD_FILAMENT TOOL=N TYPE=<material>
#                              Pick up a tool, set the filament's heat
#                              capacity for the safety model, and
#                              load + prime it.
#  
#  6. Filament Unload        UNLOAD_FILAMENT TOOL=N Pick up a tool 
#                              (or active tool), heat to TYPE/TEMP/min_temp, 
#                              and perform tip shaping + unload.
#
#  7. Load cell              CALIBRATE_LOAD_CELL, then
#     (before Z homing!)     CALIBRATE_LOAD_CELL_APPLY GRAMS=1600
#                              Calibrate the load cell (the Z probe)
#                              before Z homing. Homes X/Y; seat a tool
#                              by hand between the two steps.
#
#####################################################################


#####################################################################
#  1. DOCK POSITION CALIBRATION
#####################################################################

[gcode_macro CAL_SET_DOCK_Y]
description: Report the dock_y value for the active tool from current Y position — paste result into indx.cfg
gcode:
    {% set act = printer.save_variables.variables.active_tool|default(-1)|int %}
    {% if act >= 0 %}
        {% set new_dock_y = "%.3f"|format(printer.toolhead.position.y|float) %}
        RESPOND MSG="──────────────────────────────────────"
        RESPOND MSG="  T{act} dock_y = {new_dock_y}"
        RESPOND MSG="  Update indx.cfg:"
        RESPOND MSG="    variable_t{act}_dock_y: {new_dock_y}"
        RESPOND MSG="  Then RESTART to apply."
        RESPOND MSG="──────────────────────────────────────"
    {% else %}
        RESPOND TYPE=error MSG="No tool loaded. Pick up a tool first."
    {% endif %}


#####################################################################
#  2. XY TOOL OFFSET CALIBRATION (CAMERA METHOD)
#####################################################################
#
#  CREDIT / ATTRIBUTION:
#  Author / Source: 3DPrintDemon (https://github.com/3DPrintDemon/DEMON_INDX)
#  Description: Step-by-step numbered calibration workflow
#               (CAL_ONE_SET_CAMERA_REF, CAL_TWO_PREP_TOOL_CAL, CAL_THREE_SAVE_XY_OFFSET)
#
#  Step 1: Pick up T0, jog it so the nozzle tip is centred in your
#          camera crosshair, then run CAL_ONE_SET_CAMERA_REF.
#  Step 2: For each additional tool, run CAL_TWO_PREP_TOOL_CAL TOOL=N.
#          The tool is picked up and moved to the camera position.
#          Jog to re-centre it in the crosshair.
#  Step 3: Run CAL_THREE_SAVE_XY_OFFSET to save the offset. The
#          nozzle stays exactly where you aligned it; only the
#          coordinate system shifts.
#
#####################################################################

[gcode_macro CAL_ONE_SET_CAMERA_REF]
description: Step 1 — Centre T0 in camera crosshair and save as reference point
gcode:
    {% set pos = printer.toolhead.position %}
    SAVE_VARIABLE VARIABLE=cam_pos_x VALUE='{"%.3f"|format(pos.x)}'
    SAVE_VARIABLE VARIABLE=cam_pos_y VALUE='{"%.3f"|format(pos.y)}'
    SAVE_VARIABLE VARIABLE=cam_pos_z VALUE='{"%.3f"|format(pos.z)}'
    RESPOND MSG="Camera reference saved at T0 position (X={'%.3f'|format(pos.x)} Y={'%.3f'|format(pos.y)} Z={'%.3f'|format(pos.z)})."

[gcode_macro CAL_TWO_PREP_TOOL_CAL]
description: Step 2 — Pick up tool N and move to camera position for alignment
gcode:
    {% set t = params.TOOL|default(-1)|int %}
    {% if t >= 0 %}
        CHANGE_TOOL TOOL={t} SKIP_Z_CORRECTION=1
        _CAL_LATCH_ENGAGE
        SET_GCODE_OFFSET X=0 Y=0 Z=0 MOVE=1
        _CAL_GOTO_CAMPOS
        RESPOND MSG="Align T{t} in crosshair, then run CAL_THREE_SAVE_XY_OFFSET"
    {% else %}
        RESPOND TYPE=error MSG="Usage: CAL_TWO_PREP_TOOL_CAL TOOL=1"
    {% endif %}

[gcode_macro CAL_THREE_SAVE_XY_OFFSET]
description: Step 3 — Calculate XY offset from current position and save
gcode:
    {% set svv = printer.save_variables.variables %}
    {% set act = svv.active_tool|default(-1)|int %}
    {% if act >= 0 %}
        {% set off_x = 0.0 if act == 0 else (printer.toolhead.position.x - svv.cam_pos_x|float) %}
        {% set off_y = 0.0 if act == 0 else (printer.toolhead.position.y - svv.cam_pos_y|float) %}
        SAVE_VARIABLE VARIABLE=t{act}_offset_x VALUE='{"%.3f"|format(off_x)}'
        SAVE_VARIABLE VARIABLE=t{act}_offset_y VALUE='{"%.3f"|format(off_y)}'
        SET_GCODE_OFFSET X={"%.3f"|format(off_x)} Y={"%.3f"|format(off_y)}
        RESPOND MSG="T{act} XY offset saved — X={'%.3f'|format(off_x)}  Y={'%.3f'|format(off_y)}"
    {% else %}
        RESPOND TYPE=error MSG="No tool loaded."
    {% endif %}

[gcode_macro _CAL_GOTO_CAMPOS]
description: Inner — move to saved camera reference position
gcode:
    {% set svv = printer.save_variables.variables %}
    {% if 'cam_pos_x' not in svv or 'cam_pos_y' not in svv or 'cam_pos_z' not in svv %}
        {action_raise_error("Camera reference missing. Run CAL_ONE_SET_CAMERA_REF first.")}
    {% endif %}
    {% set cx = svv.cam_pos_x|float %}
    {% set cy = svv.cam_pos_y|float %}
    {% set cz = svv.cam_pos_z|float %}
    {% set safe_z = cz + 5.0 %}
    G90
    {% if printer.toolhead.position.z < safe_z %}
        G0 Z{safe_z} F1500
    {% endif %}
    G0 X{cx} Y{cy} F8000
    G0 Z{cz} F1500


#####################################################################
#  3. Z AUTO-CALIBRATION (CONVERGENT + MEDIAN)
#####################################################################
#
#  CAL_Z probes each tool in two phases:
#
#  Phase 1 — Convergence (with fuzzing):
#    Maintains a rolling window of the last 4 probe values. Once the
#    sample variance of that window is below (0.005 mm)² = 0.000025 mm²
#    convergence is declared. If 7 probes pass without convergence the
#    head moves to the next of 6 positions on a 3 mm radius circle
#    (within the 10 mm diameter boundary) and restarts the window.
#    After 2 fuzz moves probe speed drops to half to reduce contact
#    force and that slower speed is kept for the final samples too.
#
#  Phase 2 — Median sampling:
#    Once converged (or after max_probes), takes sample_count clean
#    probes at the same position and saves the median as the result.
#
#  Usage:
#    CAL_Z
#    CAL_Z NOZZLE_TEMP=150 SOAK=10
#
#  Prerequisites:
#    - Printer homed (auto-homes if not)
#
#  Probe positions:
#    Probe location is chosen with probe_location (see below). For
#    edge positions the 10 mm diameter fuzz circle is inset from the
#    bed edge by edge_inset mm so the circle edge stays on the bed.
#
#    Initial probe  — per-tool debris-clearing spot, spread in X (or Y
#                     for left/right) from the clean zone so each tool
#                     contaminates a unique area.
#    Clean probe    — centre of the fuzz circle, same XY for all tools.
#
#  Configuration variables on CAL_Z:
#    probe_location  — "center" | "rear" | "front" | "left" | "right"
#    edge_inset      — mm from bed edge to the near edge of the fuzz
#                      circle (non-center positions only)
#    probe_speed     — normal probe speed (mm/s); halved after 2 fuzzes
#    sample_count    — final clean probes per tool for the median
#    nozzle_temp     — runtime nozzle target; 0 keeps the current cold behaviour
#    nozzle_soak     — seconds to soak each attached tool at nozzle_temp
#
#####################################################################

[gcode_macro CAL_Z]
description: Convergent Z probe (SD window + fuzzing) then median samples — saves Z offsets relative to T0
variable_probe_location:  "rear"   # "center" | "rear" | "front" | "left" | "right"
variable_edge_inset:         5.0   # mm from bed edge to near edge of fuzz circle
variable_probe_speed:        3.0   # normal probe speed mm/s (halved after 2 fuzz moves)
variable_probe_retract:      1.0   # Z retract between convergence/sample probes (mm, relative)
variable_toolchange_z:      20.0   # minimum Z before each CHANGE_TOOL (nozzle clearance, mm)
variable_sample_count:         5   # final clean probes per tool — median saved as result
variable_nozzle_temp:         0.0   # runtime nozzle target; 0 disables heating
variable_nozzle_soak:         0.0   # runtime soak after reaching nozzle_temp (seconds)
gcode:
    RESPOND MSG="CAL_Z: Make sure no filament is available to the extruder gears in any tool."
    {% set tp  = printer["gcode_macro TOOL_POSITIONS"] %}
    {% set svv = printer.save_variables.variables %}
    {% set cfg = printer["gcode_macro CAL_Z"] %}
    {% set n   = tp.tool_count|int %}
    {% set sc  = cfg.sample_count|int %}
    {% set spd = cfg.probe_speed|float %}
    {% set loc = cfg.probe_location %}
    {% set ins = cfg.edge_inset|float %}
    {% set nozzle_temp = params.NOZZLE_TEMP|default(0)|float %}
    {% set nozzle_soak = params.SOAK|default(0)|float %}

    {% if nozzle_temp < 0 or nozzle_soak < 0 %}
        {action_raise_error("CAL_Z requires NOZZLE_TEMP>=0 and SOAK>=0")}
    {% endif %}

    {% if "xyz" not in printer.toolhead.homed_axes %}
        G28
    {% endif %}

    SAVE_VARIABLE VARIABLE=v2z_total_tools  VALUE={n}
    SAVE_VARIABLE VARIABLE=v2z_current_tool VALUE=0
    SET_GCODE_VARIABLE MACRO=CAL_Z VARIABLE=nozzle_temp VALUE={nozzle_temp}
    SET_GCODE_VARIABLE MACRO=CAL_Z VARIABLE=nozzle_soak VALUE={nozzle_soak}

    # Compute clean probe centre from bed dimensions and probe_location
    {% set th  = printer.toolhead %}
    {% set bcx = (th.axis_minimum.x + th.axis_maximum.x) / 2 %}
    {% set bcy = (th.axis_minimum.y + th.axis_maximum.y) / 2 %}
    {% set r   = 5.0 %}
    {% set pns = namespace(cx=bcx, cy=bcy) %}
    {% if loc == "rear"  %}{% set pns.cy = th.axis_maximum.y - ins - r %}{% endif %}
    {% if loc == "front" %}{% set pns.cy = th.axis_minimum.y + ins + r %}{% endif %}
    {% if loc == "left"  %}{% set pns.cx = th.axis_minimum.x + ins + r %}{% endif %}
    {% if loc == "right" %}{% set pns.cx = th.axis_maximum.x - ins - r %}{% endif %}

    RESPOND MSG="═══════════════════════════════════════════════"
    RESPOND MSG="  CAL_Z — {n} tools"
    RESPOND MSG="  T0 reference offset: {svv.t0_offset_z|default(0.0)}"
    RESPOND MSG="  Location       {loc}  (inset {'%.1f'|format(ins)} mm)"
    RESPOND MSG="  Clean probe    X={'%.2f'|format(pns.cx)}  Y={'%.2f'|format(pns.cy)}"
    RESPOND MSG="  Convergence    SD < 0.005 mm over 4-sample window  (fuzz after 7)"
    RESPOND MSG="  Final samples  {sc} probes → median"
    {% if nozzle_temp > 0 %}
        RESPOND MSG="  Nozzle         {'%.1f'|format(nozzle_temp)}C / soak {'%.0f'|format(nozzle_soak)}s per tool"
    {% else %}
        RESPOND MSG="  Nozzle         cold (heater not controlled)"
    {% endif %}
    RESPOND MSG="  Probe speed    {'%.1f'|format(spd)} mm/s  (→ {'%.1f'|format(spd/2)} after 2 fuzz moves)"
    RESPOND MSG="═══════════════════════════════════════════════"

    _CZ_NEXT_TOOL


#####################################################################
#  TOOL LOOP
#####################################################################

[gcode_macro _CZ_NEXT_TOOL]
description: Inner — pick up tool, debris-clear at per-tool spot, start convergence at clean spot
gcode:
    {% set svv   = printer.save_variables.variables %}
    {% set tp    = printer["gcode_macro TOOL_POSITIONS"] %}
    {% set cfg   = printer["gcode_macro CAL_Z"] %}
    {% set i     = svv.v2z_current_tool|int %}
    {% set n     = svv.v2z_total_tools|int %}
    {% set z_clr = tp.probe_z_clearance|float %}
    {% set loc   = cfg.probe_location %}
    {% set ins   = cfg.edge_inset|float %}

    # Compute clean probe centre
    {% set th  = printer.toolhead %}
    {% set bcx = (th.axis_minimum.x + th.axis_maximum.x) / 2 %}
    {% set bcy = (th.axis_minimum.y + th.axis_maximum.y) / 2 %}
    {% set r   = 5.0 %}
    {% set pns = namespace(cx=bcx, cy=bcy) %}
    {% if loc == "rear"  %}{% set pns.cy = th.axis_maximum.y - ins - r %}{% endif %}
    {% if loc == "front" %}{% set pns.cy = th.axis_minimum.y + ins + r %}{% endif %}
    {% if loc == "left"  %}{% set pns.cx = th.axis_minimum.x + ins + r %}{% endif %}
    {% if loc == "right" %}{% set pns.cx = th.axis_maximum.x - ins - r %}{% endif %}
    {% set cx = pns.cx %}
    {% set cy = pns.cy %}

    # Per-tool debris-clearing spot: spread in X for centre/rear/front,
    # in -Y for left/right, so each tool contaminates a unique area
    # outside the shared clean measurement zone.
    {% set dns = namespace(ix=cx, iy=cy) %}
    {% if loc == "left" or loc == "right" %}
        {% set dns.iy = cy - (i + 2) * 5.0 %}
    {% else %}
        {% set dns.ix = cx - (i + 2) * 5.0 %}
    {% endif %}

    {% if i >= n %}
        _CZ_FINALIZE
    {% else %}
        RESPOND MSG="───────────────────────────────────────────────"
        RESPOND MSG="  T{i} — debris-clearing at X={'%.2f'|format(dns.ix)} Y={'%.2f'|format(dns.iy)}"

        # Lift to at least toolchange_z before the tool swap so parked nozzles
        # clear the bed. tc-macros only adds a small relative z_hop; at low Z
        # (post-probe) that is not enough.
        {% set tc_z = [printer.toolhead.position.z, cfg.toolchange_z|float]|max %}
        G90
        G0 Z{'%.3f'|format(tc_z)} F3000
        CHANGE_TOOL TOOL={i} SKIP_Z_CORRECTION=1
        _CAL_LATCH_ENGAGE
        {% if cfg.nozzle_temp|float > 0 %}
            RESPOND MSG="  T{i} — heating to {'%.1f'|format(cfg.nozzle_temp|float)}C, then soaking {'%.0f'|format(cfg.nozzle_soak|float)}s"
            M109 S{cfg.nozzle_temp|float}
            {% if cfg.nozzle_soak|float > 0 %}
                G4 P{(cfg.nozzle_soak|float * 1000)|int}
            {% endif %}
        {% endif %}
        G90
        G0 Z{z_clr} F1500
        G0 X{'%.3f'|format(dns.ix)} Y{'%.3f'|format(dns.iy)} F8000
        PROBE
        G0 Z{z_clr} F1500
        PROBE
        G0 Z{z_clr} F1500
        PROBE
        G0 Z{z_clr} F1500

        # Move to shared clean measurement spot
        G0 X{'%.3f'|format(cx)} Y{'%.3f'|format(cy)} F3000

        # Reset convergence state for this tool
        SAVE_VARIABLE VARIABLE=v2z_probe_count   VALUE=0
        SAVE_VARIABLE VARIABLE=v2z_since_fuzz    VALUE=0
        SAVE_VARIABLE VARIABLE=v2z_win_count     VALUE=0
        SAVE_VARIABLE VARIABLE=v2z_win_pos       VALUE=0
        SAVE_VARIABLE VARIABLE=v2z_fuzz_attempts VALUE=0

        RESPOND MSG="  T{i} — probing to convergence (SD < 0.005 mm, fuzz after 7)..."

        UPDATE_DELAYED_GCODE ID=_cz_probe_loop DURATION=0.1
    {% endif %}


#####################################################################
#  CONVERGENCE LOOP
#####################################################################

[gcode_macro _CZ_PROBE_STEP]
description: Inner — small relative retract, probe at current speed, hand off to _CZ_READ
gcode:
    {% set svv   = printer.save_variables.variables %}
    {% set cfg   = printer["gcode_macro CAL_Z"] %}
    {% set fa    = svv.v2z_fuzz_attempts|default(0)|int %}
    {% set spd   = cfg.probe_speed|float %}
    {% set actual_spd = spd / 2.0 if fa >= 2 else spd %}
    # Relative retract — safe regardless of where the probe left the head
    G91
    G0 Z{cfg.probe_retract} F1500
    G90
    PROBE PROBE_SPEED={actual_spd}
    _CZ_READ


[gcode_macro _CZ_READ]
description: Inner — update SD window, check convergence, fuzz or loop or start final sampling
gcode:
    {% set svv           = printer.save_variables.variables %}
    {% set i             = svv.v2z_current_tool|int %}
    {% set z             = printer.probe.last_z_result|float %}
    {% set probe_count   = svv.v2z_probe_count|default(0)|int %}
    {% set since_fuzz    = svv.v2z_since_fuzz|default(0)|int %}
    {% set win_count     = svv.v2z_win_count|default(0)|int %}
    {% set win_pos       = svv.v2z_win_pos|default(0)|int %}
    {% set fuzz_attempts = svv.v2z_fuzz_attempts|default(0)|int %}
    {% set threshold_sq  = 0.000025 %}   # (0.005 mm)²
    {% set fuzz_trigger  = 7 %}
    {% set max_probes    = 50 %}

    {% set new_probe_count = probe_count + 1 %}
    {% set new_since_fuzz  = since_fuzz + 1 %}
    {% set new_win_pos     = (win_pos + 1) % 4 %}
    {% set new_win_count   = [win_count + 1, 4]|min %}

    # Build updated window in Jinja2 — SAVE_VARIABLE hasn't executed yet
    # at template-evaluation time, so derive from the old svv values.
    {% set wns = namespace(w0 = svv.v2z_win_0|default(0.0)|float,
                           w1 = svv.v2z_win_1|default(0.0)|float,
                           w2 = svv.v2z_win_2|default(0.0)|float,
                           w3 = svv.v2z_win_3|default(0.0)|float) %}
    {% if win_pos == 0 %}{% set wns.w0 = z %}{% endif %}
    {% if win_pos == 1 %}{% set wns.w1 = z %}{% endif %}
    {% if win_pos == 2 %}{% set wns.w2 = z %}{% endif %}
    {% if win_pos == 3 %}{% set wns.w3 = z %}{% endif %}

    # Compute sample variance once the window is full (requires 4 readings)
    {% set cns = namespace(converged=false, variance=0.0) %}
    {% if new_win_count >= 4 %}
        {% set m = (wns.w0 + wns.w1 + wns.w2 + wns.w3) / 4.0 %}
        {% set cns.variance = ((wns.w0-m)**2 + (wns.w1-m)**2 + (wns.w2-m)**2 + (wns.w3-m)**2) / 3.0 %}
        {% set cns.converged = cns.variance < threshold_sq %}
    {% endif %}

    {% set converged   = cns.converged %}
    {% set limit_hit   = new_probe_count >= max_probes %}
    {% set should_fuzz = (new_since_fuzz >= fuzz_trigger) and not converged %}

    # Report — variance shown as μm² for readability (threshold = 25.0 μm²)
    {% if new_win_count < 4 %}
        RESPOND MSG="  T{i}  probe {new_probe_count}: {'%.4f'|format(z)}  (window {new_win_count}/4)"
    {% elif converged %}
        RESPOND MSG="  T{i}  probe {new_probe_count}: {'%.4f'|format(z)}  ✓ var={'%.1f'|format(cns.variance * 1e6)} μm²"
    {% else %}
        RESPOND MSG="  T{i}  probe {new_probe_count}: {'%.4f'|format(z)}  ✗ var={'%.1f'|format(cns.variance * 1e6)} μm²  ({new_since_fuzz}/{fuzz_trigger})"
    {% endif %}

    # Save window state; the fuzz branch below overrides win_count/win_pos to 0
    SAVE_VARIABLE VARIABLE={'v2z_win_%d' % win_pos} VALUE={'%.6f'|format(z)}
    SAVE_VARIABLE VARIABLE=v2z_win_pos     VALUE={new_win_pos}
    SAVE_VARIABLE VARIABLE=v2z_win_count   VALUE={new_win_count}
    SAVE_VARIABLE VARIABLE=v2z_probe_count VALUE={new_probe_count}

    {% if converged %}
        RESPOND MSG="  T{i}  converged after {new_probe_count} probes — taking final samples..."
        SAVE_VARIABLE VARIABLE=v2z_sample_idx VALUE=0
        UPDATE_DELAYED_GCODE ID=_cz_sample_loop DURATION=0.1
    {% elif limit_hit %}
        RESPOND TYPE=error MSG="  T{i}  no convergence after {max_probes} probes — taking final samples anyway..."
        SAVE_VARIABLE VARIABLE=v2z_sample_idx VALUE=0
        UPDATE_DELAYED_GCODE ID=_cz_sample_loop DURATION=0.1
    {% elif should_fuzz %}
        RESPOND MSG="  T{i}  7 probes without convergence — fuzzing to position {fuzz_attempts + 1}"
        SAVE_VARIABLE VARIABLE=v2z_fuzz_attempts VALUE={fuzz_attempts + 1}
        SAVE_VARIABLE VARIABLE=v2z_since_fuzz    VALUE=0
        SAVE_VARIABLE VARIABLE=v2z_win_count     VALUE=0
        SAVE_VARIABLE VARIABLE=v2z_win_pos       VALUE=0
        UPDATE_DELAYED_GCODE ID=_cz_fuzz_move DURATION=0.1
    {% else %}
        SAVE_VARIABLE VARIABLE=v2z_since_fuzz VALUE={new_since_fuzz}
        UPDATE_DELAYED_GCODE ID=_cz_probe_loop DURATION=0.1
    {% endif %}


[delayed_gcode _cz_probe_loop]
gcode:
    _CZ_PROBE_STEP


#####################################################################
#  FUZZ MOVE
#####################################################################

[gcode_macro _CZ_FUZZ_MOVE]
description: Inner — move to next position on fuzz circle, restart convergence
gcode:
    {% set svv   = printer.save_variables.variables %}
    {% set tp    = printer["gcode_macro TOOL_POSITIONS"] %}
    {% set cfg   = printer["gcode_macro CAL_Z"] %}
    {% set th    = printer.toolhead %}
    {% set z_clr = tp.probe_z_clearance|float %}
    {% set i     = svv.v2z_current_tool|int %}
    {% set fa    = svv.v2z_fuzz_attempts|int %}
    {% set loc   = cfg.probe_location %}
    {% set ins   = cfg.edge_inset|float %}

    # Re-compute clean probe centre
    {% set bcx = (th.axis_minimum.x + th.axis_maximum.x) / 2 %}
    {% set bcy = (th.axis_minimum.y + th.axis_maximum.y) / 2 %}
    {% set r   = 5.0 %}
    {% set pns = namespace(cx=bcx, cy=bcy) %}
    {% if loc == "rear"  %}{% set pns.cy = th.axis_maximum.y - ins - r %}{% endif %}
    {% if loc == "front" %}{% set pns.cy = th.axis_minimum.y + ins + r %}{% endif %}
    {% if loc == "left"  %}{% set pns.cx = th.axis_minimum.x + ins + r %}{% endif %}
    {% if loc == "right" %}{% set pns.cx = th.axis_maximum.x - ins - r %}{% endif %}

    # 6 positions on a 3 mm radius circle (within the 10 mm diameter),
    # spaced 60° apart so adjacent positions are exactly 3 mm apart.
    {% set fuzz_dx = [ 3.0,  1.5, -1.5, -3.0, -1.5,  1.5] %}
    {% set fuzz_dy = [ 0.0,  2.6,  2.6,  0.0, -2.6, -2.6] %}
    {% set idx = (fa - 1) % (fuzz_dx|length) %}
    {% set tx  = pns.cx + fuzz_dx[idx] %}
    {% set ty  = pns.cy + fuzz_dy[idx] %}

    G0 Z{z_clr} F1500
    G0 X{'%.3f'|format(tx)} Y{'%.3f'|format(ty)} F3000

    UPDATE_DELAYED_GCODE ID=_cz_probe_loop DURATION=0.1


[delayed_gcode _cz_fuzz_move]
gcode:
    _CZ_FUZZ_MOVE


#####################################################################
#  FINAL SAMPLE LOOP
#####################################################################

[gcode_macro _CZ_SAMPLE_STEP]
description: Inner — small relative retract, take one final sample at current speed, hand off to _CZ_RECORD
gcode:
    {% set svv   = printer.save_variables.variables %}
    {% set cfg   = printer["gcode_macro CAL_Z"] %}
    {% set fa    = svv.v2z_fuzz_attempts|default(0)|int %}
    {% set spd   = cfg.probe_speed|float %}
    {% set actual_spd = spd / 2.0 if fa >= 2 else spd %}
    # Same relative retract as convergence probes — bed surface already known
    G91
    G0 Z{cfg.probe_retract} F1500
    G90
    PROBE PROBE_SPEED={actual_spd}
    _CZ_RECORD


[gcode_macro _CZ_RECORD]
description: Inner — save this final sample, loop or trigger median calculation
gcode:
    {% set svv = printer.save_variables.variables %}
    {% set cfg = printer["gcode_macro CAL_Z"] %}
    {% set i   = svv.v2z_current_tool|int %}
    {% set z   = printer.probe.last_z_result|float %}
    {% set idx = svv.v2z_sample_idx|default(0)|int %}
    {% set sc  = cfg.sample_count|int %}

    RESPOND MSG="  T{i}  sample {idx + 1}/{sc}: {'%.4f'|format(z)}"
    SAVE_VARIABLE VARIABLE={'v2z_sample_%d' % idx} VALUE={'%.6f'|format(z)}
    SAVE_VARIABLE VARIABLE=v2z_sample_idx VALUE={idx + 1}

    {% if idx + 1 >= sc %}
        UPDATE_DELAYED_GCODE ID=_cz_median_loop DURATION=0.1
    {% else %}
        UPDATE_DELAYED_GCODE ID=_cz_sample_loop DURATION=0.1
    {% endif %}


[gcode_macro _CZ_COMPUTE_MEDIAN]
description: Inner — sort final samples, compute median, save result, advance to next tool
gcode:
    {% set svv = printer.save_variables.variables %}
    {% set cfg = printer["gcode_macro CAL_Z"] %}
    {% set i   = svv.v2z_current_tool|int %}
    {% set sc  = cfg.sample_count|int %}

    {% set ns = namespace(data=[]) %}
    {% for j in range(sc) %}
        {% set ns.data = ns.data + [svv["v2z_sample_%d" % j]|float] %}
    {% endfor %}

    {% set sorted_samples = ns.data|sort %}
    {% set median = sorted_samples[sc // 2] if sc % 2 == 1 else (sorted_samples[sc // 2 - 1] + sorted_samples[sc // 2]) / 2.0 %}

    RESPOND MSG="  T{i}  median of {sc} samples: {'%.4f'|format(median)}"
    SAVE_VARIABLE VARIABLE={'v2z_result_%d' % i} VALUE={'%.6f'|format(median)}
    {% if cfg.nozzle_temp|float > 0 %}
        # A parked tool cannot be heated. Switch the heater off before the
        # next CHANGE_TOOL parks this tool and picks up the next one.
        M104 S0
    {% endif %}
    SAVE_VARIABLE VARIABLE=v2z_current_tool VALUE={i + 1}
    UPDATE_DELAYED_GCODE ID=_cz_tool_loop DURATION=0.1


[delayed_gcode _cz_sample_loop]
gcode:
    _CZ_SAMPLE_STEP


[delayed_gcode _cz_median_loop]
gcode:
    _CZ_COMPUTE_MEDIAN


[delayed_gcode _cz_tool_loop]
gcode:
    _CZ_NEXT_TOOL


#####################################################################
#  FINALIZE
#####################################################################

[gcode_macro _CZ_FINALIZE]
description: Inner — compute Z offsets from median results and save
gcode:
    {% set svv    = printer.save_variables.variables %}
    {% set cfg    = printer["gcode_macro CAL_Z"] %}
    {% set n      = svv.v2z_total_tools|int %}
    {% set ref_z  = svv.v2z_result_0|float %}
    {% set t0_off = svv.t0_offset_z|default(0.0)|float %}

    # Same lift as _CZ_NEXT_TOOL
    {% set tc_z = [printer.toolhead.position.z, cfg.toolchange_z|float]|max %}
    G90
    G0 Z{'%.3f'|format(tc_z)} F3000
    PARK_TOOL

    RESPOND MSG="═══════════════════════════════════════════════"
    RESPOND MSG="  CAL_Z — RESULTS"
    RESPOND MSG="  T0 reference: probe Z={'%.4f'|format(ref_z)}  offset={'%.3f'|format(t0_off)}"
    RESPOND MSG="───────────────────────────────────────────────"

    {% for i in range(n) %}
        {% set probe_i = svv["v2z_result_%d" % i]|float %}
        {% set delta   = probe_i - ref_z %}
        {% set new_z   = t0_off + delta %}
        SAVE_VARIABLE VARIABLE=t{i}_offset_z VALUE={'%.3f'|format(new_z)}
        RESPOND MSG="  T{i}  median={'%.4f'|format(probe_i)}  Δ={'%+.4f'|format(delta)}  → t{i}_offset_z={'%.3f'|format(new_z)}"
    {% endfor %}

    RESPOND MSG="═══════════════════════════════════════════════"
    RESPOND MSG="  Done. Re-load a tool to apply the new offsets."
    RESPOND MSG="═══════════════════════════════════════════════"

#####################################################################
#  DOCK X CALIBRATION
#####################################################################
#
#  CALIBRATE_DOCK_X measures the absolute X of a tool dock using the
#  INDX plugin's native INDX_DOCK_MEASURE command. INDX_DOCK_MEASURE
#  energises XY, homes Y then X from the dock, and derives the absolute
#  position from the raw stepper counts, so it works for each tool in
#  turn without a prior G28.
#
#  A command's result is not visible within the same macro, so the
#  measured value is read back from printer.indx.last_dock_measurement
#  one tick later (delayed_gcode) and reported for you to paste into
#  indx.cfg — same report-and-paste flow as CAL_SET_DOCK_Y.
#
#  Workflow:
#    1. M84  (disable motors)
#    2. Manually slide the toolhead to the tool dock
#    3. CALIBRATE_DOCK_X TOOL=N   → note the reported x value
#    4. Repeat from step 1 for each additional tool
#    5. Paste each variable_tN_x into indx.cfg, then RESTART
#    6. G28 to restore machine coordinates
#
#  If the printer is already homed, jog to the dock and run
#  READ_DOCK_POSITION TOOL=N instead (no homing move required).
#
#####################################################################

[gcode_macro CALIBRATE_DOCK_X]
description: Measure absolute dock X for TOOL=n via INDX_DOCK_MEASURE. Run after M84 + manual slide to dock.
variable_tool: 0
gcode:
    {% if 'TOOL' not in params %}
        {action_raise_error("CALIBRATE_DOCK_X requires TOOL=<n>")}
    {% endif %}
    {% set t = params.TOOL|int %}
    SET_GCODE_VARIABLE MACRO=CALIBRATE_DOCK_X VARIABLE=tool VALUE={t}
    RESPOND MSG="──────────────────────────────────────────────"
    RESPOND MSG="  CALIBRATE_DOCK_X  T{t}"
    RESPOND MSG="  Ensure motors are disabled (M84) and the toolhead"
    RESPOND MSG="  is manually positioned at the T{t} dock."
    RESPOND MSG="──────────────────────────────────────────────"
    # INDX_DOCK_MEASURE homes Y then X and stores the measured dock
    # position in printer.indx.last_dock_measurement.
    INDX_DOCK_MEASURE
    # Result is only readable after the command runs — pick it up next tick.
    UPDATE_DELAYED_GCODE ID=_cal_dock_x_report DURATION=0.1


[delayed_gcode _cal_dock_x_report]
gcode:
    {% set t = printer["gcode_macro CALIBRATE_DOCK_X"].tool|int %}
    {% set m = printer.indx.last_dock_measurement %}
    {% if m %}
        {% set new_x = "%.3f"|format(m['x']|float) %}
        RESPOND MSG="──────────────────────────────────────"
        RESPOND MSG="  T{t} dock_x = {new_x}"
        RESPOND MSG="  Update indx.cfg:"
        RESPOND MSG="    variable_t{t}_x: {new_x}"
        RESPOND MSG="  Then RESTART to apply, and G28 to restore coordinates."
        RESPOND MSG="──────────────────────────────────────"
    {% else %}
        RESPOND TYPE=error MSG="No dock measurement available — did INDX_DOCK_MEASURE run?"
    {% endif %}


[gcode_macro READ_DOCK_POSITION]
description: Save current (already-homed) X as dock X for TOOL=n. Home first, jog to the dock, then run.
gcode:
    {% if 'TOOL' not in params %}
        {action_raise_error("READ_DOCK_POSITION requires TOOL=<n>")}
    {% endif %}
    {% set t = params.TOOL|int %}
    {% if "x" not in printer.toolhead.homed_axes or "y" not in printer.toolhead.homed_axes %}
        RESPOND TYPE=error MSG="READ_DOCK_POSITION: home the printer (G28) first, or use CALIBRATE_DOCK_X."
    {% else %}
        {% set new_x = "%.3f"|format(printer.toolhead.position.x|float) %}
        RESPOND MSG="──────────────────────────────────────"
        RESPOND MSG="  T{t} dock_x = {new_x}"
        RESPOND MSG="  Update indx.cfg:"
        RESPOND MSG="    variable_t{t}_x: {new_x}"
        RESPOND MSG="  Then RESTART to apply."
        RESPOND MSG="──────────────────────────────────────"
    {% endif %}


[gcode_macro _CAL_LATCH_ENGAGE]
description: Inner — 3 mm E move after tool pickup to ensure latch is fully engaged during calibration (never called during printing)
gcode:
    SAVE_GCODE_STATE NAME=_cal_latch
    _TC_SET_ROTATION_DIST
    # Cold-capable latch engage via INDX_EXTRUDER_MOVE.
    _TC_LATCH_MOVE E=3 F=300
    _TC_RESTORE_ROTATION_DIST
    RESTORE_GCODE_STATE NAME=_cal_latch


[gcode_macro _CAL_PARK_ACTIVE]
description: Inner — park the active tool using raw TOOL_POSITIONS variables (safe before INIT_STATE populates tp.tools)
gcode:
    {% set tp  = printer["gcode_macro TOOL_POSITIONS"] %}
    {% set c   = printer["gcode_macro _INDX_CONSTANTS"] %}
    {% set st  = printer["gcode_macro _TOOLCHANGE_VARS"].toolhead_state|int %}
    {% set ns  = namespace(act=printer.save_variables.variables.active_tool|default(-1)|int) %}
    # If toolhead is physically locked but active_tool is unknown, default to T0
    {% if ns.act < 0 and st == 0 %}
        {% set ns.act = 0 %}
    {% endif %}

    {% if ns.act >= 0 %}
        {% set act       = ns.act %}
        {% set dock_y    = tp["t" ~ act ~ "_dock_y"]|float %}
        {% set clear_y   = tp.clearance_y|float %}
        {% set tool_x    = tp["t" ~ act ~ "_x"]|float %}

        G90
        G1 X{tool_x} Y{clear_y} F15000

        {% if st == 0 %}
            _SYNC_UNLOCK_DANCE DOCK_Y={dock_y}
            SET_GCODE_VARIABLE MACRO=_TOOLCHANGE_VARS VARIABLE=toolhead_state VALUE=2
            SAVE_VARIABLE VARIABLE=toolhead_state VALUE=2
        {% else %}
            G1 Y{dock_y} F{c.dock_feedrate}
        {% endif %}

        M400
        G91
        # Write this as 0 - (x). A bare minus straight after the opening brace is read
        # as Jinja whitespace control, which silently swallows the negation.
        G1 Y{0 - (tp.dock_dir * c.peel_distance)} F{c.peel_feedrate}
        G90
        G1 Y{clear_y} F15000

        _INDX_SET_ACTIVE_TOOL TOOL=-1
    {% endif %}

#####################################################################
#  7. UTILITIES & INSPECTION
#####################################################################

[gcode_macro CAL_CHECK_OFFSETS]
description: Print all saved tool offsets and current global Z state
gcode:
    {% set svv = printer.save_variables.variables %}
    {% set tp  = printer["gcode_macro TOOL_POSITIONS"] %}
    {% set n   = tp.tool_count|int %}
    {% set gz  = svv.global_z_offset|default(0.0)|float %}
    {% set act = svv.active_tool|default(-1)|int %}
    # homing_origin.z = tool_z + global_z; strip tool_z to show the pure global component
    {% set act_tool_z = svv["t" ~ act ~ "_offset_z"]|default(0.0)|float if act >= 0 else 0.0 %}
    {% set live_gz = printer.gcode_move.homing_origin.z|float - act_tool_z %}
    RESPOND MSG="----------------------------------------"
    RESPOND MSG="  TOOL OFFSETS"
    RESPOND MSG="----------------------------------------"
    {% for i in range(n) %}
        {% set ox = svv["t" ~ i ~ "_offset_x"]|default("--")|string %}
        {% set oy = svv["t" ~ i ~ "_offset_y"]|default("--")|string %}
        {% set oz = svv["t" ~ i ~ "_offset_z"]|default("--")|string %}
        RESPOND MSG="  T{i}  X={ox}  Y={oy}  Z={oz}"
    {% endfor %}
    RESPOND MSG="----------------------------------------"
    RESPOND MSG="  Saved global Z:  {'%.3f'|format(gz)} mm"
    RESPOND MSG="  Live  global Z:  {'%.3f'|format(live_gz)} mm"
    RESPOND MSG="  (use ADJUST_GLOBAL_Z ADJUST=+/-mm to tune first layer)"
    RESPOND MSG="----------------------------------------"

[gcode_macro RESET_TOOL_OFFSETS]
description: Zero the X/Y/Z offset of every configured tool. Prints the old values first so they can be read back off the console. Leaves the global Z offset alone - RESET_GLOBAL_Z handles that.
# Offsets are stored per tool as a difference from T0, so T0 is normally zero
# already and clearing it is a no-op. The others are what CAL_Z and the XY
# calibration wrote, and this throws all of it away: it is the starting point
# for calibrating from scratch, not a way to tidy up.
gcode:
    {% set svv = printer.save_variables.variables %}
    {% set tp  = printer["gcode_macro TOOL_POSITIONS"] %}
    {% set n   = tp.tool_count|int %}
    {% set act = svv.active_tool|default(-1)|int %}
    {% set gz  = svv.global_z_offset|default(0.0)|float %}

    RESPOND MSG="----------------------------------------"
    RESPOND MSG="  RESET_TOOL_OFFSETS - clearing {n} tools"
    RESPOND MSG="  Previous values, in case you want them back:"
    {% for i in range(n) %}
        {% set ox = svv["t" ~ i ~ "_offset_x"]|default("--")|string %}
        {% set oy = svv["t" ~ i ~ "_offset_y"]|default("--")|string %}
        {% set oz = svv["t" ~ i ~ "_offset_z"]|default("--")|string %}
        RESPOND MSG="    T{i}  X={ox}  Y={oy}  Z={oz}"
    {% endfor %}

    {% for i in range(n) %}
        SAVE_VARIABLE VARIABLE=t{i}_offset_x VALUE=0.0
        SAVE_VARIABLE VARIABLE=t{i}_offset_y VALUE=0.0
        SAVE_VARIABLE VARIABLE=t{i}_offset_z VALUE=0.0
    {% endfor %}

    # The live offset still carries the old numbers for whatever is on the head.
    # Z keeps the global component, which this macro does not touch. MOVE=1 holds
    # the nozzle where it physically is, but it needs a homed machine to do that,
    # so an unhomed reset just changes the coordinates and leaves the head alone.
    {% if act >= 0 %}
        {% if "xyz" in printer.toolhead.homed_axes %}
            SET_GCODE_OFFSET X=0.0 Y=0.0 Z='{"%.3f"|format(gz)}' MOVE=1
        {% else %}
            SET_GCODE_OFFSET X=0.0 Y=0.0 Z='{"%.3f"|format(gz)}' MOVE=0
        {% endif %}
    {% endif %}

    RESPOND MSG="  All tool offsets zeroed."
    RESPOND MSG="  Re-run CAL_Z and your XY calibration before printing."
    RESPOND MSG="----------------------------------------"

[gcode_macro RESET_GLOBAL_Z]
description: Clear the global Z offset back to 0.0
gcode:
    SAVE_VARIABLE VARIABLE=global_z_offset VALUE=0.0
    {% set svv = printer.save_variables.variables %}
    {% set act = svv.active_tool|default(-1)|int %}
    {% if act >= 0 %}
        {% set tool_z = svv["t" ~ act ~ "_offset_z"]|default(0.0)|float %}
        SET_GCODE_OFFSET Z='{"%.3f"|format(tool_z)}' MOVE=1
    {% endif %}
    RESPOND MSG="Global Z offset cleared to 0.0"

[gcode_macro ADJUST_GLOBAL_Z]
description: Nudge the global Z offset by ADJUST mm (e.g. ADJUST=0.02 or ADJUST=-0.05)
gcode:
    {% set delta = params.ADJUST|default(0.0)|float %}
    {% set svv   = printer.save_variables.variables %}
    {% set old_gz = svv.global_z_offset|default(0.0)|float %}
    {% set new_gz = old_gz + delta %}
    SAVE_VARIABLE VARIABLE=global_z_offset VALUE='{"%.3f"|format(new_gz)}'
    {% set act = svv.active_tool|default(-1)|int %}
    {% if act >= 0 %}
        {% set tool_z = svv["t" ~ act ~ "_offset_z"]|default(0.0)|float %}
        SET_GCODE_OFFSET Z='{"%.3f"|format(tool_z + new_gz)}' MOVE=1
    {% endif %}
    RESPOND MSG="Global Z offset: {'%.3f'|format(new_gz)} mm  (adjusted {'%+.3f'|format(delta)})"

[gcode_macro SYNC_GLOBAL_Z]
description: Capture the current live babystep (homing_origin.z) as the saved global Z offset
gcode:
    {% set svv = printer.save_variables.variables %}
    {% set act = svv.active_tool|default(-1)|int %}
    {% set tool_z = svv["t" ~ act ~ "_offset_z"]|default(0.0)|float if act >= 0 else 0.0 %}
    {% set new_gz = printer.gcode_move.homing_origin.z|float - tool_z %}
    SAVE_VARIABLE VARIABLE=global_z_offset VALUE='{"%.3f"|format(new_gz)}'
    RESPOND MSG="Global Z offset synced: {'%.3f'|format(new_gz)} mm"

[gcode_macro Z_OFFSET_APPLY_PROBE]
rename_existing: _Z_OFFSET_APPLY_PROBE_BASE
description: Bake current global Z into probe z_offset. Run SAVE_CONFIG to persist across restarts.
gcode:
    # homing_origin.z = tool_z + global_z. The base command subtracts homing_origin.z from
    # [load_cell_probe] z_offset, so we must temporarily set it to only global_z first.
    # After baking, restore homing_origin.z to tool_z so the active tool stays correct.
    # Use the live babystep (homing_origin.z - tool_z) so Mainsail/Fluidd Apply works
    # without a prior SYNC_GLOBAL_Z; save_variables alone is not updated by those UIs.
    {% set svv = printer.save_variables.variables %}
    {% set act = svv.active_tool|default(-1)|int %}
    {% set tool_z = svv["t" ~ act ~ "_offset_z"]|default(0.0)|float if act >= 0 else 0.0 %}
    {% set global_z = printer.gcode_move.homing_origin.z|float - tool_z %}
    SET_GCODE_OFFSET Z='{"%.3f"|format(global_z)}'
    _Z_OFFSET_APPLY_PROBE_BASE
    SET_GCODE_OFFSET Z='{"%.3f"|format(tool_z)}'
    SAVE_VARIABLE VARIABLE=global_z_offset VALUE=0.0
    {% if global_z %}
        RESPOND MSG="Global Z baked into [load_cell_probe] z_offset. Run SAVE_CONFIG to persist."
    {% else %}
        RESPOND MSG="No global Z adjustment to bake — [load_cell_probe] z_offset unchanged."
    {% endif %}


#####################################################################
#  5. FILAMENT LOADING & HEAT CAPACITY
#####################################################################
#
#  CREDIT / ATTRIBUTION:
#  - Base system: Bondtech INDX
#  - SET_TOOL_FILAMENT & _APPLY_TOOL_FILAMENT: Borrowed from 3DPrintDemon
#    (https://github.com/3DPrintDemon/DEMON_INDX)
#  - TPU guided slow load feedrate: Borrowed from Charlie Mayall
#    (https://github.com/charliemayall/INDX)
#  - Spoolman integration & persistent tracking: Authored by Nathan Hatch (hatchna)
#
#  LOAD_FILAMENT picks up a tool, tells the INDX safety thermal model
#  which filament is loaded, heats up, then feeds and primes it.
#
#    LOAD_FILAMENT TOOL=<n> TYPE=<material> [TEMP=<c>] [MEASURE=<0|1>] [SPOOL=<id>]
#
#  The safety thermal model needs to know how much heat the filament
#  carries away. TYPE=<material> applies a density + heat-capacity preset
#  (from the filament_presets table below) plus a default load temperature.
#  Presets are good starting points; for the most accurate model on a
#  specific filament pass MEASURE=1 and INDX_LOAD_FILAMENT will measure the
#  heat capacity while loading (run SAVE_CONFIG afterwards to keep it).
#
#  TEMP=<c> overrides the preset load temperature. Requires a calibrated
#  thermal model — run INDX_CALIBRATE first.
#
#  Edit filament_presets to add materials or tune values
#  (temp °C / density g/cm^3 / heat capacity J/g/K / optional speed mm/s).
#  speed is passed to INDX_LOAD_FILAMENT; omit it to use the firmware default.
#
#####################################################################

[gcode_macro SET_TOOL_FILAMENT]
description: Record the filament in TOOL=n for the safety model and apply it now. DENSITY= g/cm^3, HEAT_CAPACITY= J/g/K. Re-applied automatically on every pickup of that tool.
gcode:
    {% if 'TOOL' not in params or 'DENSITY' not in params or 'HEAT_CAPACITY' not in params %}
        {action_raise_error("Usage: SET_TOOL_FILAMENT TOOL=<n> DENSITY=<g/cm^3> HEAT_CAPACITY=<J/g/K>")}
    {% endif %}
    {% set t = params.TOOL|int %}
    {% set d = params.DENSITY|float %}
    {% set h = params.HEAT_CAPACITY|float %}
    # The model only ever uses density * heat_capacity, so the split between the
    # two is arbitrary — what matters is that the product is right for the
    # material actually in this tool.
    SAVE_VARIABLE VARIABLE=t{t}_fil_density VALUE={d}
    SAVE_VARIABLE VARIABLE=t{t}_fil_hc VALUE={h}
    INDX_SET_MODEL_PARAMS FILAMENT_DENSITY={d} FILAMENT_HEAT_CAPACITY={h}

[gcode_macro _APPLY_TOOL_FILAMENT]
description: Inner — restore the recorded filament model params for TOOL=n, if any
gcode:
    {% set t = params.TOOL|int %}
    {% set svv = printer.save_variables.variables %}
    {% set d = svv["t" ~ t ~ "_fil_density"]|default(none) %}
    {% set h = svv["t" ~ t ~ "_fil_hc"]|default(none) %}
    {% if d is not none and h is not none %}
        INDX_SET_MODEL_PARAMS FILAMENT_DENSITY={d|float} FILAMENT_HEAT_CAPACITY={h|float}
    {% endif %}

[gcode_macro LOAD_FILAMENT]
description: Pick up TOOL=n, set filament TYPE, heat, and load+prime. Optional TEMP= override, SPOOL=<id> for Spoolman; MEASURE=1 measures the heat capacity instead of using the preset.
variable_filament_presets: {"PLA": {"temp": 210, "density": 1.24, "hc": 1.80}, "PETG": {"temp": 240, "density": 1.27, "hc": 1.30}, "ABS": {"temp": 245, "density": 1.04, "hc": 1.40}, "ASA": {"temp": 250, "density": 1.07, "hc": 1.40}, "PA": {"temp": 260, "density": 1.14, "hc": 1.70}, "PC": {"temp": 270, "density": 1.20, "hc": 1.20}, "TPU": {"temp": 230, "density": 1.21, "hc": 1.80, "speed": 2.0}}
gcode:
    {% set presets = printer["gcode_macro LOAD_FILAMENT"].filament_presets %}
    {% if 'TOOL' not in params %}
        {action_raise_error("Usage: LOAD_FILAMENT TOOL=<n> TYPE=<material> [SPOOL=<id>]")}
    {% endif %}
    {% set t       = params.TOOL|int %}
    {% set type    = params.TYPE|default("")|upper %}
    {% set measure = params.MEASURE|default(0)|int %}

    {% if type and type not in presets %}
        {action_raise_error("Unknown TYPE '%s'. Known types: %s" % (type, presets|join(", ")))}
    {% endif %}

    # Load temperature: explicit TEMP= wins, else the TYPE preset, else error
    {% if 'TEMP' in params %}
        {% set temp = params.TEMP|float %}
    {% elif type %}
        {% set temp = presets[type]['temp']|float %}
    {% else %}
        {action_raise_error("Provide TYPE=<material> or TEMP=<c>.")}
    {% endif %}

    # 1. Pick up the tool (CHANGE_TOOL turns the heater off and picks up cold)
    CHANGE_TOOL TOOL={t}

    # 2. Tell the safety model which filament this is (skipped when measuring).
    #    Recorded against the tool as well, so a later toolchange can restore it.
    {% if type and not measure %}
        SET_TOOL_FILAMENT TOOL={t} DENSITY={presets[type]['density']} HEAT_CAPACITY={presets[type]['hc']}
        RESPOND MSG="LOAD_FILAMENT: T{t} {type} - density {presets[type]['density']} g/cm^3, heat capacity {presets[type]['hc']} J/g/K"
    {% endif %}

    # Save filament info for persistent tracking across tool switches and restarts
    {% if type %}
        SAVE_VARIABLE VARIABLE={'t' ~ t ~ '_filament'} VALUE='"{type}"'
        SAVE_VARIABLE VARIABLE={'t' ~ t ~ '_temp'} VALUE={temp}
    {% endif %}

    # Spoolman integration: Auto-detect pre-selected spool from Fluidd/T{t} or explicit SPOOL= param
    {% set svv = printer.save_variables.variables %}
    {% set macro_name = "gcode_macro T" ~ t %}
    {% set ui_spool = printer[macro_name].spool_id if (macro_name in printer and printer[macro_name].spool_id is defined) else svv['t' ~ t ~ '__spool_id']|default(None) %}
    {% set selected_spool = params.SPOOL|default(ui_spool) %}

    {% if selected_spool is defined and selected_spool not in [None, "None", "", -1] %}
        {% set spool_id = selected_spool|int %}
        {% if macro_name in printer %}
            SET_GCODE_VARIABLE MACRO=T{t} VARIABLE=spool_id VALUE={spool_id}
        {% endif %}
        SAVE_VARIABLE VARIABLE={'t' ~ t ~ '__spool_id'} VALUE={spool_id}
        {% if 'gcode_macro SET_ACTIVE_SPOOL' in printer %}
            SET_ACTIVE_SPOOL ID={spool_id}
        {% endif %}
        RESPOND MSG="LOAD_FILAMENT: T{t} active Spoolman Spool ID is {spool_id}"
    {% endif %}

    # 3. Heat to load temperature and wait
    RESPOND MSG="LOAD_FILAMENT: heating T{t} to {temp|int} C..."
    M104 S{temp}
    TEMPERATURE_WAIT SENSOR=extruder MINIMUM={temp - 3} MAXIMUM={temp + 3}

    # 4. Feed and prime. MEASURE=1 measures + applies the heat capacity for this
    #    exact filament (APPLY=1); otherwise the TYPE preset is kept (APPLY=0).
    #    Optional preset speed (mm/s) overrides INDX_LOAD_FILAMENT default - TPU needs
    #    a slow feed or soft filament buckles and can wrap around the Smart Head.
    {% if type and 'speed' in presets[type] %}
        RESPOND MSG="LOAD_FILAMENT: feeding at {presets[type]['speed']} mm/s ({type} preset)"
        INDX_LOAD_FILAMENT APPLY={measure} SPEED={presets[type]['speed']}
    {% else %}
        INDX_LOAD_FILAMENT APPLY={measure}
    {% endif %}
    {% if measure %}
        RESPOND MSG="LOAD_FILAMENT: measured heat capacity applied - run SAVE_CONFIG to keep it."
    {% endif %}

#####################################################################
#  6. FILAMENT UNLOAD
#####################################################################
#
#  CREDIT / ATTRIBUTION:
#  Author / Source: Nathan Hatch (hatchna)
#  Repository: https://github.com/hatchna/INDX
#  Description: Multi-stage filament unloading macro with nozzle tip
#               shaping, part fan cooling, retraction, and Spoolman
#               active spool state reset.
#
#####################################################################

[gcode_macro UNLOAD_FILAMENT]
description: Pick up TOOL=n (or active tool), heat to TYPE/TEMP/min_temp, perform tip shaping + unload, and clear Spoolman spool.
variable_filament_presets: {"PLA": {"temp": 210}, "PETG": {"temp": 240}, "ABS": {"temp": 245}, "ASA": {"temp": 250}, "PA": {"temp": 260}, "PC": {"temp": 270}, "TPU": {"temp": 230}}
variable_unload_distance: 120   ; measure yours — increase until it works
variable_purge_temp_delta: 15   ; degrees above current target to soften tip
variable_min_temp: 200
gcode:
    {% set presets = printer["gcode_macro UNLOAD_FILAMENT"].filament_presets %}
    {% set svv = printer.save_variables.variables %}
    {% set act = svv.active_tool|default(-1)|int %}

    # 1. Determine target tool
    {% if 'TOOL' in params %}
        {% set t = params.TOOL|int %}
    {% elif act >= 0 %}
        {% set t = act %}
    {% else %}
        {action_raise_error("UNLOAD_FILAMENT: No tool specified and no active tool loaded. Usage: UNLOAD_FILAMENT [TOOL=<n>] [TYPE=<material>] [TEMP=<c>]")}
    {% endif %}

    # 2. Determine material/temp (auto-detect from save_variables if not specified)
    {% set saved_type = svv['t' ~ t ~ '_filament']|default("")|upper %}
    {% set saved_temp = svv['t' ~ t ~ '_temp']|default(0)|float %}
    {% set type = params.TYPE|default(saved_type)|upper %}

    {% if type and type not in presets %}
        {action_raise_error("Unknown TYPE '%s'. Known types: %s" % (type, presets|join(", ")))}
    {% endif %}

    {% if 'TEMP' in params %}
        {% set temp = params.TEMP|float %}
    {% elif type %}
        {% set temp = presets[type]['temp']|float %}
    {% elif saved_temp > 0 %}
        {% set temp = saved_temp %}
    {% elif printer.extruder.target >= min_temp %}
        {% set temp = printer.extruder.target %}
    {% else %}
        {% set temp = min_temp|float %}
    {% endif %}

    {% if type %}
        RESPOND PREFIX=ℹ️ MSG="UNLOAD_FILAMENT: Target T{t} ({type} @ {temp|int}°C)"
    {% else %}
        RESPOND PREFIX=ℹ️ MSG="UNLOAD_FILAMENT: Target T{t} (@ {temp|int}°C)"
    {% endif %}

    # 3. Pick up the tool if not already active (or switch tool)
    CHANGE_TOOL TOOL={t}

    # 4. Heat to unload temperature and wait
    {% if printer.extruder.temperature < (temp - 3) %}
        RESPOND PREFIX=🔥 MSG="UNLOAD_FILAMENT: Heating T{t} to {temp|int}°C..."
        M104 S{temp}
        TEMPERATURE_WAIT SENSOR=extruder MINIMUM={temp - 3}
    {% else %}
        M104 S{temp}
    {% endif %}

    # 5. Tip forming sequence
    RESPOND PREFIX=⏪ MSG="UNLOAD_FILAMENT: Forming tip on T{t}..."
    M83                             ; relative extruder
    M106 S255                       ; part fan full blast
    
    G1 E8 F200                      ; push forward to fill nozzle
    G4 P3000                        ; dwell 3s — let tip get fully molten
    G1 E-5 F200                     ; slow pull back (shapes the tip)
    G4 P1000                        ; dwell 1s — let tip cool/solidify slightly
    G1 E-10 F500                    ; medium speed pull (draws the tip thin)
    G4 P2000                        ; dwell 2s — cool further before fast pull
    
    # 6. Fast unload
    RESPOND PREFIX=⏪ MSG="UNLOAD_FILAMENT: Unloading T{t}..."
    G1 E-{unload_distance} F2400    ; fast unload
    M400                            ; wait for completion
    M82                             ; absolute extruder
    M106 S0                         ; fan off

    # 7. Clear Spoolman spool & persistent filament data for this tool
    {% if 'gcode_macro CLEAR_ACTIVE_SPOOL' in printer %}
        CLEAR_ACTIVE_SPOOL
    {% endif %}
    {% set macro_name = "gcode_macro T" ~ t %}
    {% if macro_name in printer %}
        SET_GCODE_VARIABLE MACRO=T{t} VARIABLE=spool_id VALUE=None
    {% endif %}
    SAVE_VARIABLE VARIABLE={'t' ~ t ~ '__spool_id'} VALUE=None
    SAVE_VARIABLE VARIABLE={'t' ~ t ~ '_filament'} VALUE='""'
    SAVE_VARIABLE VARIABLE={'t' ~ t ~ '_temp'} VALUE=0

    RESPOND PREFIX=✅ MSG="UNLOAD_FILAMENT: T{t} unload complete & spool cleared"


#####################################################################
#  LOAD CELL CALIBRATION
#####################################################################
#
#  Calibrate the load cell BEFORE the first Z homing. Z homing probes
#  with the load cell, so it must be calibrated before the printer can
#  home Z — and therefore before dock and Z-offset calibration. The tool
#  is seated by hand because the dock can't be used until Z is homed.
#  X and Y ARE homed first (they don't use the load cell).
#
#  The latch is driven by the extruder motor, so it opens/locks cold.
#  Two steps:
#
#    1) CALIBRATE_LOAD_CELL            (NO tool mounted)
#         Homes X and Y, opens the latch, syncs toolhead_state=Open, tares.
#         Refuses if a tool may be on the head. Skips the XY home when X
#         and Y are homed, and the latch move when the latch is open.
#    2) (seat a passive tool by hand)
#       CALIBRATE_LOAD_CELL_APPLY GRAMS=1600
#         Locks for the force sample, calibrates, accepts, then unlocks
#         and syncs toolhead_state=Open. Does not claim active_tool.
#       SAVE_CONFIG
#
#  Note: LOAD_CELL_CALIBRATE / TARE / CALIBRATE / ACCEPT are the firmware's
#  interactive calibration commands; these macros issue them in sequence.
#  If your build does not allow them to be chained from a macro, run the
#  steps by hand (the wiki lists them).
#
#####################################################################

[gcode_macro CALIBRATE_LOAD_CELL]
description: Load cell calibration step 1 of 2 - run before first Z homing with NO tool mounted. Homes X and Y, opens the latch (soft-state Open), and tares the empty head, then prompts you to seat a tool and run CALIBRATE_LOAD_CELL_APPLY.
# The tare must be taken with an empty head. A tool left on it is tared away,
# and every reading after that is off by its whole latch preload, so refuse
# when a tool may be seated. active_tool is checked first. When an earlier
# calibration exists the load cell is asked as well, counted from that
# calibration's empty head (reference_tare_counts) rather than from the last
# tare, using the homing seat threshold (home_min_force_g). On a first
# calibration there is nothing to count from, so only active_tool is checked.
# HEAD_EMPTY=1 skips the load cell check, for an old calibration that is so
# far off that an empty head reads as seated. It does not skip active_tool.
gcode:
    {% set c = printer["gcode_macro _INDX_CONSTANTS"] %}
    {% set svv = printer.save_variables.variables %}
    {% set act = svv.active_tool|default(-1)|int %}
    {% if act != -1 %}
        {action_raise_error("CALIBRATE_LOAD_CELL needs an empty head, but active_tool says T%d is on it. Put T%d in its dock with PARK_TOOL, or run MANUAL_TOOL_REMOVE and lift it off by hand. Then run CALIBRATE_LOAD_CELL again." % (act, act))}
    {% endif %}
    {% set min_g = printer["gcode_macro TOOL_POSITIONS"].home_min_force_g|default(800.0)|float %}
    {% set lc = printer.load_cell_probe if "load_cell_probe" in printer else {} %}
    {% set cfgl = printer.configfile.settings.load_cell_probe|default({}) %}
    {% set ref = cfgl.reference_tare_counts|default(none) %}
    {% set ns = namespace(force=none) %}
    {% if ref is not none and lc.is_calibrated|default(false)
          and lc.counts_per_gram|default(0)|float > 0
          and lc.tare_counts is defined and lc.force_g|default(none) is not none %}
        {% if ref is not number %}{% set ref = ref|sum %}{% endif %}
        {% set inv = -1.0 if cfgl.sensor_orientation|default("normal") == "inverted" else 1.0 %}
        {% set ns.force = lc.force_g|float + inv * (lc.tare_counts|float - ref|float) / lc.counts_per_gram|float %}
    {% endif %}
    {% if ns.force is not none and ns.force|abs >= min_g and not params.HEAD_EMPTY|default(0)|int %}
        {action_raise_error("CALIBRATE_LOAD_CELL needs an empty head, but the load cell reads %.0f g against the last empty-head calibration, which looks like a seated tool (home_min_force_g is %.0f g). Run MANUAL_TOOL_REMOVE and lift the tool off by hand, or put it in its dock with MANUAL_TOOL_SEAT TOOL=<n> and then PARK_TOOL. Then run CALIBRATE_LOAD_CELL again. If the head really is empty, the old calibration is off: run CALIBRATE_LOAD_CELL HEAD_EMPTY=1." % (ns.force, min_g))}
    {% endif %}
    {% if ns.force is none %}
        RESPOND TYPE=error MSG="CALIBRATE_LOAD_CELL: there is no earlier load cell calibration to check the head against. Make sure no tool is on the Smart Head before you carry on."
    {% endif %}
    # Home X and Y - Z is NOT homed yet; Z homing needs the calibrated load cell.
    # Already homed X and Y are left where they are.
    {% if "x" not in printer.toolhead.homed_axes or "y" not in printer.toolhead.homed_axes %}
        G28 X Y
    {% endif %}
    LOAD_CELL_CALIBRATE
    # Open the latch so a passive tool can be seated by hand. A latch that is
    # already open is left alone: opening it again drives it into its stop.
    {% if svv.toolhead_state|default(0)|int != 2 %}
        _TC_SET_ROTATION_DIST
        _TC_LATCH_MOVE E={c.full_open_e} F={c.latch_feedrate}
        _TC_RESTORE_ROTATION_DIST
    {% endif %}
    M400
    G4 P500
    SET_GCODE_VARIABLE MACRO=_TOOLCHANGE_VARS VARIABLE=toolhead_state VALUE=2
    SAVE_VARIABLE VARIABLE=toolhead_state VALUE=2
    # Tare the empty head
    TARE
    RESPOND MSG="Load cell tared (empty head). Seat a passive tool on the Smart Head by hand - the tool MUST BE EMPTY (no filament loaded). Then run: CALIBRATE_LOAD_CELL_APPLY GRAMS=1600"

[gcode_macro CALIBRATE_LOAD_CELL_APPLY]
description: Load cell calibration step 2 of 2 - with a tool seated by hand, locks for the force sample, calibrates against GRAMS (default 1600), then unlocks (soft-state Open, no active_tool claim). Run SAVE_CONFIG after.
gcode:
    RESPOND MSG="CALIBRATE_LOAD_CELL_APPLY: the seated tool MUST BE EMPTY (no filament loaded)."
    {% set grams = params.GRAMS|default(1600)|float %}
    {% set c = printer["gcode_macro _INDX_CONSTANTS"] %}
    # Lock the latch onto the seated tool, then drive it to fully engage the
    # locking force (all cold-capable extruder moves — no homing needed).
    _TC_SET_ROTATION_DIST
    _TC_LATCH_MOVE E={c.full_lock_e} F={c.latch_feedrate}
    _TC_LATCH_MOVE E=10 F=300
    _TC_RESTORE_ROTATION_DIST
    M400
    G4 P500
    CALIBRATE GRAMS={grams}
    ACCEPT
    # Unlock after cal - soft-state must match physical latch. Do not claim
    # active_tool: the hand-seated tool is not a dock pickup.
    _TC_SET_ROTATION_DIST
    _TC_LATCH_MOVE E={c.full_open_e} F={c.latch_feedrate}
    _TC_RESTORE_ROTATION_DIST
    M400
    SET_GCODE_VARIABLE MACRO=_TOOLCHANGE_VARS VARIABLE=toolhead_state VALUE=2
    SAVE_VARIABLE VARIABLE=toolhead_state VALUE=2
    RESPOND MSG="Load cell calibrated against {grams|int} g. Latch unlocked. Remove the tool by hand, then run SAVE_CONFIG."

[gcode_macro MANUAL_TOOL_REMOVE]
description: ⚠️ Opens toolhead latch for tool removal by hand & resets toolhead macro status to OPEN & EMPTY - USE WITH CAUTION! ⚠️
gcode:
    {% set c = printer["gcode_macro _INDX_CONSTANTS"] %}
    _TC_SET_ROTATION_DIST
    _TC_LATCH_MOVE E={c.full_open_e} F={c.latch_feedrate}
    _TC_RESTORE_ROTATION_DIST
    M400
    SET_GCODE_VARIABLE MACRO=_TOOLCHANGE_VARS VARIABLE=toolhead_state VALUE=2
    SAVE_VARIABLE VARIABLE=toolhead_state VALUE=2
    SAVE_VARIABLE VARIABLE=seat_suspect VALUE=-1
    _INDX_SET_ACTIVE_TOOL TOOL=-1
    RESPOND MSG="⚠️ WARNING! Toolhead latch OPEN! Be sure to REMOVE any tools by hand!!! The toolhead status & active tool have been RESET to OPEN & EMPTY!!"

[gcode_macro MANUAL_TOOL_SEAT]
description: Lock the latch onto a tool seated by hand and claim it as TOOL=<n>. The counterpart to MANUAL_TOOL_REMOVE, and what makes the first Z home possible before the dock can be reached.
# Every other route to active_tool goes through CHANGE_TOOL, which needs a
# homed Z to reach the dock. Z homing in turn needs a tool, because the nozzle
# is the probe. A tool placed by hand breaks that circle, but nothing recorded
# which tool it was, so homing refused a head that had a tool sitting in it.
gcode:
    {% set tp = printer["gcode_macro TOOL_POSITIONS"] %}
    {% set c  = printer["gcode_macro _INDX_CONSTANTS"] %}
    {% if "TOOL" not in params %}
        {action_raise_error("Usage: MANUAL_TOOL_SEAT TOOL=<n>. Place the tool on the head by hand first.")}
    {% endif %}
    {% set t = params.TOOL|int %}
    {% if t < 0 or t >= tp.tool_count|int %}
        {action_raise_error("T%d is not configured. %d tools available (T0-T%d)."
            % (t, tp.tool_count|int, tp.tool_count|int - 1))}
    {% endif %}

    # Warn, do not refuse: the cell may be untared this early in a build, and
    # refusing here would close the same circle this macro exists to open.
    {% if "load_cell_probe" in printer %}
        {% set lc = printer.load_cell_probe %}
        {% set fg = lc.force_g|default(none) %}
        {% if lc.is_calibrated|default(false) and fg is not none
              and fg|float|abs < tp.home_min_force_g|default(800.0)|float %}
            RESPOND TYPE=error MSG="MANUAL_TOOL_SEAT: load cell reads {"%.0f"|format(fg|float)} g, which looks like an empty head. Claiming T{t} anyway - check the tool is actually seated before homing Z."
        {% endif %}
    {% endif %}

    # Lock, then drive further at low speed to reach full locking force, the
    # same way CALIBRATE_LOAD_CELL_APPLY seats a hand-placed tool.
    _TC_SET_ROTATION_DIST
    _TC_LATCH_MOVE E={c.full_lock_e} F={c.latch_feedrate} I={c.run_current}
    _TC_LATCH_MOVE E=10 F=300 I={c.run_current}
    _TC_RESTORE_ROTATION_DIST
    M400

    SET_GCODE_VARIABLE MACRO=_TOOLCHANGE_VARS VARIABLE=toolhead_state VALUE=0
    SAVE_VARIABLE VARIABLE=toolhead_state VALUE=0
    SAVE_VARIABLE VARIABLE=seat_suspect VALUE=-1
    _INDX_SET_ACTIVE_TOOL TOOL={t}
    RESPOND MSG="Latch locked, T{t} claimed. G28 Z will now probe with it. If this is not the tool that is physically on the head, run MANUAL_TOOL_REMOVE and start again."

[gcode_macro MANUAL_TOOLHEAD_RESET]
description: ⚠️ Resets toolhead macro status to OPEN & EMPTY - USE WITH CAUTION! ⚠️
gcode:
    SET_GCODE_VARIABLE MACRO=_TOOLCHANGE_VARS VARIABLE=toolhead_state VALUE=2
    SAVE_VARIABLE VARIABLE=toolhead_state VALUE=2
    SAVE_VARIABLE VARIABLE=seat_suspect VALUE=-1
    _INDX_SET_ACTIVE_TOOL TOOL=-1
    M400
    TOOL_STATUS
    RESPOND MSG="⚠️ WARNING! The toolhead status & active tool have been RESET to OPEN & EMPTY!!"
