hatchna/INDX/macros/indx-helpers.cfg

#####################################################################
#  INDX HELPERS
#####################################################################
#
#  CREDIT / ATTRIBUTION:
#  Author / Source: Charlie Mayall (charliemayall)
#  Repository: https://github.com/charliemayall/INDX
#  Original Feature: INDX latch and state helpers.
#
#  Include after indx-tc-macros.cfg in printer.cfg:
#    [include indx/indx-tc-macros.cfg]
#    [include indx/indx-helpers.cfg]
#
#  Latch (in place, no dock move):
#    INDX_LOCK
#    INDX_UNLOCK
#    INDX_FORCE_STATE ACTIVE_TOOL=<n|-1>   # soft-state only
#
#  Tool presence is checked by the load cell seat and park checks in
#  indx-tc-macros.cfg. This file no longer overrides RESUME, so the
#  printer's own RESUME (Mainsail's, or macros/resume_print.cfg) is used.
#
#####################################################################

[gcode_macro INDX_FORCE_STATE]
description: Set ACTIVE_TOOL soft-state only (no latch move). ACTIVE_TOOL=<n|-1>
gcode:
    {% if "ACTIVE_TOOL" not in params %}
        {action_raise_error("Usage: INDX_FORCE_STATE ACTIVE_TOOL=<n|-1>")}
    {% endif %}
    {% set t = params.ACTIVE_TOOL|int %}
    {% set n = printer["gcode_macro TOOL_POSITIONS"].tool_count|int %}
    {% if t < -1 or t >= n %}
        {action_raise_error("ACTIVE_TOOL=%d out of range (-1..%d)"|format(t, n - 1))}
    {% endif %}
    _INDX_SET_ACTIVE_TOOL TOOL={t}
    RESPOND MSG="INDX_FORCE_STATE: active_tool={'NONE' if t < 0 else ('T' ~ t)}"

[gcode_macro INDX_UNLOCK]
description: Open latch in place (no dock dance)
gcode:
    {% set c = printer["gcode_macro _INDX_CONSTANTS"] %}
    _TC_SET_ROTATION_DIST
    _TC_LATCH_MOVE E={c.full_open_e} F={c.latch_feedrate} I={c.run_current}
    _TC_RESTORE_ROTATION_DIST
    SET_GCODE_VARIABLE MACRO=_TOOLCHANGE_VARS VARIABLE=toolhead_state VALUE=2
    SAVE_VARIABLE VARIABLE=toolhead_state VALUE=2
    RESPOND MSG="INDX_UNLOCK: latch open"

[gcode_macro INDX_LOCK]
description: Close latch in place (no dock dance)
gcode:
    {% set c = printer["gcode_macro _INDX_CONSTANTS"] %}
    _TC_SET_ROTATION_DIST
    _TC_LATCH_MOVE E={c.full_lock_e} F={c.latch_feedrate} I={c.run_current}
    _TC_RESTORE_ROTATION_DIST
    SET_GCODE_VARIABLE MACRO=_TOOLCHANGE_VARS VARIABLE=toolhead_state VALUE=0
    SAVE_VARIABLE VARIABLE=toolhead_state VALUE=0
    RESPOND MSG="INDX_LOCK: latch locked"
