hatchna/INDX/macros/cancel_print.cfg

#####################################################################
#  CANCEL_PRINT - Print Cancellation Routine
#####################################################################
#
#  CREDIT / ATTRIBUTION:
#  Author / Source: Nathan Hatch (hatchna)
#  Repository: https://github.com/hatchna/INDX
#  Description: Customized print cancellation routine turning off heaters,
#               parking toolhead at the rear, lowering the bed, clearing
#               mesh, and controlling caselight/Nevermore accessories.
#
#####################################################################

[gcode_macro CANCEL_PRINT]
rename_existing: CANCEL_PRINT_BASE
gcode:
    {% set th = printer.toolhead %}
    {% set z_park = [150, th.axis_maximum.z]|min if th.position.z < 150 else [th.position.z + 5, th.axis_maximum.z]|min %}

    CANCEL_PRINT_BASE

    # PARK_TOOL  ## TEMPORARILY DISABLED: Debating if wanted.

    TURN_OFF_HEATERS
    
    G90                                      ; absolute positioning
    G0 X{th.axis_maximum.x//2} Y{th.axis_maximum.y - 2} F3600  ; park nozzle at rear
    G0 Z{z_park} F3600                       ; lower bed
    M107                                     ; turn off fan
    
    SET_PIN PIN=caselight VALUE=0.20
    BED_MESH_CLEAR
    SET_PIN PIN=nevermore VALUE=0
