hatchna/INDX/macros/print_end.cfg

#####################################################################
#  PRINT_END - Slicer Ending Script
#####################################################################
#
#  CREDIT / ATTRIBUTION:
#  Author / Source: Nathan Hatch (hatchna)
#  Repository: https://github.com/hatchna/INDX
#  Description: Slicer ending routine with safe anti-stringing nozzle
#               travel, filament retraction, heater shutdown, bed drop,
#               and enclosure accessory turn-off.
#
#####################################################################

[gcode_macro PRINT_END]
#   Use PRINT_END for the slicer ending script - please customise for your slicer of choice
gcode:
    # safe anti-stringing move coords
    {% set th = printer.toolhead %}
    {% set x_safe = th.position.x + 20 * (1 if th.axis_maximum.x - th.position.x > 20 else -1) %}
    {% set y_safe = th.position.y + 20 * (1 if th.axis_maximum.y - th.position.y > 20 else -1) %}
    {% set z_safe = [th.position.z + 2, th.axis_maximum.z]|min %}
    {% set z_park = [150, th.axis_maximum.z]|min if th.position.z < 150 else [th.position.z + 5, th.axis_maximum.z]|min %}
    
    SAVE_GCODE_STATE NAME=STATE_PRINT_END
    
    M400                           ; wait for buffer to clear
    G92 E0                         ; zero the extruder
    G1 E-2.0 F3600                 ; retract filament
    
    # INDX: Return the current tool to the dock before turning off heaters.
    # The passive tool cools on its own once separated from the Smart Head.
    # PARK_TOOL  ## TEMPORARILY DISABLED: Debate if wanted.

    TURN_OFF_HEATERS
    
    G90                                      ; absolute positioning
    G0 X{x_safe} Y{y_safe} Z{z_safe} F20000  ; move nozzle to remove stringing
    G0 X{th.axis_maximum.x//2} Y{th.axis_maximum.y - 2} F3600  ; park nozzle at rear
    G0 Z{z_park} F3600
    M107                                     ; turn off fan
    
    SET_PIN PIN=caselight VALUE=0.20
    BED_MESH_CLEAR
    RESTORE_GCODE_STATE NAME=STATE_PRINT_END
    SET_PIN PIN=nevermore VALUE=0
