hatchna/INDX/(commit log)

2026-08-21 Renamed XY tool offsets macros
    Klipper would fail to run the XY tool offsets macros as named originally.
    [indx-cal.cfg]
2026-08-21 Update tool changes to avoid print scraping
    Borrowed changes from 3DPrintDemon's macros to delay the z_restore on tool change until after the tool has moved back to the XY print coordinates. This was to prevent the nozzle dragging across the print as was happening initially.
    [indx-tc-macros.cfg]
2026-08-21 Added multi-filament Spoolman config.
    Added Spoolman support for multi-tool multi-filament setup to enable multi-tool filament tracking through Fluidd and Mainsail.
    [indx.cfg]
2026-08-26 Update indx-cal.cfg macros
    Added spoolman tracking to filament load macro. Also added custom unload_filament macro with tool change logic and filament and spoolman tracking.
    [indx-cal.cfg]
2026-08-26 Update indx-tc-macro with spoolman tracking
    Added spoolman tracking to TOOL_CHANGE macro.
    [indx-tc-macros.cfg]
2026-08-26 Adding custom macros
    Adding custom PRINT_START, PRINT_END and CANCEL_PRINT macros.
    [cancel_print.cfg, print_end.cfg, print_start.cfg]
2026-08-26 Updating macro files to better provide proper credit to other coders.
    [cancel_print.cfg, homing.cfg, indx-cal.cfg, indx-helpers.cfg, indx-tc-macros.cfg, indx.cfg, m104.cfg, m109.cfg]
2026-08-27 Update nozzle parking and z-park on print end or cancel.
    [cancel_print.cfg, print_end.cfg]
2026-11-01 Update T3 dock X to the position measured on the printer
    [indx.cfg]
2026-11-01 Lower seat_min_force_g to 600 g for this printer's lower seat readings
    Seated tools read 727-915 g here, leaving T2 and T4 about 47 g above
    the 680 g default.
    [indx.cfg]
2026-11-01 Read saved tool state when INIT_STATE runs, not when its timer fires
    A delayed_gcode template renders when the timer fires and then waits
    for any running command. A PARK_TOOL sent right after a restart parked
    T0 and saved active_tool=-1, then INIT_STATE wrote back the stale T0
    and locked state. The next PRINT_START skipped the pickup and heated
    an empty head, tripping the heater model check.
    [indx-tc-macros.cfg]
2026-11-01 PRINT_START: check the load cell for a tool before heating
    Bring in the printer's newer PRINT_START (RESET_GLOBAL_Z before G28 Z,
    5 mm smart park height). After the first CHANGE_TOOL, read the load
    cell against the empty-head calibration; an empty head stops the
    print before anything heats, and un-homes the faked Z so the cancel
    does not move from a made-up origin.
    [print_start.cfg]
2026-11-01 Remove VERIFY_TOOL_PRESENT and the RESUME override from indx-helpers
    VERIFY_TOOL_PRESENT came without its tool_detect_* settings or the
    pickup call that used it, so it never ran and passed anything. The
    load cell seat and park checks now cover tool presence.
    The RESUME override loaded after mainsail.cfg and resume_print.cfg and,
    with no _CLIENT_RESUME defined, replaced them with a bare RESUME_BASE,
    skipping temperature restore, runout check, the resume extrude and
    re-enabling the filament sensor. Without it the printer's own RESUME
    is used again.
    [indx-helpers.cfg]
2026-11-08 PRINT_START: remove the absolute load cell tool check
    The check compared one load cell reading against a fixed 400 g, but the
    absolute reading drifts by hundreds of grams. A seated T0 read -350 g and
    stopped prints as "no tool on the head", and an empty head could drift
    past the limit the same way.
    The pickup and park checks stay: they compare readings taken seconds
    apart, so drift does not affect them.
    [print_start.cfg]
2026-11-10 Mesh with Beacon unless a probe is named
    The load cell is the default probe because INDX homes Z with it, so
    [beacon] has register_as_probe: false. Beacon's BED_MESH_CALIBRATE
    then passes any mesh aimed at the default probe to stock bed_mesh,
    which taps every point with the load cell.
    Wrap BED_MESH_CALIBRATE to add PROBE_METHOD=proximity when neither
    PROBE nor PROBE_METHOD is given, so meshes from PRINT_START, Fluidd
    and HelixScreen use Beacon's scan. ADAPTIVE=1 still works.
    [print_start.cfg]
2026-11-12 Park check: let the load cell settle before the after-park reading
    The after-park reading ran M400 then G4 P250, and G4 only queues the dwell, so the load cell was read the moment the exit ended. Its force_g is a 0.5 s running average, which still held samples from before the release. A clean T1 park read 377 g and cancelled a print. Dwell 600 ms and wait for it, as the pickup check already does, and log the change on a passing park.
    [indx-tc-macros.cfg]
2026-11-12 PRINT_START: tilt, tap and mesh on a hot bed, pick up the print tool after
    G28 Z always taps with T0, so picking the print tool before it only got
    swapped straight back. Home on T0, wait for the bed, tilt, then take the
    G28 Z that sets Z=0 after the tilt, and mesh. The print tool is picked up
    with its heater off, parked over the bed with SMART_PARK and heated there,
    so it lays the purge line without oozing at the dock.
    Also clear any old mesh first, and stop early on missing temperatures or
    an unconfigured TOOL. The header notes that [bed_mesh]
    zero_reference_position must match the tap point.
    [print_start.cfg]
